oleksandrkorkh/Fuse_board/Test reports/V1 lifetime tests/pictures/Fuse Blow Test/Fuseboard_fuse_blow_test.jpg

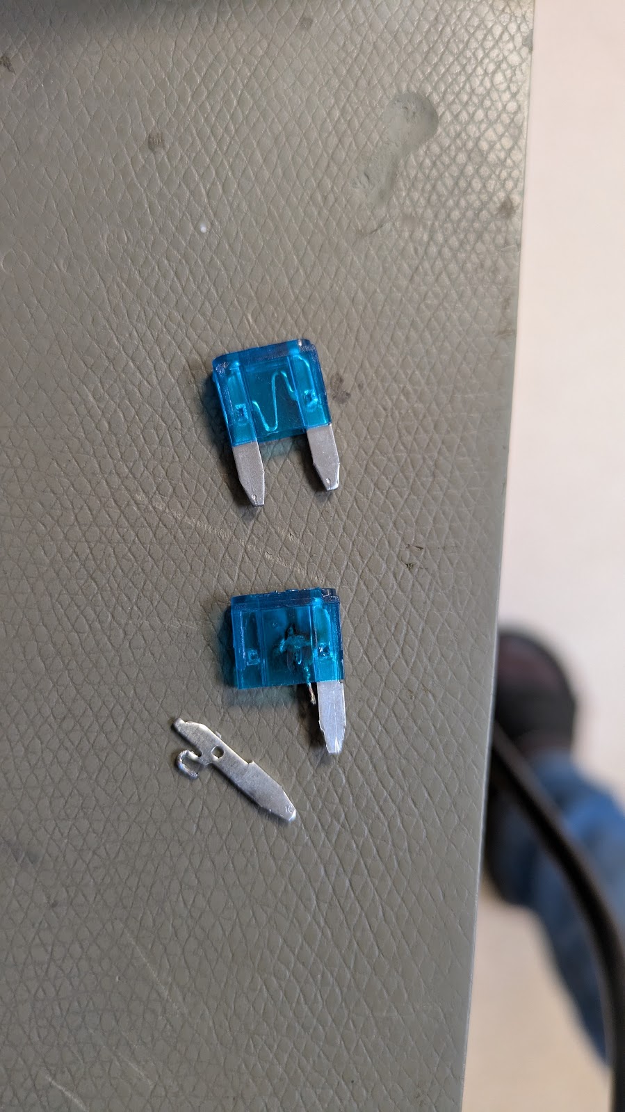
Test reports/V1 lifetime tests/pictures/Fuse Blow Test/Fuseboard_fuse_blow_test.jpg
