oleksandrkorkh/Fuse_board/Electronics/3V3 LDO/3V3 LDO design descriptiondocx.docx

# Introduction

3V3 LDO is required to power analogue circuits due to 3V3 SMPS having too high output ripple. LDO current capability has been calculated in 3.3V domain power consumption.xlxs document. Part number for the LDO has also

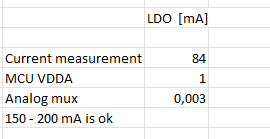
[picture p3: figure]

Figure 1 Current requirement calculation

# Circuit design

LDO circuit is designed after manufacturers typical application circuit and it has already been verified on other projects.

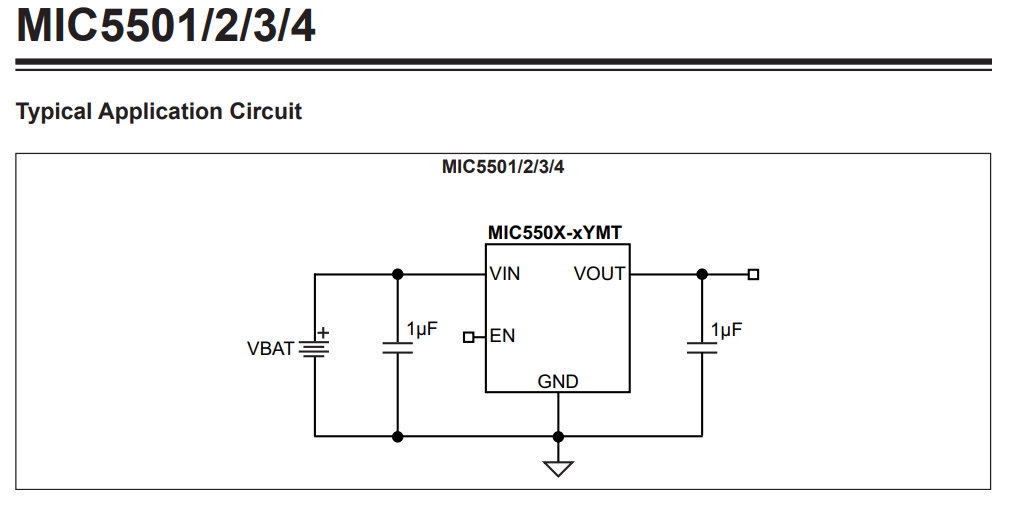
[picture p4: figure]

Figure 2 LDO manufacturers typical suggested circuit

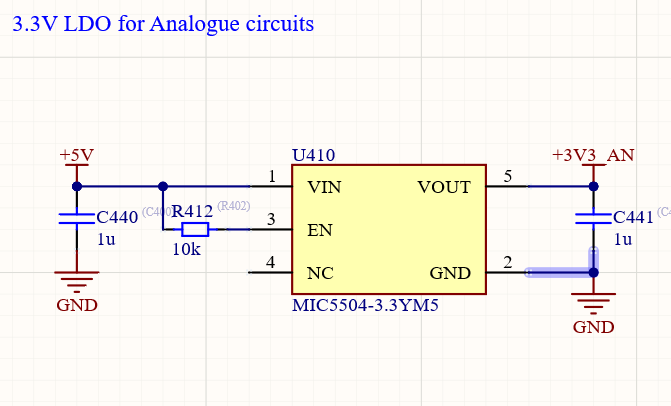
[picture p5: figure]

Figure 3. LDO implementation in the project

info@krakul.eu1

Project nr Document Author KR-Df-01 3V3 LDO design description Kaarel Koppel
