oleksandrkorkh/Fuse_board/Electronics/MCU/MCU design description.docx

# Introduction

STM32H573VIT6 is the MCU selected.

# High speed crystal oscillator

Evaluation kit has the following circuit.

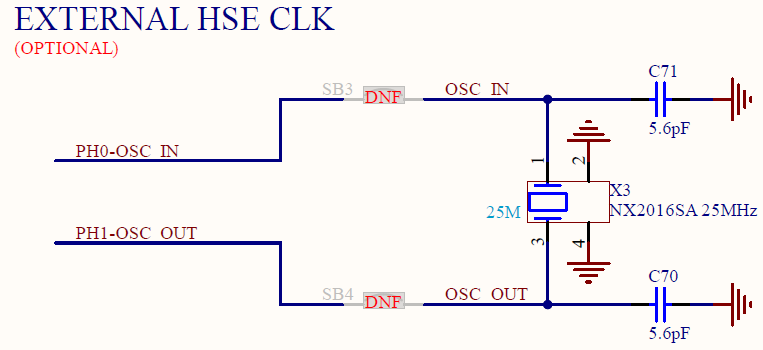
[picture p33: figure]

Figure 1: NUCLEO-H563ZI development board for STM32H563ZIT6 MCU

Acceptable external clock frequency range for the MCU is 4 to 50 MHz.

Typical circuit is suggested by the ST Application Note AN5711.

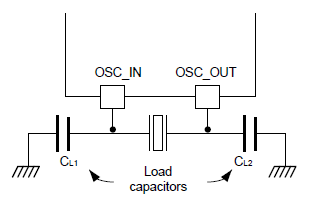
[picture p34: figure]

Figure 2: Typical application schematic

Datasheet suggests 10pF as PCB and MCU parasitic capacitance. This seems much and 6pF is used as approximation. Equation C1=C2=2 * (CL – Cstray) is used and it gives C1=C2=8pF. Closest nominal is 8,2pF.

ECS-250-10-37B-CTN-TR was selected from Krakul component library. It’s a 25MHz ±10ppm 10pF crystal.

# Power supply

VDD – Supply for I/O-s, internal regulator, reset, power management and internal clocks. 1.71 V – 3.6 V.

VDDA – Supply for ADC, DAC. Will be connected to 3,3V trough a ferrite bead.

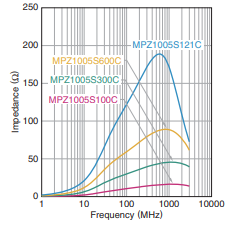
[picture p35: figure]

MPZ1005S121C is selected from Krakul library. Little effect is to be expected against regulator switching noise, but should reduce the RMII effect.

VDDUSB – USB supply 3.0 to 3.6V. Connect to VDD if not used.

VCAP1 and VCAP2 – 1.0 V – 1.2V. Digital core domain supply. Uses internal voltage regulator.

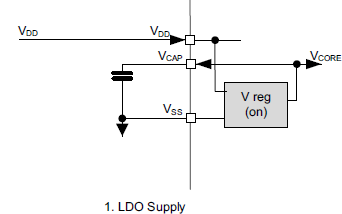
[picture p36: figure]

Figure 3: Vcore supply schematic.

Reference Manual RM0801 Rev 1 suggests 4,7 uF capacitor on VCAP pins. Single capacitor would create problems from layout side since pins 48 and 98 are at the opposite ends of the IC. Inspired from development board schematic both pins shall have a 2,2uF capacitor.

VREF+ and VREF- are for separate reference voltage if it needs to be different from VDD. In this case the VDDA +3,3V is the reference voltage.

VBAT is a backup supply for some registers and RTC. This function is not used in this application and the pin is left floating.

# RGB LED driver

Timer output capable of 800kHz PWM is needed for correctly driving the RGB LED. PB10 (pin number 47) is TIM2_CH3. TIM2 is a general purpose timer. The pin was selected as close to a VSS (GND) pin as possible. The signal is almost 1MHz and it’s desired to keep the return current path as short as possible.

# ADC

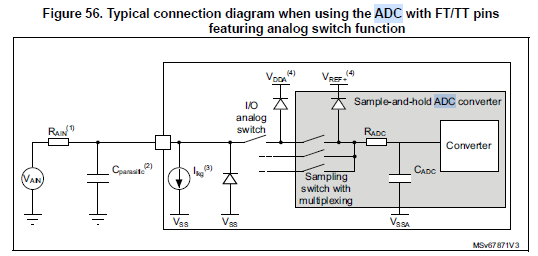
[picture p37: figure]

Figure 4: ADC input

Due to limited number of ADC inputs on the STM32H573VIT6 analog multiplexers are used.

There are 2 8 channel MUX that are controlled with digital pins. One MUX is for power output current measurement and the other is for power output voltage measurement.

TMUX1208PWR is selected for it’s price.

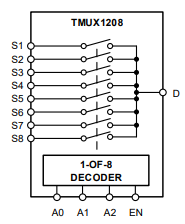
[picture p38: figure]

Figure 5: TMUX1208 internal diagram

Besides decoupling capacitor other external components are not mandatory, but 100Ω resistors will be added to encoding and enable pins.

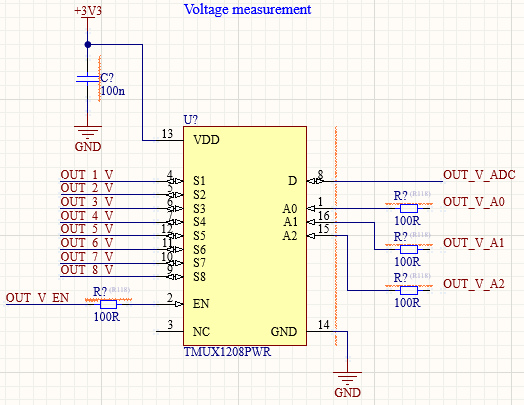
[picture p39: figure]

ADC input on the MCU shall not have the usual capacitor that can be used to mitigate the voltage drop created by sample and hold circuit. Extra capacitance on the trace from MUX to MCU creates a need to wait longer until the voltage at ADC stabilizes.

Instead the capacitors will be at the MUX inputs and the trace capacitance from MUX to MCU is kept minimum. This way 100nF capacitors before the MUX will force the ADC input to correct voltage relatively faster. The internal sample and hold capacitor inside this MCU is typically 3pF. Trace parasitic capacitance is likely order of magnitude greater.

# Configuration switch

To set HW mode for the MCU 8-bit dip switch is added.

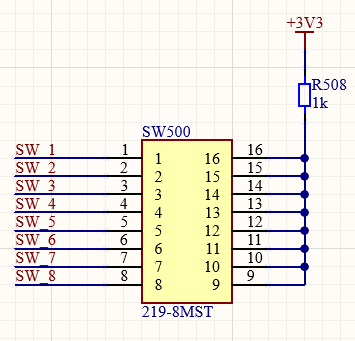
[picture p40: figure]

Figure 6: HW configuration switch.

Switch functions TBD.

# Programming interface

Serial wire debug (SWD) will be used for firmware download and debugging. It has following signals.

6 pin Tag connect with clamping legs will be used. SWD and reset signals have 100R series resistors and TVS diodes for short circuit and ESD protection.

3.3V connection has a series 0R resistor that can be removed if necessary.

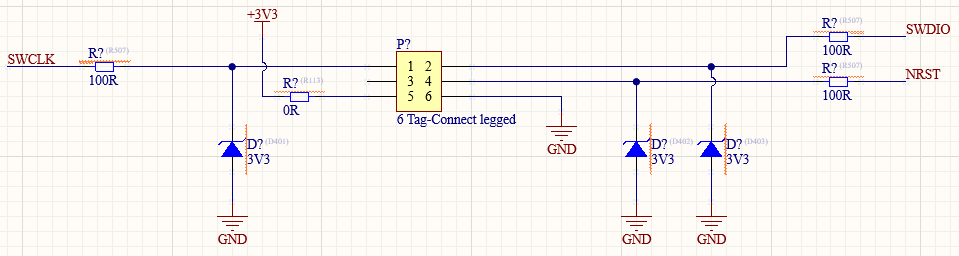
[picture p41: figure]

# Reset button.

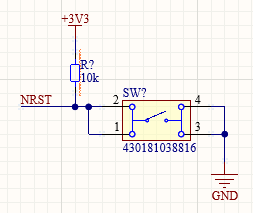
[picture p42: figure]

The button is for resetting the MCU manually during development phase.

info@krakul.eu1

Project nr Document Author KR-Df-01 Fuse board design description Indrek Keskküla
