oleksandrkorkh/Fuse_board/Specifications/2024-08-13 SW tasks estimation.xlsx

Task | Estimation (h)
On-board file system setup | 20
Create data storage manager | 20
Implement DHCP based IP acquiring | 10
Modbus RS-485 driver | 30
Modbus Etherner-RS-485 bridge | 30
Identification registers implementation | 6
Memory layout | 6
Configuration registers implementation | 20
Operational registers implementation | 10
Full relay logic implementation | 12
Critical error logging | 10
Top level operation logic | 20
Bootloader | TBD
Total | 194
