oleksandrkorkh/Fuse_board/Electronics/3V3 SMPS/3.3V domain power consumption.xlsx

 |  |  |  | LDO [mA]
Load | MAX[mA] | Notes
RS485 | 83.5 |  | Current measurement | 84
MCU | 203 |  | MCU VDDA | 1
Ethernet Phy | 129 |  | Analog mux | 0.003
Current measurement | 84 | 8 devices 10,5 mA maximum | 150 - 200 mA is ok
Total | 499.5 | mA
 |  |  | Feedtrough capacitors for analog switch control lines
1 A regulator is enough
 |  |  | SMPS frequency
Vout | 3.3
Cout
 |  |  |  |  | 3.3V Output
 |  |  | NFM18CC222R1C3D Murata Electronics | Mouser Estonia (https://www.mouser.ee/ProductDetail/Murata-Electronics/NFM18CC222R1C3D?qs=s6ARpXo6tuq4Pwfcr30BUw%3D%3D)
 |  |  | Light load
 |  |  | Period
 |  |  | 162337.6623 | Hz
 |  |  | Only some kHz | Feedtrogh capacitor does nothing. Skip
 |  |  | This one in Krakul library
 |  |  | Name | Value
 |  |  | Part number | MIC5504-3.3YM5
