oleksandrkorkh/Fuse_board/Electronics/MCU/PIN Map.xlsx

Sheet: Sheet1
Inputs | 8
Outputs | 8
ADCs | 18
Programming SWD | 4
Crystal | 2
RMII | 9
UART/ RS-485 | 2
neopixel | 2
STM32H563ZIT3Q (https://estore.st.com/en/stm32h563zit3q-cpn.html)
Must select 144 pin device |  | 100 pin device does not support ethernet and 125 operating temperature at the same time

Sheet: QFN100
 |  | STM32H573VIT6 | STM32H573VIT6 - eStore - STMicroelectronics (https://estore.st.com/en/stm32h573vit6-cpn.html)
Pin Nr | Pin Name | Function | Comment
1 | PE2 | RS485_T
2 | PE3 | OUT_I_EN | Current measurement MUX control
3 | PE4 | OUT_I_A0
4 | PE5 | OUT_I_A1
5 | PE6 | OUT_I_A2
6 | VBAT | POWER
7 | PC13
8 | PC14-OSC32_IN
9 | PC15-OSC32_OUT
10 | VSS
11 | VDD
12 | PH0-OSC_IN | Crystal
13 | PH1-OSC_OUT | Crystal
14 | NRST | Reset
15 | PC0
16 | PC1 | RMII_MDC | +
17 | PC2
18 | PC3 | PWR_IN_V_ADC
19 | VSSA | POWER
20 | VREF- | POWER
21 | VREF+ | POWER
22 | VDDA | POWER
23 | PA0 | ETH_nRST
24 | PA1 | RMII_REFCLK | +
25 | PA2 | RMII_MDIO | +
26 | PA3
27 | VSS | POWER
28 | VDD | POWER
29 | PA4
30 | PA5 | RMII_TXEN | +
31 | PA6
32 | PA7 | RMII_CRS_DV | +
33 | PC4 | RMII_RXD0
34 | PC5 | RMII_RXD1
35 | PB0 | OUT_V_ADC
36 | PB1 | OUT_I_ADC
37 | PB2
38 | PE7 | OUT_V_EN | Voltage measurement MUX control
39 | PE8 | OUT_V_A0
40 | PE9 | OUT_V_A1
41 | PE10 | OUT_V_A2
42 | PE11
43 | PE12
44 | PE13 | LED_PWR_EN
45 | PE14
46 | PE15
47 | PB10 | LED_DATA
48 | VCAP | POWER
49 | VSS | POWER
50 | VDD | POWER
51 | PB12 | RMII_TXD0
52 | PB13
53 | PB14
54 | PB15 | RMII_TXD1
55 | PD8 | OUT_1_EN | Active HIGH. Drive high to enable output. Pull-up/-down not needed.
56 | PD9 | OUT_2_EN
57 | PD10 | OUT_3_EN
58 | PD11 | OUT_4_EN
59 | PD12 | OUT_5_EN
60 | PD13 | OUT_6_EN
61 | PD14 | OUT_7_EN
62 | PD15 | OUT_8_EN
63 | PC6
64 | PC7
65 | PC8 | USB_SOF - Reserved
66 | PC9 | USB_DM - Reserved
67 | PA8 | USB_DP - Reserved
68 | PA9
69 | PA10
70 | PA11
71 | PA12
72 | PA13 | SWDIO
73 | VDDUSB | POWER
74 | VSS | POWER
75 | VDD | POWER
76 | PA14 | SWCLK
77 | PA15 | BTN_1 | Button inputs. Activate internal pull-down for these inputs.
78 | PC10 | BTN_2
79 | PC11 | BTN_3
80 | PC12 | BTN_4
81 | PD0 | BTN_5
82 | PD1 | BTN_6
83 | PD2 | BTN_7
84 | PD3 | BTN_8
85 | PD4
86 | PD5 | SW_1 | HW configuration switch input
87 | PD6 | SW_2
88 | PD7 | SW_3
89 | PB3 | SW_4
90 | PB4 | SW_5
91 | PB5 | SW_6
92 | PB6 | SW_7
93 | PB7 | SW_8
94 | BOOT0
95 | PB8
96 | PB9 | RS485_DIR
97 | PE0 | RS485_R
98 | VCAP | POWER
99 | VSS | POWER
100 | VDD | POWER

Sheet: PIN Map QFN100 SMPS
 |  |  | Ethernet functions
1 | PE2 | BTN1
2 | PE3 | BTN2
3 | PE4 | BTN3
4 | PE5 | BTN4 |  | MII | 17 signals
5 | PE6 | BTN5 |  | RMII | 9 signals
6 | VBAT
7 | PC13 | BTN6
8 | PC14-OSC32_IN | BTN7
9 | PC15-OSC32_OUT | BTN8
10 | VSS
11 | VDD
12 | PH0-OSC_IN
13 | PH1-OSC_OUT
14 | NRST
15 | PC0 | LED_DATA
16 | PC1 | LED_PWE_EN
17 | PC2
18 | PC3
19 | VSSA
20 | VREF+
21 | VDDA
22 | PA0
23 | PA1 |  | ETH_RMII_REF_CLK
24 | PA2
25 | PA3
26 | VSS
27 | VDD
28 | PA4
29 | PA5 |  | ETH_RMII_TX_EN
30 | PA6
31 | PA7 |  | ETH_RMII_CRS_DV
32 | PB0
33 | PB1
34 | PB2
35 | PE7
36 | PE8
37 | PE9
38 | PE10
39 | PE11
40 | PE12
41 | PE13
42 | PE14
43 | PE15
44 | PB10
45 | PB11 |  | ETH_RMII_TX_EN
46 | VLXSMPS
47 | VDDSMPS
48 | VSSSMPS
49 | VCAP
50 | VSS
51 | VDD
52 | PB13
53 | PB14
54 | PB15 |  | ETH_RMII_TXD1
55 | PD8
56 | PD9
57 | PD10
58 | PD11
59 | PD12
60 | PD13
61 | PD14
62 | PD15
63 | PC6
64 | PC7
65 | PC8
66 | PC9
67 | PA8
68 | PA9
69 | PA10
70 | PA11
71 | PA12
72 | PA13
73 | VDDUSB
74 | VSS
75 | VDD
76 | PA14
77 | PA15
78 | PC10 |  | ETH_RMII_TXD0
79 | PC11
80 | PC12
81 | PD0
82 | PD1
83 | PD2
84 | PD3
85 | PD4
86 | PD5
87 | PD6
88 | PD7
89 | PB3
90 | PB4
91 | PB5
92 | PB6
93 | PB7
94 | BOOT0
95 | PB8
96 | PB9
97 | PE0
98 | VCAP
99 | VSS
100 | VSS

Sheet: QFN144 SMPS
1 | PE2
2 | PE3 |  | STM32H573VI | These two does not have
3 | PE4 |  | STM32H573ZI
4 | PE5
5 | PE6
6 | VBAT | Power
7 | PC13
8 | PC14-OSC32_IN | Not used
9 | PC15-OSC32_OUT | Not used
10 | PF0
11 | PF1
12 | PF2
13 | PF3
14 | PF4
15 | PF5
16 | VSS | Power
17 | VDD | Power
18 | PF6
19 | PF7
20 | PF8
21 | PF9
22 | PF10
23 | PH0-OSC_IN | Crystal
24 | PH1-OSC_OUT | Crystal
25 | NRST | nReset
26 | PC0
27 | PC1
28 | PC2
29 | PC3
30 | VSSA | Power
31 | VREF+ | Power
32 | VDDA | Power
33 | PA0
34 | PA1 | ETH_RMII_REF_CLK
35 | PA2
36 | PA3
37 | VSS | Power
38 | VDD | Power
39 | PA4
40 | PA5 | ETH_RMII_TX_EN
41 | PA6
42 | PA7 | ETH_RMII_CRS_DV
43 | PB0
44 | PB1
45 | PB2
46 | PF11
47 | PF12
48 | VSS | Power
49 | VDD | Power
50 | PF13
51 | PF14
52 | PF15
53 | PG0
54 | PG1
55 | PE7
56 | PE8
57 | PE9
58 | VSS | Power
59 | VDD | Power
60 | PE10
61 | PE11
62 | PE12
63 | PE13
64 | PE14
65 | PE15
66 | PB10
67 | PB11 | ETH_RMII_TX_EN
68 | VLXSMPS | Power
69 | VDDSMPS | Power
70 | VSSSMPS | Power
71 | VCAP | Power
72 | VSS | Power
73 | VDD | Power
74 | PB13
75 | PB14
76 | PB15 | ETH_RMII_TXD_1
77 | PD8
78 | PD9
79 | PD10
80 | PD11
81 | PD12
82 | PD13
83 | VSS | Power
84 | VDD | Power
85 | PD14
86 | PD15
87 | PG2
88 | PG3
89 | PG4
90 | PG5
91 | PG6
92 | PG7
93 | PG8
94 | VSS | Power
95 | VDD | Power
96 | PC6
97 | PC7
98 | PC8
99 | PC9
100 | PA8
101 | PA9
102 | PA10
103 | PA11
104 | PA12
105 | PA13
106 | VDDUSB | Power
107 | VSS | Power
108 | VDD | Power
109 | PA14
110 | PA15
111 | PC10
112 | PC11 | ETH_RMII_TXD_0
113 | PC12
114 | PD0
115 | PD1
116 | PD2
117 | PD3
118 | PD4
119 | PD5
120 | VSS | Power
121 | VDDIO2 | Power
122 | PD6
123 | PD7
124 | PG9
125 | PG10
126 | PG12 | ETH_RMII_TXD_1
127 | PG13 | ETH_RMII_TXD_0
128 | PG14 | ETH_RMII_TXD_1
129 | VSS | Power
130 | VDD | Power
131 | PG15
132 | PB3
133 | PB4
134 | PB5
135 | PB6
136 | PB7
137 | BOOT0
138 | PB8
139 | PB9
140 | PE0
141 | PE1
142 | VCAP | Power
143 | VSS | Power
144 | VDD | Power
