oleksandrkorkh/Fuse_board/Electronics/Power output/Fuse board power output design notes.xlsx

Sheet: Sheet1
Relay |  |  |  |  |  | Connector for power
 |  |  |  |  |  | 5-1437657-7 - Buchanan - Te Connectivity - PCB Mount Barrier Terminal Block, 11.13 mm, 1 Row (farnell.com) (https://ee.farnell.com/te-connectivity-buchanan/5-1437657-7/terminal-block-barrier-2pos-10awg/dp/3399492)
https://ee.farnell.com/omron-electronic-components/p2r-05p/socket-pcb-g2r-3r-relay/dp/9945415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
V23074A2002A403-EV-CBOX - Te Connectivity - Automotive Relay, 24 VDC, 30 A (farnell.com) (https://ee.farnell.com/te-connectivity/v23074a2002a403-ev-cbox/automotive-relay-spdt-30a-24v/dp/2783747) |  |  | With diode | Use V23074-A1002-A403
VCFM-1000 - Te Connectivity - Relay Socket, Through Hole, Solder (farnell.com) (https://ee.farnell.com/te-connectivity/vcfm-1000/relay-socket-5-pos-tht/dp/3133659?st=1393310-2)
Fuse
MCCQ-122 - Multicomp Pro - Fuseholder, PCB Mount, Automotive (farnell.com) (https://ee.farnell.com/multicomp/mccq-122/fuseholder-pcb-mount-mini-blade/dp/1586595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)
Automotive relay rating seem low | 27V
1,4 x rated voltage on ok | Otsi dokumendist "limiting voltage" | DDEController (te.com) (https://www.te.com/commerce/DocumentDelivery/DDEController?Action=showdoc)
24V releel 33,4V
 |  |  |  |  | 5.85
 |  |  |  |  | 2.15 |  | 7.35

Sheet: PCB relay
General purpose relays: https://www.mouser.ee/c/electromechanical/relays-contactors-solenoids/general-purpose-relays/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
There are limited number of PCB mounted 24V relays available that have sufficient current ratings
T9GV5L14-24 : Potter & Brumfield PCB Power Relay: 30 amp, Monostable DC | TE Connectivity (https://www.te.com/usa-en/product-1558660-7.html)
This is one
G5LE-1-E DC24 Omron Electronics Inc-EMC Div | Relays | DigiKey (https://www.digikey.ee/en/products/detail/omron-electronics-inc-emc-div/G5LE-1-E-DC24/1277877)
Coil voltage to low for 32V operation. No overhead for short circuit currents (I-max = 16V)
J1071CS3VDC.36 CIT Relay and Switch | Relays | DigiKey (https://www.digikey.ee/en/products/detail/cit-relay-and-switch/J1071CS3VDC-36/18734612) |  |  |  | <-- | Go with this but test before first prototype.
3V coil. Current rating low, but should be tested |  |  |  |  | Available only at digikey | J1071CS3VDC.36
https://www.digikey.ee/en/products/detail/cit-relay-and-switch/J107F1CS203VDC-80/14001947
Better current rating, but coil current too high ~ 270 mA
J1071CS5VDC.36 |  |  | This fails when the current at the time of turn-off exceeds 5A |  |  |  | J1071CS5VDC.36 CIT Relay and Switch | Relays | DigiKey (https://www.digikey.com/en/products/detail/cit-relay-and-switch/J1071CS5VDC-36/18734609)
 |  |  | 22uF and 0,1 Ω snubber in parallel with the load allowd for 10A switching
I | 25 | A
C | 62.5 | uF
E0 | 32 | V
R | 0.04995121951 | Ω
Alternative
J107F1CS205VDC.45 (https://www.digikey.com/en/products/detail/cit-relay-and-switch/J107F1CS205VDC-45/14000915)
1200 W | 50A
24
4713-GMC31X5R336M25NTCT-ND |  |  | x 10
WSLP-.05CT-ND |  |  | x 10

Sheet: Terminal block
DGPS2.5R-5.0-02P |  |  | Current rating low
 |  |  | 10mm2 cross area requirement. AWG 8 | But no. Is ok
 |  |  |  | Except the lower cross section area
Cross section area must be up to 2,5mm2
Current up to 15A.
2,5mm2 | ~ | 13AWG
0,5mm2 | ~ | 20AWG
Truly only one option pops out
1986711-2 TE Connectivity AMP Connectors | Connectors, Interconnects | DigiKey (https://www.digikey.ee/en/products/detail/te-connectivity-amp-connectors/1986711-2/3189857)
 |  |  |  | Is ok
