oleksandrkorkh/Fuse_board/Electronics/RS485/RS485 design description.xlsx

DE09-PT-1-JS Adam Tech | Connectors, Interconnects | DigiKey (https://www.digikey.ee/en/products/detail/adam-tech/DE09-PT-1-JS/9832576)
L717TSEH09POL2RM8 Amphenol ICC (Commercial Products) | Connectors, Interconnects | DigiKey (https://www.digikey.ee/en/products/detail/amphenol-cs-commercial-products/L717TSEH09POL2RM8/4886900)
Use this. Has 3D models and better mechanical attachment to PCB
L717TSEH09POL2RM8
