oleksandrkorkh/Fuse_board/Electronics/5V SMPS/SMPS calculations.xlsx

Vout | 5.07
Vfb | 1.011
Rfbt | 100000
Rfbb | 24907.61271
Vout | 5.07
