oleksandrkorkh/Fuse_board/Electronics/Ethernet/Ethernet design description.xlsx

 |  |  |  |  |  | ETH_REF_CLK
 |  |  |  |  |  | ETH_RXD[1:0]
 |  |  |  |  |  | ETH_RX_DV
 |  |  |  |  |  | ETH_CRS_DV
 |  |  |  |  |  | ETH_RX_ER
 |  |  |  |  |  | ETH_TXD[1:0]
 |  |  |  |  |  | ETH_TX_EN
 |  |  |  |  | ETH_MDC
 |  |  |  |  | ETH_nRST
 |  |  |  |  | ETH_RMII_REF_CLK
 |  |  |  |  | ETH_MDIO
 |  |  |  |  | ETH_RMII_TX_EN
 |  |  |  |  | ETH_RMII_CRS_DV
 |  |  |  |  | ETH_RMII_RXD0
 |  |  |  |  | ETH_RMII_RXD1
 |  |  |  |  | ETH_RMII_TXD0
 |  |  |  |  | ETH_RMII_TXD1
 | Length tables
Signal | Before resistor | After resistor | Total | Dif
RMII_TXD1 | 40.344 | 5.216 | 45.56
RMII_TXD0 | 41.317 | 4.203 | 45.52 | 0.04
RMII_RXD1 | 42.392 | 3.197 | 45.589 | -0.029
RMII_RXD0 | 41.934 | 3.59 | 45.524 | 0.036
RMII_CRC_DV | 42.247 | 3.273 | 45.52 | 0.04
RMII_TXEN | 36.073 | 9.394 | 45.467 | 0.093
RMII_MDIO | 45.564 |  | 45.564 | -0.004
RMII_REFCLK | 41.311 | 4.183 | 45.494 | 0.066
RMII_MDC | 45.643 |  | 45.643 | -0.083
