oleksandrkorkh/Fuse_board/Mechanics/Mechanics/2025.03.05 Case and base plate design/renders/jpeg/56f5e6a8-57b0-4b65-b9d8-96817e39d799.JPEG

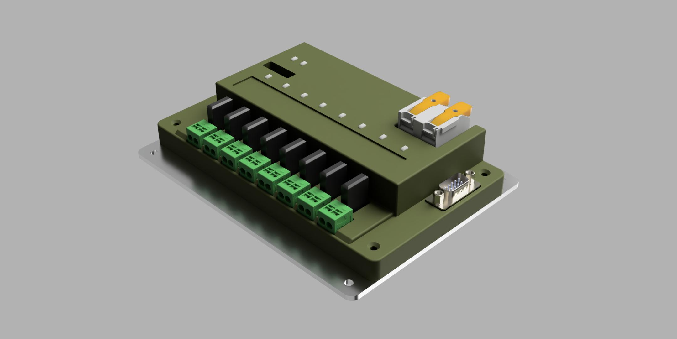
Mechanics/Mechanics/2025.03.05 Case and base plate design/renders/jpeg/56f5e6a8-57b0-4b65-b9d8-96817e39d799.JPEG
