oleksandrkorkh/Fuse_board/Electronics/BOM Exports/BOM Export 2023_12_04.xlsx

Line # | Name | Description | Designator | Revision ID | Revision State | Revision Status | Quantity | Manufacturer 1 | Manufacturer Part Number 1 | Manufacturer Lifecycle 1 | Supplier 1 | Supplier Part Number 1 | Supplier Unit Price 1 | Supplier Subtotal 1 | BOM Status
 | MCCQ-122 | Fuseholder, Pcb Mount, Mini Blade | F100, F101, F102, F103, F104, F105, F106, F107 | CMP-ROOT-01049-2 | Draft | Up to date | 8 | Multicomp | MCCQ-122 | Volume Production | Farnell | 1586595 | 0.68914 | 5.51 | Warning
 | 1393310-2 | Relay Accessories Relay Socket for Electromechanical Relay. Micro ISO | K100, K101, K102, K103, K104, K105, K106, K107 | CMP-ROOT-01050-1 | Draft | Up to date | 8 | TE Connectivity P&B | 1393310-2 | Volume Production | Newark | 90B5439 | 3.51 | 28.08 | Warning
 | RJLSE-42381-01T | Jack Modular Connector 8p8c (RJ45, Ethernet) 90° Angle (Right) Shielded | P200 | CMP-ROOT-00032-2 | Draft | Up to date | 1 | Amphenol Commercial | RJLSE4238101T | Volume Production |  |  |  |  | Fatal error
 | A-DS-09-A/KG-T2S | 09P D-SUBCONN R/A USA STANDARD | P300, P301 | CMP-ROOT-01022-1 | Draft | Up to date | 2 | Assmann | A-DS-09-A/KG-T2S | Volume Production | Arrow Electronics | A-DS 09 A/KG-T2S | 0.6563 | 1.31 | Warning
 | 430181038816 | Switch Tactile Spst-no 0.05A 12V | SW600, SW601, SW602, SW603, SW604, SW605, SW606, SW607 | CMP-ROOT-00883-1 | Draft | Up to date | 8 | Wurth Electronics | 430181038816 | Volume Production | Digi-Key | 732-7003-1-ND | 0.53 | 4.24 | Warning
Relay not part of PCBA BOM
P/N used in final assembly V23074-A1002-A403
