oleksandrkorkh/Fuse_board/Production files/PCBA-KR-Df-01-EL-00-MASTER-A.3/BOM/BOM_KR-Df-01-EL-00_vv1_2024-12-20.xlsx

Bill of Materials |  |  | KR-Df-01-EL-00
Source Data From: |  | KR-Df-01-EL-00.BomDoc
Project: |  | Fuse Board
Variant: |  | Master
Project EE: |  | IK
Creation Date: | 20/12/2024 | 15:21
Print Date: | 2024-12-20 | 15:21:44
Production Quantity: | 10
Currency | EUR
BOM cost per unit | 0
Part number | Quantity | Description | Designator | LibRef | Manufacturer | Supplier 1 | Supplier Part Number 1 | Supplier Order Qty 1 | Supplier Unit Price 1 | Supplier Subtotal 1
SN65HVD12DR | 1 | 1/1 Transceiver Half RS422, RS485 8-SOIC | U300 | CMP-ROOT-01068-1 | TI
744029001 | 1 | 1µH Shielded Wirewound Inductor 2.2A 55mOhm Max Nonstandard | L400 | CMP-ROOT-00305-1 | Wurth Electronics Inc.
MIC5504-3.3YM5 | 1 | 3.3V 300mA LDO | U410 | CMP-ROOT-00999-4 | Microchip Technology
TMUX1208PWR | 2 | 5-V, 8: 1, 1-channel general-purpose analog multiplexer with 1.8-V input logic 16-TSSOP -40 to 125 | U501, U502 | CMP-ROOT-01067-2 | TI
CRCW060310R0JNEAHP | 2 | 10R 0603 Pulse-proof 1/3W | R301, R304 | CMP-0001-00279-2 | Vishay
ECS-250-10-37B-CTN-TR | 2 | 25MHz ±10ppm Crystal 10pF 50 Ohms 4-SMD, No Lead | Xtal200, Xtal500 | CMP-001-1313-1 | ECS Inc.
STM32H573VIT6 | 1 | Armï¿½ Cortexï¿½-M33 32-bit MCU+TrusZoneï¿½ + FPU, 360 DMIPS @240MHz, 2 Mbytes Flash, 640 Kbytes RAM, Math accelerators | U500 | CMP-ROOT-01065-3 | STMicroelectronics
CDSOT23-SM712 | 1 | BOURNS - CDSOT23-SM712 - Transient Voltage Suppressor, TVS, CDSOT23 Series, Unidirectional, 12 V, SOT-23, 3, 13.3 V | D300 | CMP-ROOT-00649-3 | Bourns Inc.
LM46002AQPWPRQ1 | 1 | Buck Switching Regulator IC Positive Adjustable 1V 1 Output 2A 16-TSSOP (0.173", 4.40mm Width) Exposed Pad | U409 | CMP-ROOT-00198-2 | Texas Instruments
L717TSEH09POL2RM8 | 2 | Conn D-Subminiature PIN 9 POS 1.37mm Solder ST Thru-Hole 9 Terminal 1 Port | J300, J301 | CMP-ROOT-01058-3 | Amphenol ICC
RJHSE-5384 | 1 | CONN MOD JACK 8P8C R/A SHIELDED, LEFT GREEN, RIGHT YELLOW | P200 | CMP-001-1345-1 | Amphenol ICC
GND_BUSBAR_1 | 1 | Custom GND busbar for DefSecIntel fuse board | BB401 | CMP-ROOT-01092-5 | Krakul
PWR_BUSBAR_1 | 1 | Custom PWR busbar for DefSecIntel fuse board. | BB400 | CMP-ROOT-01072-9 | Krakul
BAT6404WH6327XTSA1 | 9 | Diode Array 1 Pair Series Connection Schottky 40V 120mA Surface Mount SC-70, SOT-323 | D111, D112, D113, D117, D118, D119, D122, D123, D400 | CMP-ROOT-00071-1 | Infineon
MBR0530 | 1 | Diode Schottky 30V 500mA Surface Mount SOD-123 | D610 | CMP-ROOT-00224-1 | ON Semiconductor
SS24FL | 8 | Diode Schottky 40V 2A Surface Mount SOD-123F | D108, D109, D110, D114, D115, D116, D120, D121 | CMP-ROOT-00473-1 | ON Semiconductor
SMF48A | 8 | Diode TVS Single Uni-Dir 48V 200W 2-Pin SOD-123F T/R | D100, D101, D102, D103, D104, D105, D106, D107 | CMP-ROOT-01053-2 | Littelfuse
D5V0P4UR6SO-7 | 1 | DIODES INC. - D5V0P4UR6SO-7 - ESD Protection Device, 1.2 V, SOT-26, 6 Pins, 3.6 V, 300 mW | D200 | CMP-ROOT-00693-1 | Diodes Inc
BLM18RK601SN1D | 1 | Ferrite Beads Multi-Layer 600Ohm 25% 100MHz 200mA 600mOhm DCR 0603 T/R | FB200 | CMP-ROOT-01073-2 | Murata
- | 6 | Fiducial, round, 1mm diam | Fid100, Fid101, Fid102, Fid103, Fid104, Fid105 | CMP-001-1226-1 | -
MCCQ-122 | 8 | Fuseholder, Pcb Mount, Mini Blade | F100, F101, F102, F103, F104, F105, F106, F107 | CMP-ROOT-01049-2 | Multicomp
MCS1802GS-20-Z | 8 | Hall Effect-Based Linear Current Sensor IC ±20A 66mV/A 100kHz 8-Pin SOIC T/R | U400, U401, U402, U403, U404, U405, U406, U407 | CMP-ROOT-01063-2 | MPS
61300211121 | 1 | Headers & Wire Housings WR-PHD 2.54mm 2Pin THT Header | P300 | CMP-001-1357-2 | Wurth
SRP0420-6R8K | 1 | Inductor Power Shielded Wirewound 6.8uH 10% 100KHz 27Q-Factor Metal Alloy Powder 2.6A 0.117Ohm DCR T/R | L401 | CMP-ROOT-01075-2 | Bourns
2616-1352 | 1 | Lever actuated terminal block, Wire-to-board. 78A, 300V, 4-18 AWG | J400 | CMP-ROOT-01061-1 | WAGO
VLPR-24-1028-2 | 10 | Light Pipe, Rigid, Vertical, Board Mount, Smd Led, 1.028 In., 4 Mm X 2 Mm Rectangular Face | ME600, ME601, ME602, ME603, ME604, ME605, ME606, ME607, ME608, ME609 | CMP-ROOT-01098-2 | Bivar
MLCC, 0402, 8.2p, 5%, 50V, C0G/NP0 | 4 | MLCC, 0402, 8.2p, 5%, 50V, C0G/NP0 | C207, C208, C506, C507 | CMP-0001-00091-2 | Any
MLCC, 0402, 10n, 10%, 50V, X5R | 8 | MLCC, 0402, 10n, 10%, 50V, X5R | C403, C405, C407, C413, C415, C417, C419, C422 | CMP-0001-00209-2 | Any
MLCC, 0402, 47p, 10%, 50V, X7R | 1 | MLCC, 0402, 47p, 10%, 50V, X7R | C435 | CMP-0001-00149-2 | Any
MLCC, 0402, 100n, 10%, 10V, X5R | 64 | MLCC, 0402, 100n, 10%, 10V, X5R | C103, C104, C105, C109, C110, C111, C114, C115, C116, C117, C118, C119, C120, C121, C122, C123, C202, C203, C206, C209, C210, C213, C301, C404, C406, C408, C414, C416, C418, C420, C423, C424, C426, C427, C428, C439, C500, C501, C504, C505, C508, C509, C510, C511, C512, C513, C600, C601, C602, C603, C604, C605, C606, C607, C608, C609, C610, C611, C612, C613, C614, C615, C616, C617 | CMP-001-1256-2 | Any
MLCC, 0402, 100n, 10%, 50V, X7R | 1 | MLCC, 0402, 100n, 10%, 50V, X7R | C433 | CMP-0001-00196-2 | Any
MLCC, 0402, 470n, 10%, 50V, X5R | 1 | MLCC, 0402, 470n, 10%, 50V, X5R | C434 | CMP-0001-00217-2 | Any
MLCC, 0402, 470p, 5%, 50V, C0G/NP0 | 1 | MLCC, 0402, 470p, 5%, 50V, C0G/NP0 | C204 | CMP-0001-00137-2 | Any
MLCC, 0603, 1u, 10%, 10V, X7R | 12 | MLCC, 0603, 1u, 10%, 10V, X7R | C205, C400, C401, C402, C409, C410, C411, C412, C421, C438, C440, C441 | CMP-001-0642-2 | Any
MLCC, 0603, 2.2u, 10%, 16V, X5R | 3 | MLCC, 0603, 2.2u, 10%, 16V, X5R | C437, C502, C503 | CMP-001-1459-1 | Any
MLCC, 0603, 10u, 10%, 25V, X5R | 4 | MLCC, 0603, 10u, 10%, 25V, X5R | C200, C201, C425, C429 | CMP-001-1355-1 | Any
C2012X5R1V226M125AC | 24 | MLCC, 0805, 22u, 20%, 35V, X5R | C124, C125, C126, C127, C128, C129, C130, C131, C132, C133, C134, C135, C136, C137, C138, C139, C140, C141, C142, C143, C144, C145, C146, C147 | CMP-001-1665-1 | TDK
MLCC, 0805, 33n, 10%, 50V, X7R | 10 | MLCC, 0805, 33n, 10%, 50V, X7R | C100, C101, C102, C106, C107, C108, C112, C113, C300, C302 | CMP-001-1076-2 | Any
MLCC, 1206, 1n, 10%, 2kV, X7R | 2 | MLCC, 1206, 1n, 10%, 2kV, X7R | C211, C212 | CMP-001-1275-2 | Any
MLCC, 1206, 47u, 10%, 10V, X5R | 1 | MLCC, 1206, 47u, 10%, 10V, X5R | C436 | CMP-001-1106-2 | Any
MLCC, 1210, 4.7u, 10%, 100V, X7S | 3 | MLCC, 1210, 4.7u, 10%, 100V, X7S | C430, C431, C432 | CMP-001-1296-1 | Any
MM3Z8V2ST1G | 1 | MM3Z8V2ST1 Series 200 mW 10 mA 8.2 V SMT Zener Voltage Regulator - SOD-323 | D402 | CMP-ROOT-00931-1 | onsemi
BSS123 | 10 | MOSFET N-CH 100V 170MA SOT-23 | Q100, Q101, Q102, Q103, Q104, Q105, Q106, Q107, Q601, Q602 | CMP-ROOT-00113-5 | ON Semiconductor
DMG2305UX-13 | 1 | P-Channel 20V 4.2A (Ta) 1.4W (Ta) Surface Mount SOT-23 | Q600 | CMP-ROOT-00017-1 | Diodes Incorporated
SQ2361CEES-T1_GE3 | 1 | P-Channel 60V 2,8A SOT-23-3 | Q400 | CMP-ROOT-01117-1 | Vishay
J107F1CS205VDC.45 | 8 | RELAY GEN PURPOSE SPDT 20A 5V | K100, K101, K102, K103, K104, K105, K106, K107 | CMP-ROOT-01122-1 | CIT Relay and Switch
TLRZ2BTTD | 10 | Res Metal Plate 1206 0 Ohm Sulfur Resistant Pad SMD Automotive T/R | R101, R103, R105, R113, R115, R117, R125, R127, R410, R513 | CMP-0001-00276-2 | KOA Speer Electronics
Resistor, 0402, 1k, 1%, 1/16W | 1 | Resistor, 0402, 1k, 1%, 1/16W | R405 | CMP-001-0340-2 | Any
Resistor, 0402, 1.5k, 1%, 1/16W | 1 | Resistor, 0402, 1.5k, 1%, 1/16W | R201 | CMP-001-0344-2 | Any
Resistor, 0402, 10R, 1%, 1/16W | 7 | Resistor, 0402, 10R, 1%, 1/16W | R202, R203, R204, R205, R206, R207, R209 | CMP-001-0292-2 | Any
Resistor, 0402, 12.1k, 1%, 1/16W | 6 | Resistor, 0402, 12.1k, 1%, 1/16W | R208, R215, R221, R222, R223, R224 | CMP-001-1424-1 | Any
Any | 1 | Resistor, 0402, 24.9k, 1%, 1/10W | R408 | CMP-0001-00027-1 | Any
Resistor, 0402, 39.2k, 1%, 1/10W | 1 | Resistor, 0402, 39.2k, 1%, 1/10W | R409 | CMP-0001-00015-2 | Any
Resistor, 0402, 49.9R, 1%, 1/16W | 4 | Resistor, 0402, 49.9R, 1%, 1/16W | R210, R211, R212, R213 | CMP-001-1276-1 | Any
Resistor, 0402, 270R, 1%, 1/16W | 2 | Resistor, 0402, 270R, 1%, 1/16W | R216, R218 | CMP-001-0326-2 | Any
Resistor, 0402, 499R, 1%, 1/16W | 1 | Resistor, 0402, 499R, 1%, 1/16W | R214 | CMP-001-1365-1 | Any
Any | 19 | Resistor, 0603, 1k, 0.1%, 1/16W | R135, R136, R137, R141, R142, R143, R146, R147, R401, R508, R600, R601, R602, R603, R604, R605, R606, R607, R612 | CMP-0001-00237-1 | Any
Resistor, 0603, 10k, 1%, 1/10W | 35 | Resistor, 0603, 10k, 1%, 1/10W | R108, R110, R111, R120, R121, R123, R129, R131, R132, R133, R134, R138, R139, R140, R144, R145, R200, R217, R300, R302, R305, R306, R400, R402, R412, R415, R509, R514, R518, R519, R520, R521, R608, R610, R611 | CMP-001-0101-2 | Any
Resistor, 0603, 44.2k, 0.1%, 1/10W | 1 | Resistor, 0603, 44.2k, 0.1%, 1/10W | R404 | CMP-001-1616-1 | Any
Resistor, 0603, 75R, 1%, 1/10W | 2 | Resistor, 0603, 75R, 1%, 1/10W | R219, R220 | CMP-001-0051-3 | Any
Resistor, 0603, 100R, 1%, 1/10W | 20 | Resistor, 0603, 100R, 1%, 1/10W | R106, R107, R109, R118, R119, R122, R128, R130, R500, R501, R502, R503, R504, R505, R506, R507, R510, R511, R512, R609 | CMP-001-0053-3 | Any
Resistor, 0603, 200k, 1%, 1/10W | 3 | Resistor, 0603, 200k, 1%, 1/10W | R403, R406, R407 | CMP-001-0132-2 | Any
Resistor, 0805, 120R, 1%, 1/10W | 1 | Resistor, 0805, 120R, 1%, 1/10W | R303 | CMP-001-1673-1 | Any
Any | 1 | Resistor, 1206, 1M, 1%, 1/4W | R225 | CMP-0001-00051-1 | Any
IN-PI22TAT5R5G5B | 10 | RGB LED, Discrete, Serial PWM(1Wire) | D600, D601, D602, D603, D604, D605, D606, D607, D608, D609 | CMP-001-1686-5 | Inolux
SMAJ33A | 1 | SMAJ Series 53.3 V 0.4 kW Surface Mount Uni-Directional TVS Diode - DO-214AC | D401 | CMP-ROOT-01076-1 | Littelfuse
LAN8742AI-CZ-TR | 1 | Small Footprint RMII 10/100 Ethernet Transceiver with flexPWR Technology | U200 | CMP-ROOT-00367-2 | Microchip Technology
RCWE080550L0FNEA | 8 | SMD Chip Resistor, 50 MOhm, ± 1%, 250 mW, 0805 [2012 Metric], Thick Film, Anti-Sulfur | R148, R149, R150, R151, R152, R153, R154, R155 | CMP-0001-00285-1 | Any
SNT-100-BK-T-H | 1 | SNT - Samtec 2.54mm Jumper Link / Shunt | ME300 | CMP-ROOT-01069-1 | Samtec
DGPS2.5R-5.0-02P | 8 | Spring loaded terminal block | P100, P101, P102, P103, P104, P105, P106, P107 | CMP-ROOT-01059-1 | Degson
24884 | 7 | Standoffs & Spacers SM Standoff Steel 650 pcs per reel | MH400, MH401, MH402, MH403, MH404, MH405, MH406 | CMP-ROOT-01125-5 | Keystone Electronics
219-8MST | 1 | Switch DIP ON OFF SPST 8 Raised Slide 0.1A 20VDC Gull Wing 2000Cycles 2.54mm SMD Tube | SW500 | CMP-ROOT-01070-1 | CTS Electronic Components
1-1825027-1 | 8 | Switch Push Button OFF (ON) SPST Round Button 0.05A 24VDC Momentary Contact PC Pins Thru-Hole | S600, S601, S602, S603, S604, S605, S606, S607 | CMP-ROOT-01057-1 | TE
430181038816 | 1 | Switch Tactile Spst-no 0.05A 12V | SW501 | CMP-ROOT-00883-1 | Würth Elektronik
AP61102Z6-7 | 1 | Switching Voltage Regulators DCDC Conv LV Buck SOT563 T&R 3K | U408 | CMP-ROOT-00784-1 | Diodes Incorporated
HX1260NL | 1 | Telecom Transformer 1: 1 0.65Ohm Prim. DCR 0.65Ohm Sec. DCR 16 Terminal Gull Wing SMD | T200 | CMP-ROOT-01078-2 | Pulse
ESD9X3.3ST5G | 3 | TVS DIODE 3.3V SOD923 | D500, D501, D502 | CMP-001-1298-2 | ON Semiconductor
77 | 407
Unique component count | Total component count
Approved |  | Notes
