oleksandrkorkh/Fuse_board/Electronics/5V SMPS/3D models/PM4340.682NLT.stp

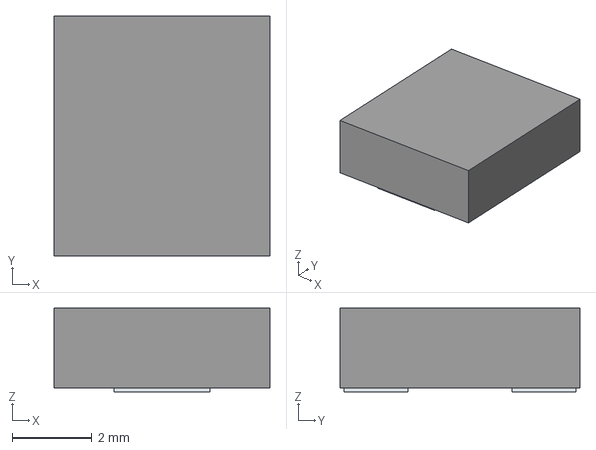
[picture p85: CAD file, 2025-12-12]
Electronics/5V SMPS/3D models/PM4340.682NLT.stp
5.40 x 6.00 x 2.10 mm
Pins
