oleksandrkorkh/Fuse_board/Electronics/Buttons and LED-s/3D models/BIVAR__INC_VLPR-24-1028-2.step

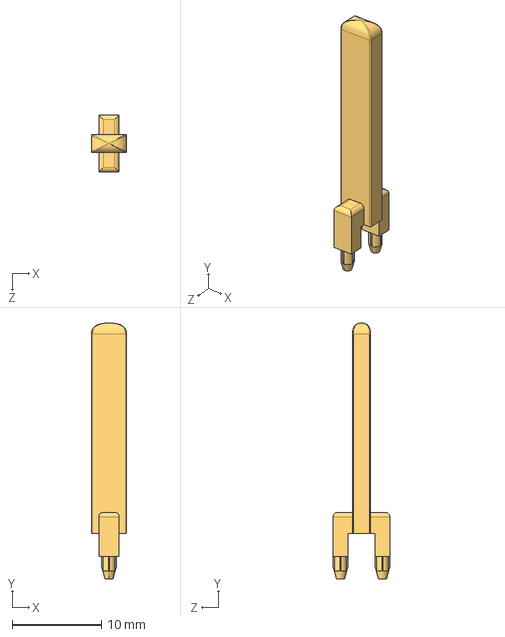
[picture p86: CAD file, 2025-12-12]
Electronics/Buttons and LED-s/3D models/BIVAR__INC_VLPR-24-1028-2.step
3.96 x 28.7 x 6.35 mm
