oleksandrkorkh/Fuse_board/Electronics/Current measurement/SOIC-8_MNP.step

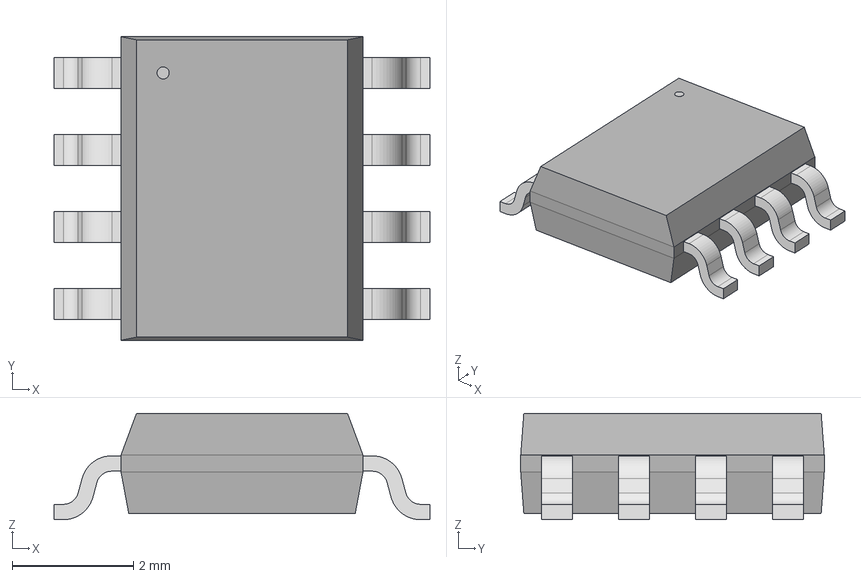
[picture p87: CAD file, 2025-12-12]
Electronics/Current measurement/SOIC-8_MNP.step
6.20 x 5.00 x 1.75 mm
