oleksandrkorkh/Fuse_board/Electronics/MCU/3D/219-8MST.stp

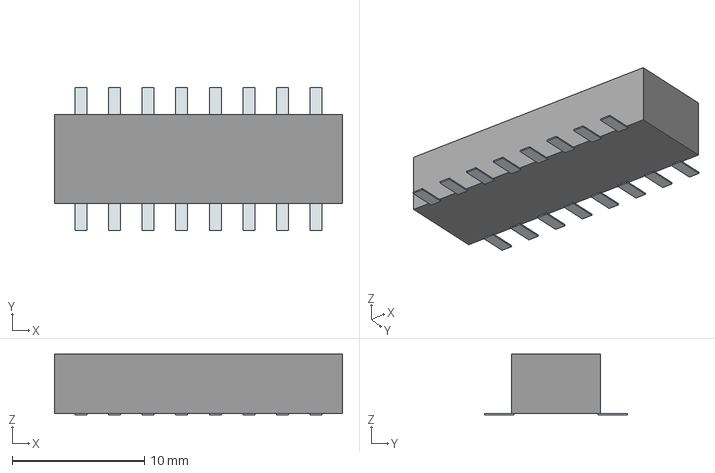
[picture p88: CAD file, 2025-12-12]
Electronics/MCU/3D/219-8MST.stp
21.8 x 10.8 x 4.60 mm
Pins
