oleksandrkorkh/Fuse_board/Electronics/Mechanics/Busbars from Mech/KR-DF-01 GND v2.STEP

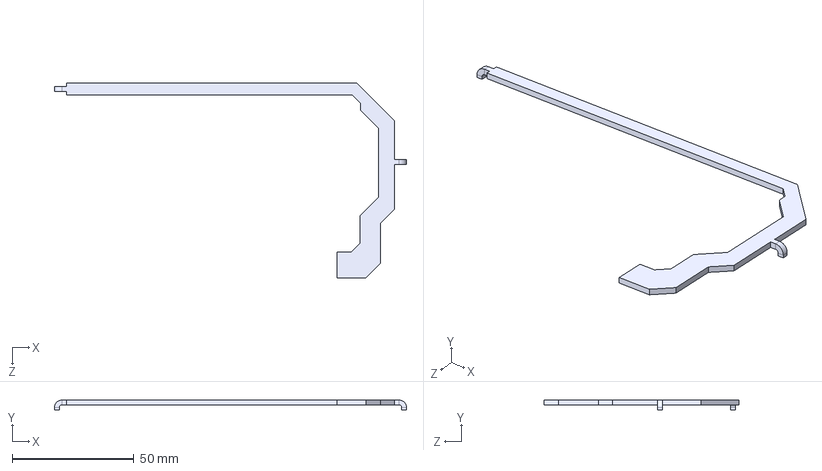
[picture p89: CAD file, 2025-12-12]
Electronics/Mechanics/Busbars from Mech/KR-DF-01 GND v2.STEP
144.4 x 4.00 x 79.8 mm
