oleksandrkorkh/Fuse_board/Electronics/Power Input/2616-3352.stp

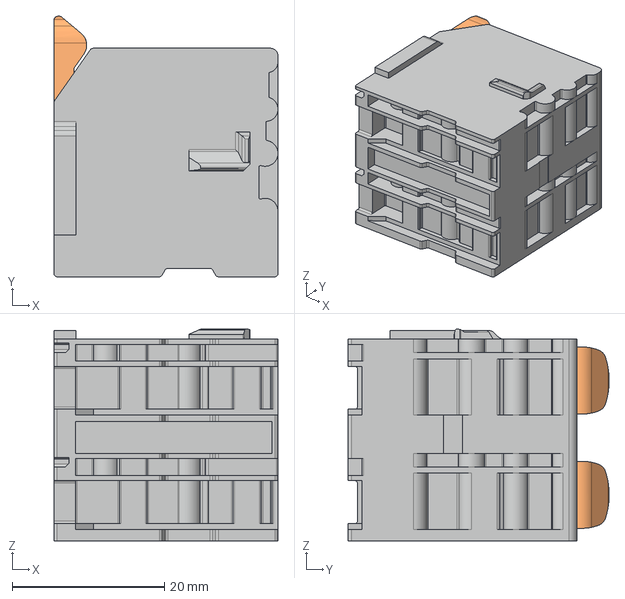
[picture p90: CAD file, 2025-12-12]
Electronics/Power Input/2616-3352.stp
29.4 x 34.2 x 27.8 mm
