oleksandrkorkh/Fuse_board/Electronics/Power Input/WAGO_26161352/2616-1352.stp

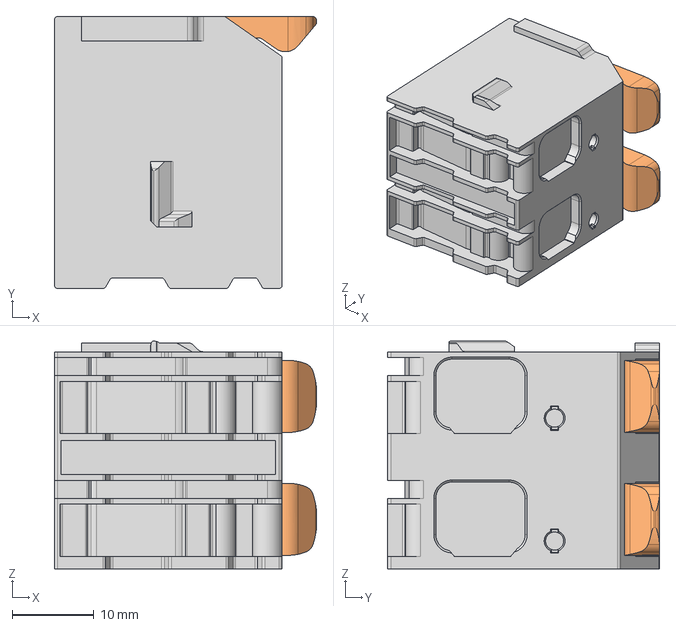
[picture p91: CAD file, 2025-12-12]
Electronics/Power Input/WAGO_26161352/2616-1352.stp
32.0 x 33.2 x 27.8 mm
