oleksandrkorkh/Fuse_board/Electronics/Power output/Component 3D/RES_TLRZ_2B_KOA.step

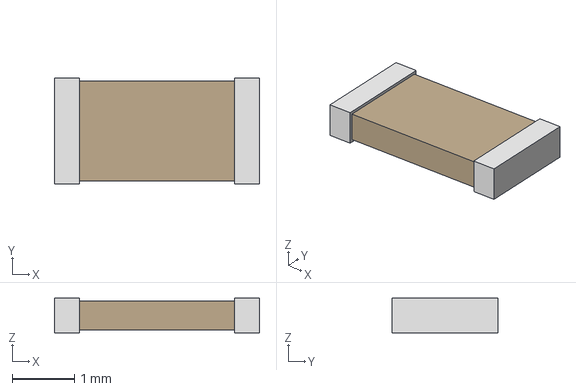
[picture p92: CAD file, 2025-12-12]
Electronics/Power output/Component 3D/RES_TLRZ_2B_KOA.step
3.30 x 1.70 x 0.559 mm
