oleksandrkorkh/Fuse_board/Electronics/RS485/3D Models/SNT-100-BK-T.stp

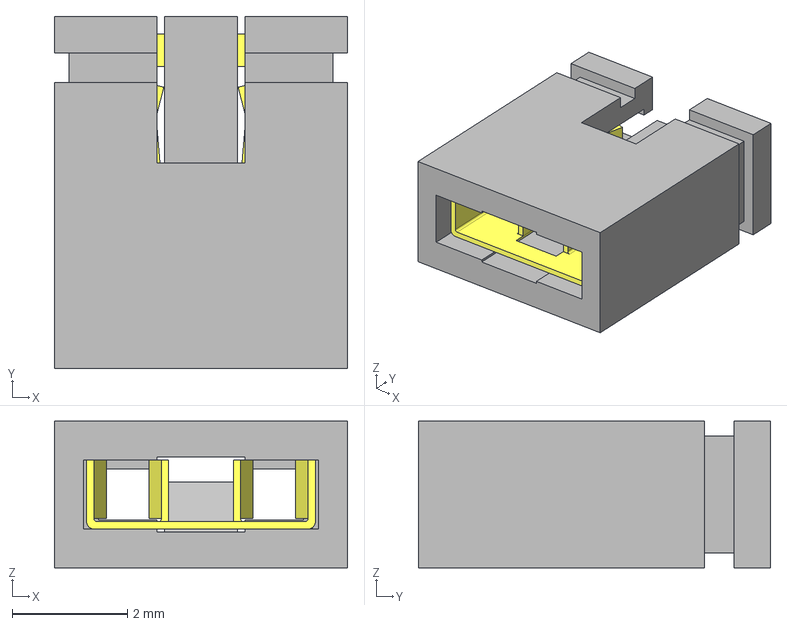
[picture p93: CAD file, 2025-12-12]
Electronics/RS485/3D Models/SNT-100-BK-T.stp
5.08 x 6.10 x 2.54 mm
SNT-100-BK_body
SNT-100_pins
