oleksandrkorkh/Fuse_board/Mechanics/Busbars/PWR busbar v4.FCStd

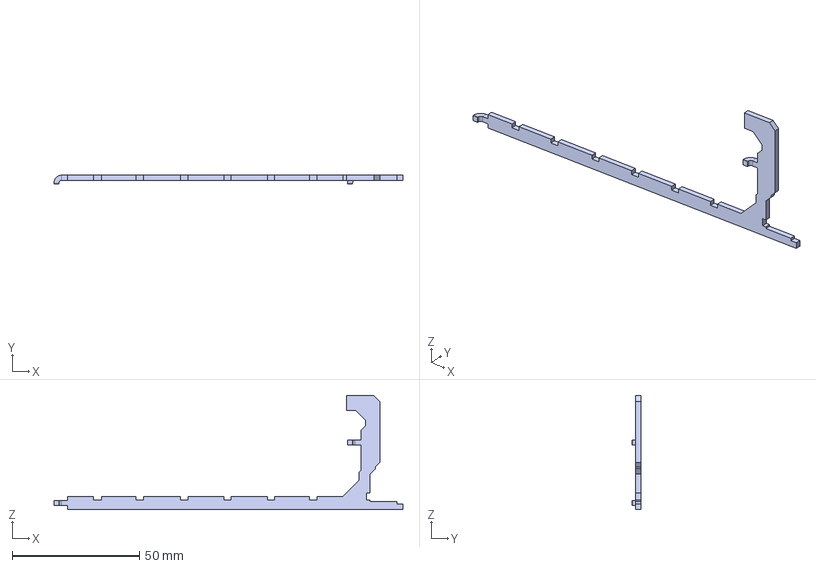
[picture p94: CAD file, 2025-12-12]
Mechanics/Busbars/PWR busbar v4.FCStd
137.0 x 3.40 x 44.8 mm
