oleksandrkorkh/Fuse_board/Mechanics/Mechanics/2025.03.05 Case and base plate design/04.04.24/KR-DF-01 GND Busbar v2.1.STEP

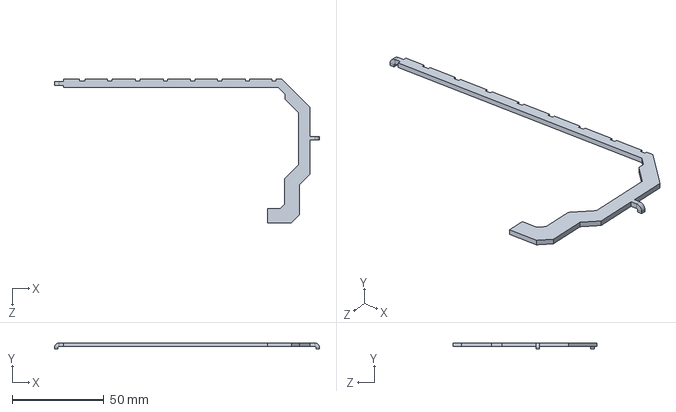
[picture p95: CAD file, 2025-12-12]
Mechanics/Mechanics/2025.03.05 Case and base plate design/04.04.24/KR-DF-01 GND Busbar v2.1.STEP
144.4 x 3.40 x 78.4 mm
