oleksandrkorkh/Fuse_board/Mechanics/Mechanics/2025.03.05 Case and base plate design/09.04.24/KR-Df-01 PWR Busbar v3.STEP

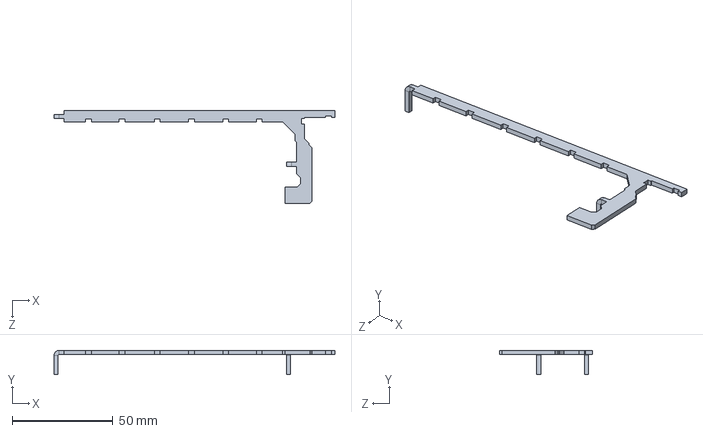
[picture p96: CAD file, 2025-12-12]
Mechanics/Mechanics/2025.03.05 Case and base plate design/09.04.24/KR-Df-01 PWR Busbar v3.STEP
139.4 x 12.0 x 45.9 mm
