oleksandrkorkh/Fuse_board/Mechanics/Mechanics/2025.03.05 Case and base plate design/Busbar 2025-01-29/KR-Df-01 PWR Busbar v4.STEP

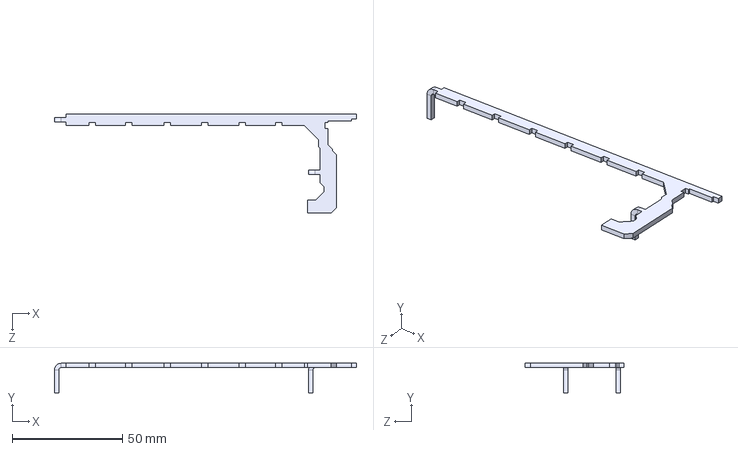
[picture p97: CAD file, 2025-12-12]
Mechanics/Mechanics/2025.03.05 Case and base plate design/Busbar 2025-01-29/KR-Df-01 PWR Busbar v4.STEP
137.0 x 13.4 x 44.8 mm
