oleksandrkorkh/Fuse_board/Mechanics/Mechanics/2025.03.05 Case and base plate design/Manufacturing/2025_03_05_Case and base plate/Part28 v2.STL

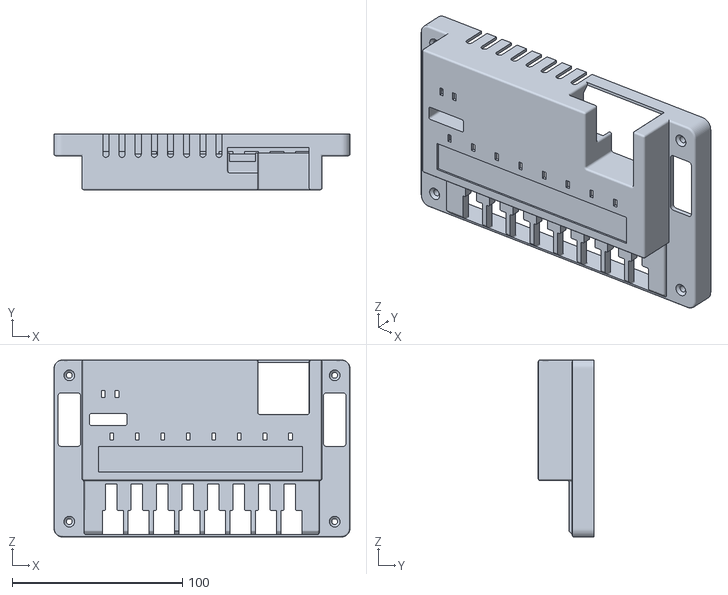
[picture p98: CAD file, 2025-12-12]
Mechanics/Mechanics/2025.03.05 Case and base plate design/Manufacturing/2025_03_05_Case and base plate/Part28 v2.STL
174.0 x 32.7 x 104.0
