oleksandrkorkh/Fuse_board/Electronics/Mechanics/KR-Df-01-EL-00 PCBA 2023_12_04.step

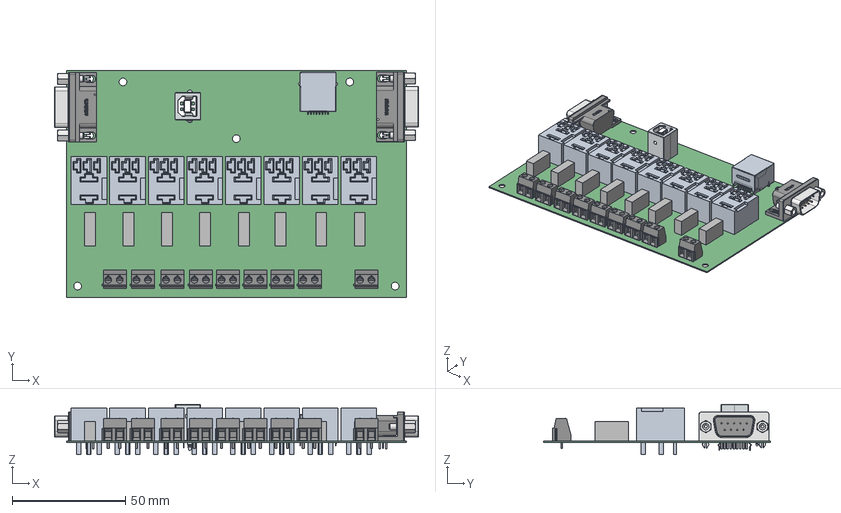
[picture p99: CAD file, 2025-12-12]
Electronics/Mechanics/KR-Df-01-EL-00 PCBA 2023_12_04.step
160.5 x 100.0 x 22.1 mm
tail x 2
contact x 2
bolt x 2
mtn x 2
bolt_MIR x 2
mtn_MIR x 2
logo x 2
M-RJLSE-4X381-01T-REVT1
c-1393310-2-b-3d x 8
61400413321_Pin_2 x 2
61400413321_Insulator
61400413321_Pin x 2
61400413321_Shielding
Extruded x 8
