oleksandrkorkh/Fuse_board/Electronics/Power output/Component 3D/c-1558660-7-b-3d.stp

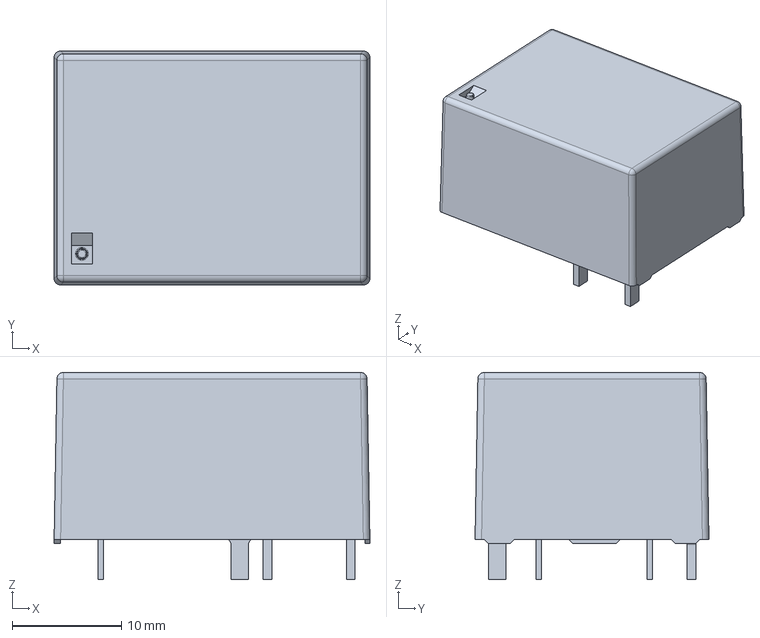
[picture p100: CAD file, 2025-12-12]
Electronics/Power output/Component 3D/c-1558660-7-b-3d.stp
28.9 x 21.4 x 18.9 mm
