oleksandrkorkh/Fuse_board/Electronics/RS485/3D Models/L717TSEH09POL2RM8--3DModel-STEP-533217.STEP

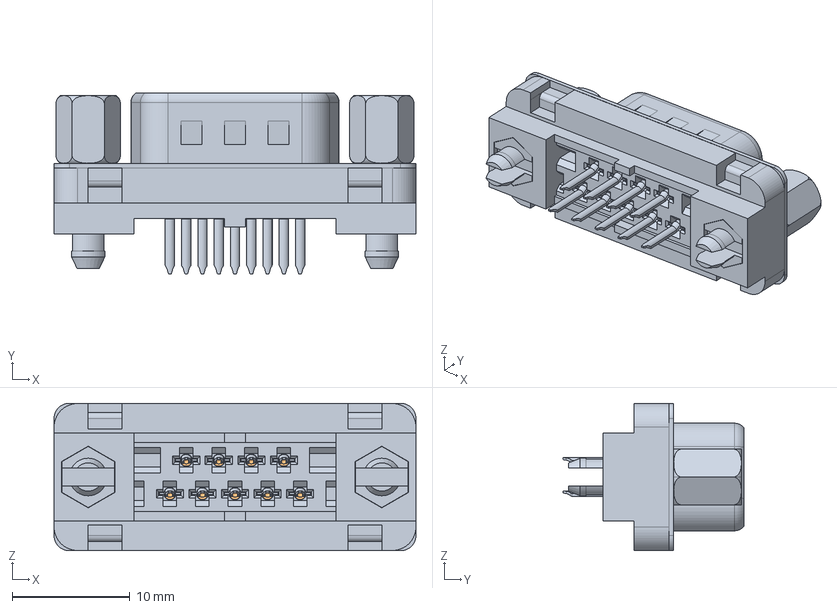
[picture p101: CAD file, 2025-12-12]
Electronics/RS485/3D Models/L717TSEH09POL2RM8--3DModel-STEP-533217.STEP
30.8 x 15.4 x 12.6 mm
