oleksandrkorkh/Fuse_board/Mechanics/Busbars/GND busbar v4.1.FCStd

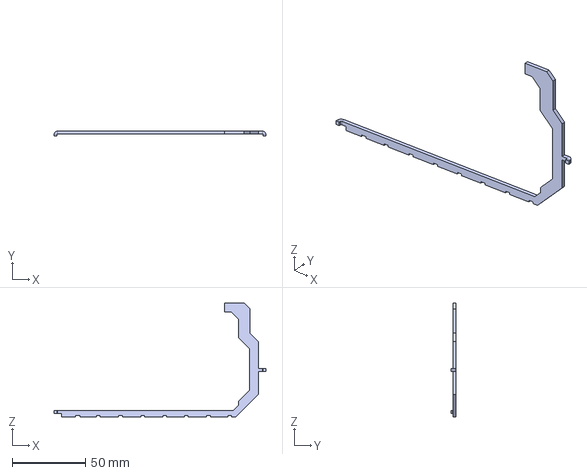
[picture p102: CAD file, 2025-12-12]
Mechanics/Busbars/GND busbar v4.1.FCStd
144.4 x 3.40 x 77.5 mm
