oleksandrkorkh/Fuse_board/Mechanics/Mechanics/2025.03.05 Case and base plate design/04.04.24/KR-Df-01 PWR Busbar v1.2.STEP

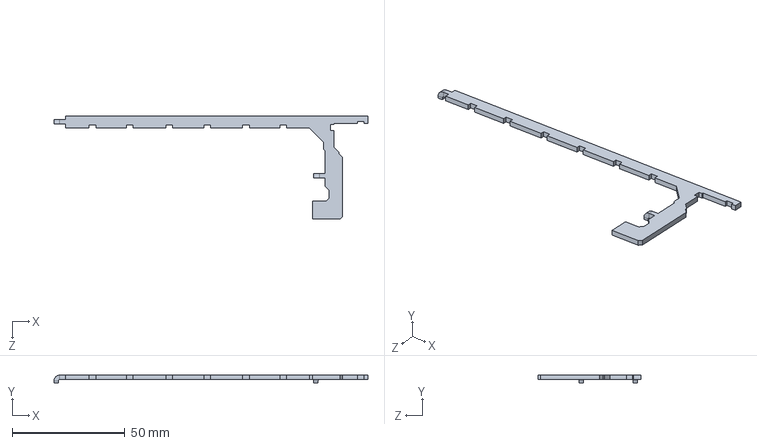
[picture p103: CAD file, 2025-12-12]
Mechanics/Mechanics/2025.03.05 Case and base plate design/04.04.24/KR-Df-01 PWR Busbar v1.2.STEP
139.4 x 3.40 x 45.9 mm
