oleksandrkorkh/Fuse_board/Mechanics/Mechanics/2025.03.05 Case and base plate design/09.04.24/Flat pattern - KR-Df-01 PWR Busbar v3.DXF

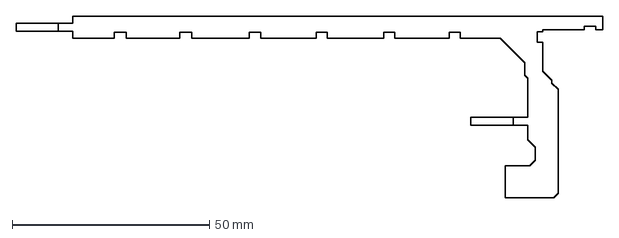
[picture p104: CAD file, 2025-12-12]
Mechanics/Mechanics/2025.03.05 Case and base plate design/09.04.24/Flat pattern - KR-Df-01 PWR Busbar v3.DXF
148.7 x 45.9 mm
