oleksandrkorkh/Fuse_board/Mechanics/Mechanics/2025.03.05 Case and base plate design/Busbar 2025-01-29/KR-DF-01 GND Busbar v4.1.STEP

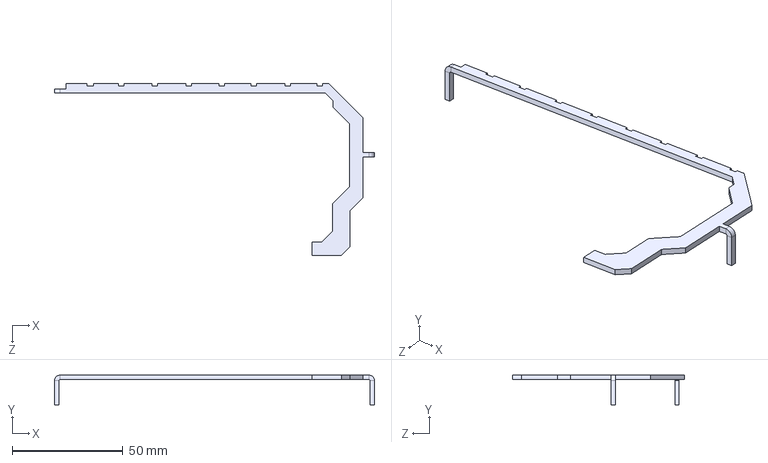
[picture p105: CAD file, 2025-12-12]
Mechanics/Mechanics/2025.03.05 Case and base plate design/Busbar 2025-01-29/KR-DF-01 GND Busbar v4.1.STEP
144.4 x 13.4 x 77.5 mm
