oleksandrkorkh/Fuse_board/Mechanics/Mechanics/2025.03.05 Case and base plate design/Manufacturing/2025_03_05_Case and base plate/Part29 v2.STEP

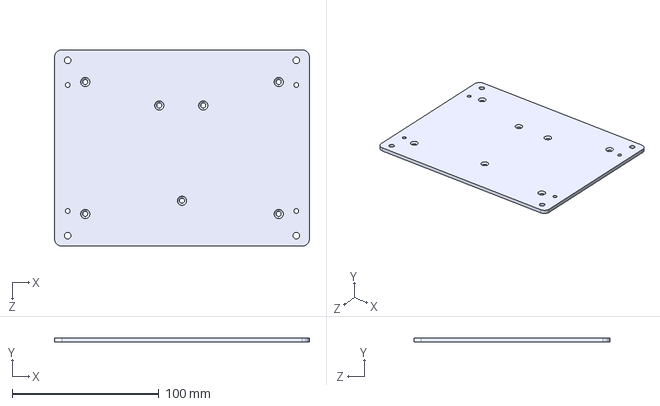
[picture p106: CAD file, 2025-12-12]
Mechanics/Mechanics/2025.03.05 Case and base plate design/Manufacturing/2025_03_05_Case and base plate/Part29 v2.STEP
174.0 x 3.00 x 134.0 mm
