oleksandrkorkh/Fuse_board/Electronics/Mechanics/KR-Df-01-PWR BUSBAR 2024_01_20.step

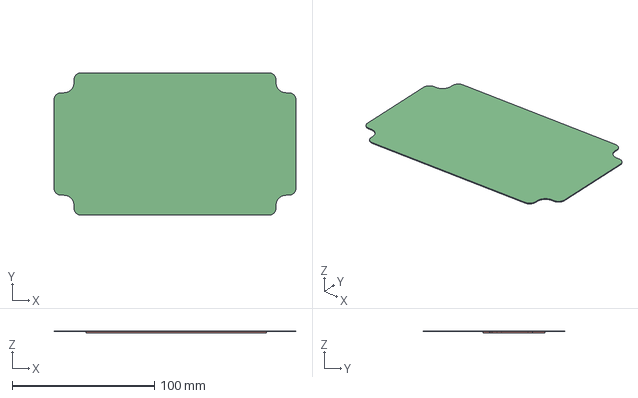
[picture p107: CAD file, 2025-12-12]
Electronics/Mechanics/KR-Df-01-PWR BUSBAR 2024_01_20.step
170.0 x 100.0 x 1.62 mm
Extruded
