oleksandrkorkh/Fuse_board/Electronics/Power output/Component 3D/1-1825027-1.step

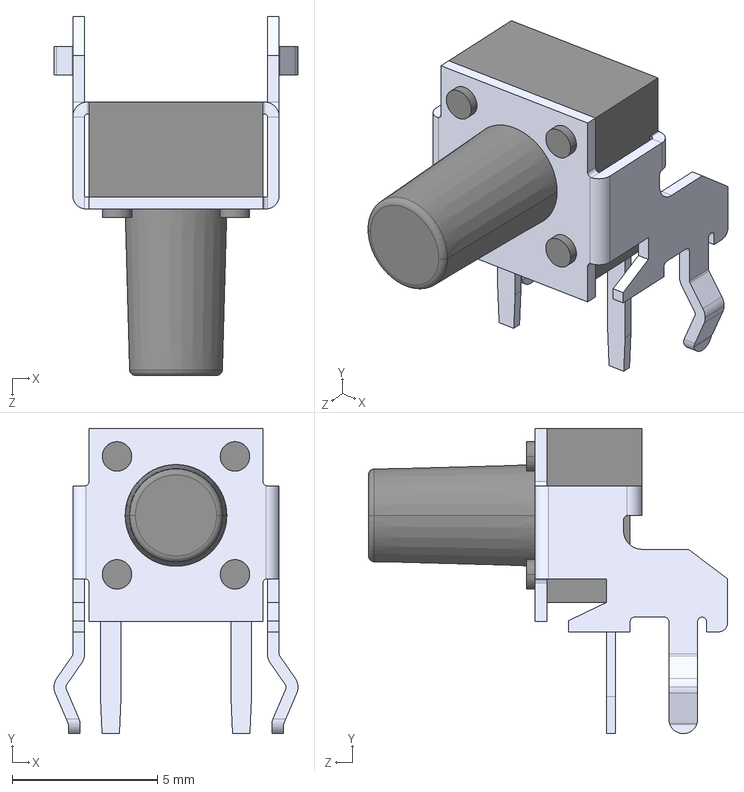
[picture p108: CAD file, 2025-12-12]
Electronics/Power output/Component 3D/1-1825027-1.step
8.41 x 10.5 x 12.4 mm
