oleksandrkorkh/Fuse_board/Mechanics/Mechanics/2025.03.05 Case and base plate design/04.04.24/Flat pattern - KR-DF-01 GND Busbar v2.1.DXF

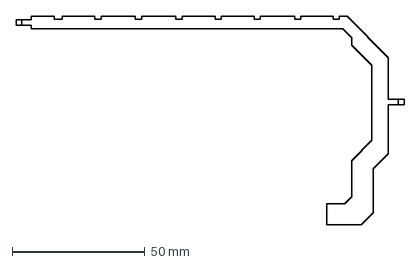
[picture p109: CAD file, 2025-12-12]
Mechanics/Mechanics/2025.03.05 Case and base plate design/04.04.24/Flat pattern - KR-DF-01 GND Busbar v2.1.DXF
145.9 x 78.4 mm
