oleksandrkorkh/Fuse_board/Mechanics/Mechanics/2025.03.05 Case and base plate design/09.04.24/KR-DF-01 GND Busbar v3.STEP

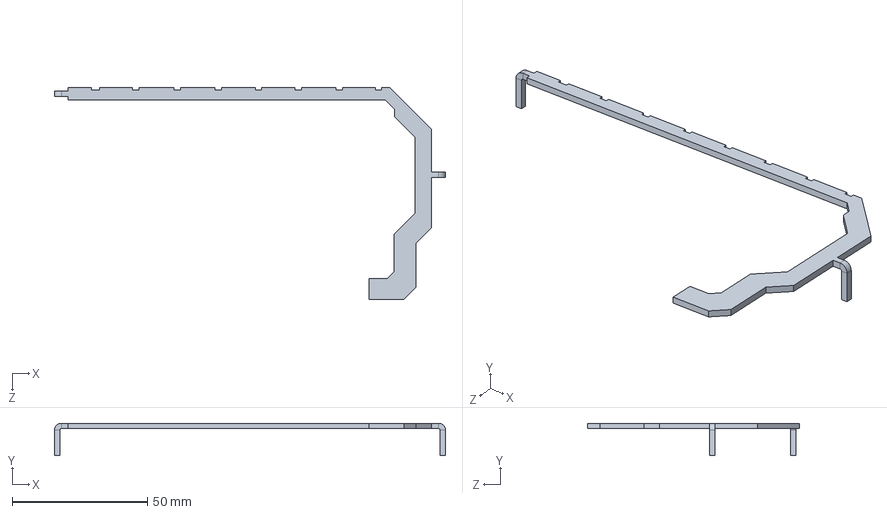
[picture p110: CAD file, 2025-12-12]
Mechanics/Mechanics/2025.03.05 Case and base plate design/09.04.24/KR-DF-01 GND Busbar v3.STEP
144.4 x 12.0 x 78.4 mm
