oleksandrkorkh/Fuse_board/Electronics/Power output/Component 3D/c-1393310-2-b-3d.stp

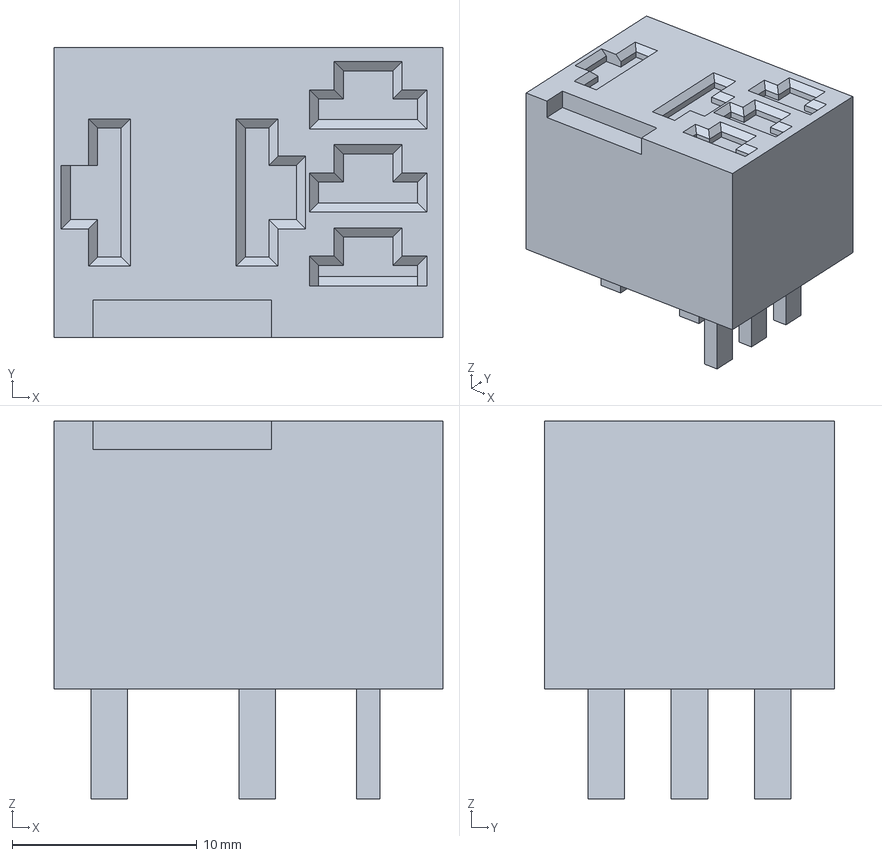
[picture p111: CAD file, 2025-12-12]
Electronics/Power output/Component 3D/c-1393310-2-b-3d.stp
21.1 x 15.7 x 20.4 mm
