oleksandrkorkh/Fuse_board/Mechanics/Mechanics/2025.03.05 Case and base plate design/04.04.24/Flat pattern - KR-Df-01 PWR Busbar v1.2.DXF

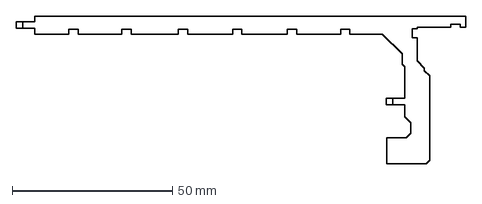
[picture p112: CAD file, 2025-12-12]
Mechanics/Mechanics/2025.03.05 Case and base plate design/04.04.24/Flat pattern - KR-Df-01 PWR Busbar v1.2.DXF
140.1 x 45.9 mm
