oleksandrkorkh/Fuse_board/Mechanics/Mechanics/2025.03.05 Case and base plate design/09.04.24/Flat pattern - KR-DF-01 GND Busbar v3.DXF

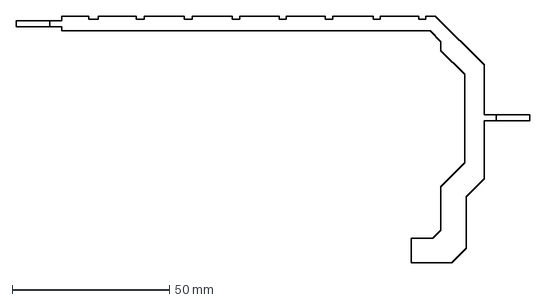
[picture p113: CAD file, 2025-12-12]
Mechanics/Mechanics/2025.03.05 Case and base plate design/09.04.24/Flat pattern - KR-DF-01 GND Busbar v3.DXF
163.1 x 78.4 mm
