oleksandrkorkh/Fuse_board/Mechanics/Mechanics/2025.03.05 Case and base plate design/KR-DF-01 GND Busbar v4.STEP

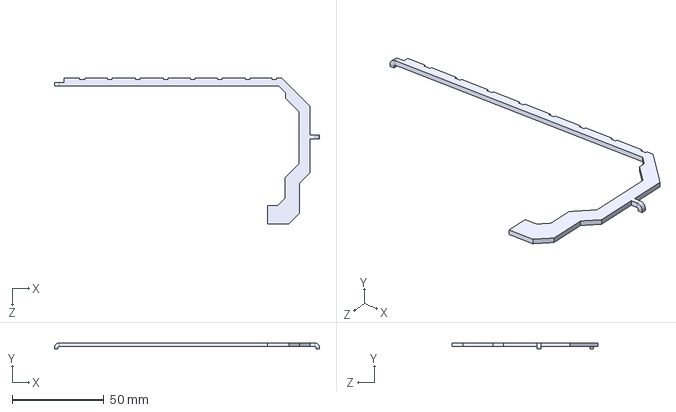
[picture p114: CAD file, 2025-12-12]
Mechanics/Mechanics/2025.03.05 Case and base plate design/KR-DF-01 GND Busbar v4.STEP
144.4 x 3.40 x 79.3 mm
