oleksandrkorkh/Fuse_board/Electronics/Power output/Component 3D/DGPS2.5R-5.0-02P-14-00Z(H).stp

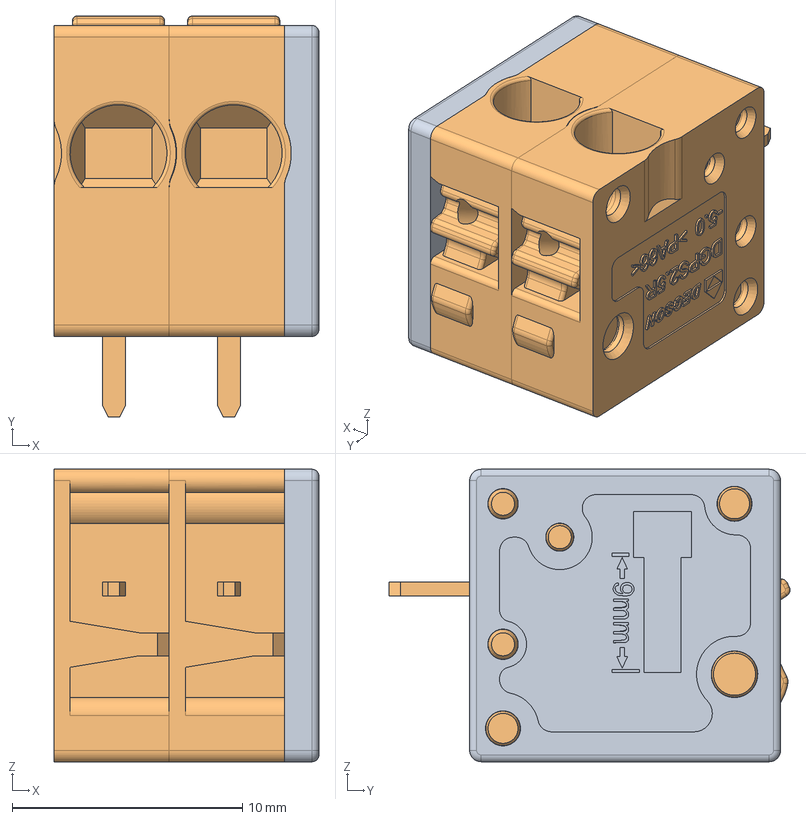
[picture p115: CAD file, 2025-12-12]
Electronics/Power output/Component 3D/DGPS2.5R-5.0-02P-14-00Z(H).stp
11.5 x 17.4 x 12.7 mm
