oleksandrkorkh/Fuse_board/Electronics/Mechanics/Busbars from Mech/KR-DF-01 PWR v1.1.STEP

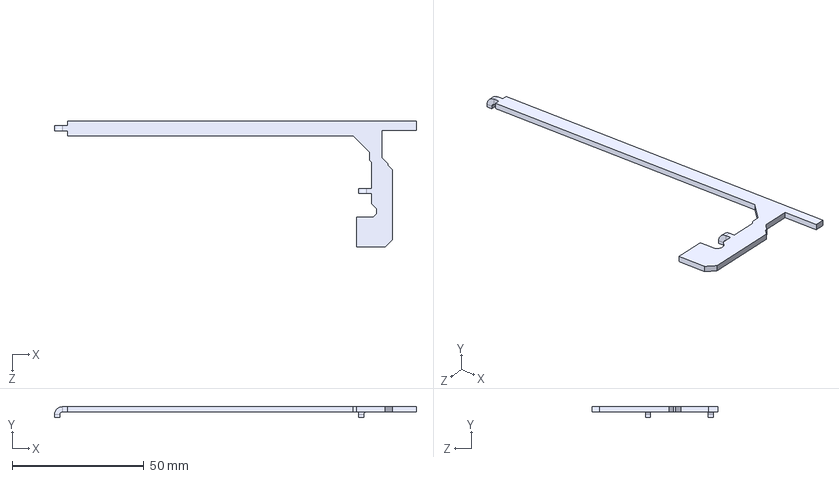
[picture p116: CAD file, 2025-12-12]
Electronics/Mechanics/Busbars from Mech/KR-DF-01 PWR v1.1.STEP
137.3 x 4.00 x 47.9 mm
