oleksandrkorkh/Fuse_board/Mechanics/Mechanics/2025.03.05 Case and base plate design/Part29 v1.STEP

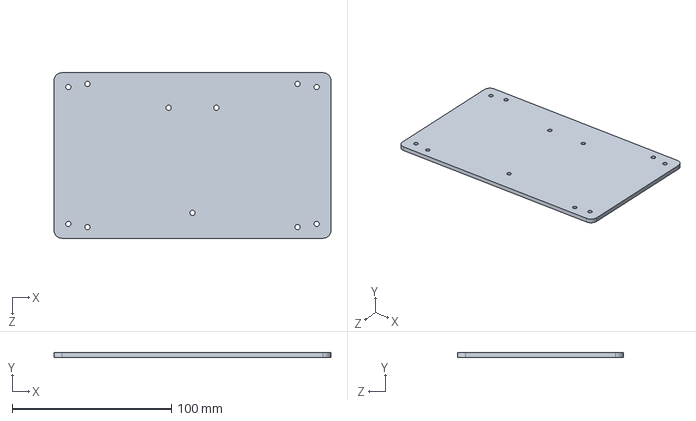
[picture p117: CAD file, 2025-12-12]
Mechanics/Mechanics/2025.03.05 Case and base plate design/Part29 v1.STEP
174.0 x 3.00 x 104.0 mm
