oleksandrkorkh/Fuse_board/Mechanics/Mechanics/2025.03.05 Case and base plate design/Part19.SLDPRT

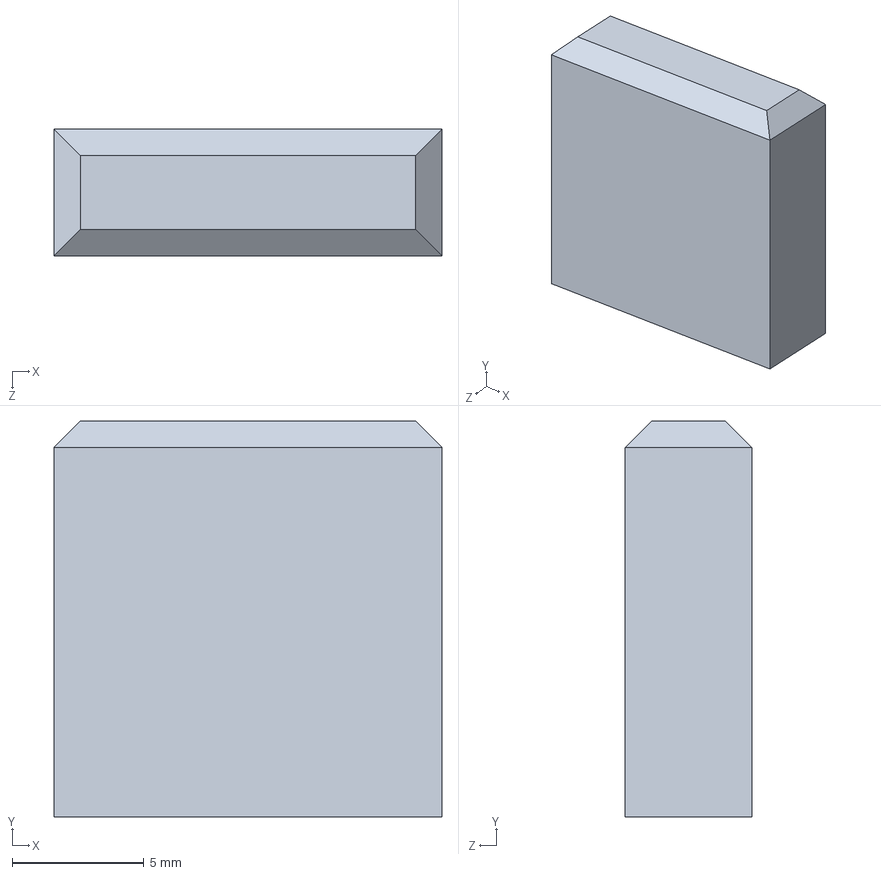
[picture p118: CAD file, 2025-12-12]
Mechanics/Mechanics/2025.03.05 Case and base plate design/Part19.SLDPRT
14.7 x 15.0 x 4.80 mm
