oleksandrkorkh/Fuse_board/Mechanics/Mechanics/2025.03.05 Case and base plate design/Part29 v2.DXF

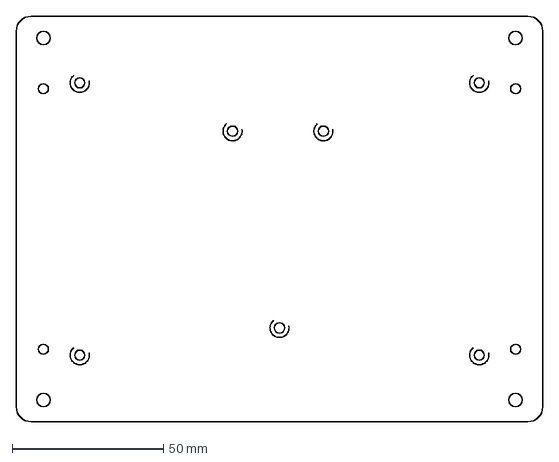
[picture p119: CAD file, 2025-12-12]
Mechanics/Mechanics/2025.03.05 Case and base plate design/Part29 v2.DXF
174.0 x 134.0 mm
