oleksandrkorkh/Fuse_board/(list of files, cad)

Other CAD files:
Mechanics/Mechanics/2025.03.05 Case and base plate design/Part28.SLDPRT
Electronics/Mechanics/Busbars from Mech/KR-Df-01 PWR Busbar v4.STEP
Electronics/Mechanics/Busbars from Mech/KR-DF-01 GND Busbar v4.1.STEP
Mechanics/Mechanics/2025.03.05 Case and base plate design/Part107.SLDPRT
Mechanics/Mechanics/2025.03.05 Case and base plate design/Part29.SLDPRT
Mechanics/Mechanics/2025.03.05 Case and base plate design/KR-Df-01 PWR Busbar v4.SLDPRT
Mechanics/Mechanics/2025.03.05 Case and base plate design/KR-DF-01 GND Busbar v4.1.SLDPRT
Mechanics/Mechanics/2025.03.05 Case and base plate design/v1.STEP
Mechanics/Mechanics/2025.03.05 Case and base plate design/Part111.SLDPRT
Mechanics/Mechanics/2025.03.05 Case and base plate design/Part108.SLDPRT
Electronics/MCU/LIB_STM32H573VIT6/STM32H573VIT6/Allegro/qfp50p1600x1600x160-100n.psm
Electronics/MCU/LIB_STM32H573VIT6/STM32H573VIT6/DEHDL/stm32h573vit6/chips/chips.prt
Electronics/Mechanics/22035000_TSH-35.stp
Electronics/Mechanics/Busbars from Mech/KR-DF-01 GND Busbar v2.1.STEP
Electronics/Mechanics/Busbars from Mech/KR-Df-01 PWR Busbar v1.2.STEP
Mechanics/Mechanics/2025.03.05 Case and base plate design/Busbar 2025-01-29/#KR-Df-01 PWR Busbar v4.DXF
Mechanics/Mechanics/2025.03.05 Case and base plate design/Busbar 2025-01-29/GND and PWR busbar v4.1.SLDDRW
Mechanics/Mechanics/2025.03.05 Case and base plate design/Busbar 2025-01-29/KR-DF-01 GND Busbar v4.1.DXF
Mechanics/Mechanics/2025.03.05 Case and base plate design/Busbar 2025-01-29/KR-Df-01 PWR Busbar v4.DXF
Mechanics/Mechanics/2025.03.05 Case and base plate design/KR-DF-01 GND Busbar v2.1.SLDPRT
Mechanics/Mechanics/2025.03.05 Case and base plate design/KR-DF-01 GND Busbar v3.SLDPRT
Mechanics/Mechanics/2025.03.05 Case and base plate design/KR-DF-01 GND Busbar v4.SLDPRT
Mechanics/Mechanics/2025.03.05 Case and base plate design/KR-Df-01 PWR Busbar v1.2.SLDPRT
Mechanics/Mechanics/2025.03.05 Case and base plate design/KR-Df-01 PWR Busbar v3.SLDPRT
Mechanics/Mechanics/2025.03.05 Case and base plate design/Part28.STL
Mechanics/Mechanics/2025.03.05 Case and base plate design/Part29 v2.SLDDRW
Mechanics/Mechanics/2025.03.05 Case and base plate design/Part29.SLDDRW
