oleksandrkorkh/Fuse_board/Mechanics/Mechanics/2025.03.05 Case and base plate design/renders/FuseBoard_Main_assembly_v1_v1_2025-May-15_08-15-29AM-000_CustomizedView6061727578.png

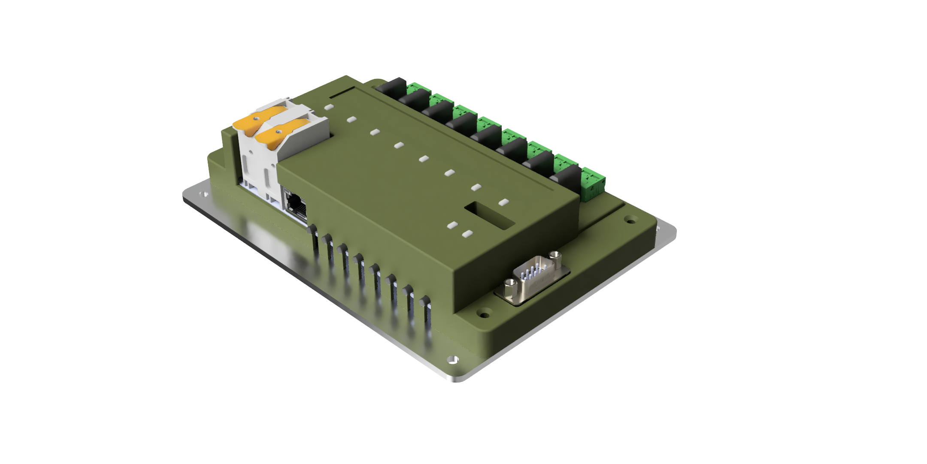
Mechanics/Mechanics/2025.03.05 Case and base plate design/renders/FuseBoard_Main_assembly_v1_v1_2025-May-15_08-15-29AM-000_CustomizedView6061727578.png
