oleksandrkorkh/Fuse_board/Mechanics/Mechanics/2025.03.05 Case and base plate design/renders/FuseBoard_Main_assembly_v1_v1_2025-May-15_08-27-28AM-000_CustomizedView901477951.png

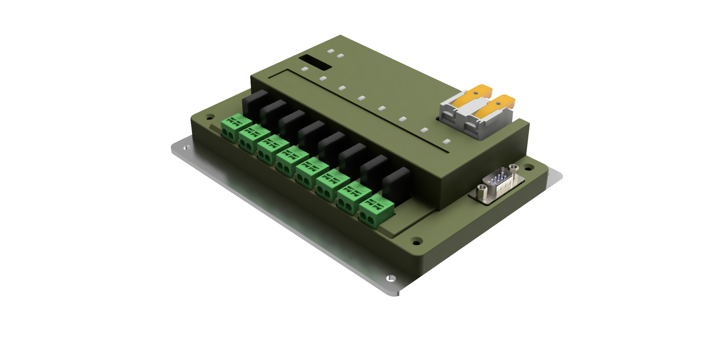
Mechanics/Mechanics/2025.03.05 Case and base plate design/renders/FuseBoard_Main_assembly_v1_v1_2025-May-15_08-27-28AM-000_CustomizedView901477951.png
