oleksandrkorkh/Fuse_board/Mechanics/Mechanics/2025.03.05 Case and base plate design/renders/jpeg/FuseBoard_Main_assembly_v1_v1_2025-May-15_07-55-36AM-000_CustomizedView29878767000.jpg

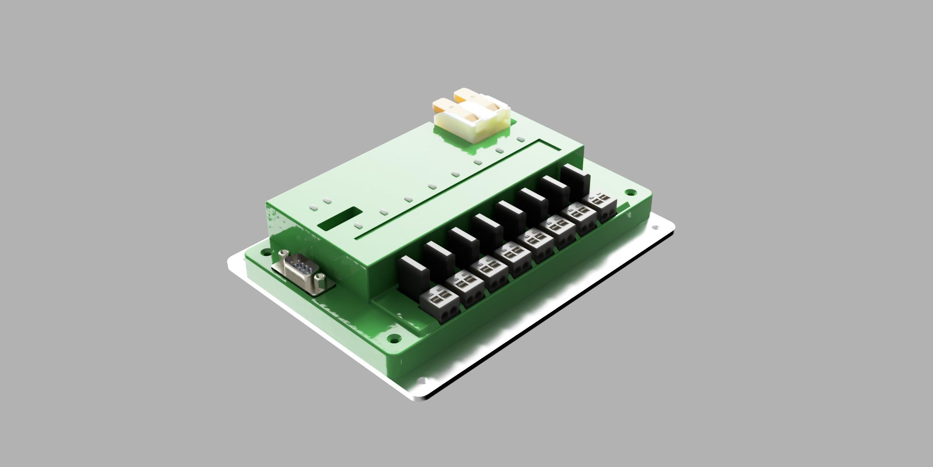
Mechanics/Mechanics/2025.03.05 Case and base plate design/renders/jpeg/FuseBoard_Main_assembly_v1_v1_2025-May-15_07-55-36AM-000_CustomizedView29878767000.jpg
