oleksandrkorkh/Fuse_board/Mechanics/Mechanics/2025.03.05 Case and base plate design/renders/jpeg/FuseBoard_Main_assembly_v1_v1_2025-May-15_08-05-20AM-000_CustomizedView8442070566.jpg

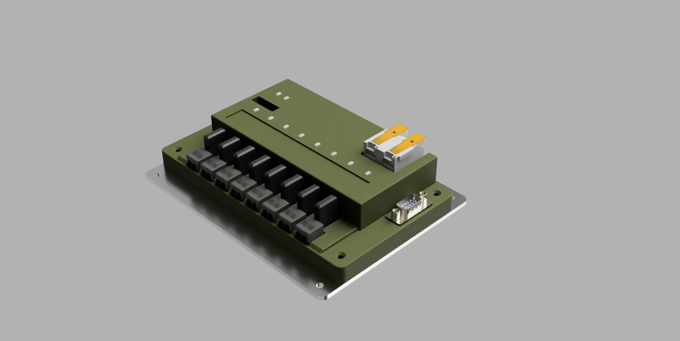
Mechanics/Mechanics/2025.03.05 Case and base plate design/renders/jpeg/FuseBoard_Main_assembly_v1_v1_2025-May-15_08-05-20AM-000_CustomizedView8442070566.jpg
