oleksandrkorkh/Fuse_board/Mechanics/Mechanics/2025.03.05 Case and base plate design/renders/jpeg/FuseBoard_Main_assembly_v1_v1_2025-May-15_08-07-27AM-000_CustomizedView17706238736.jpg

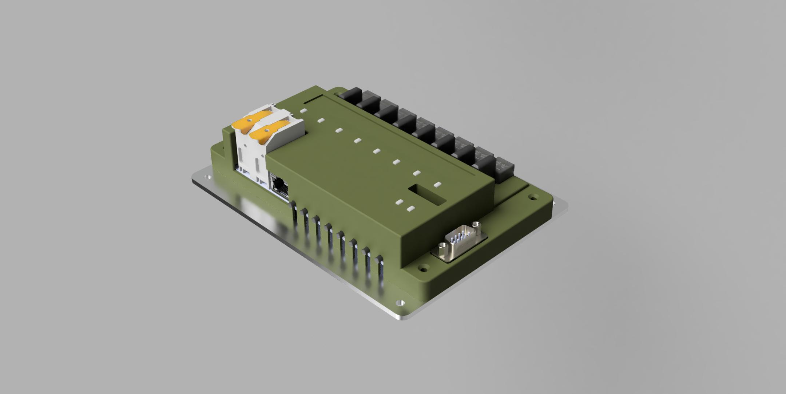
Mechanics/Mechanics/2025.03.05 Case and base plate design/renders/jpeg/FuseBoard_Main_assembly_v1_v1_2025-May-15_08-07-27AM-000_CustomizedView17706238736.jpg
