oleksandrkorkh/Fuse_board/Electronics/Voltage measurement/Voltage measurement design notes.xlsx

Vin | 32 | V
Vout | 2.5 | V
Vin Max | 40 | V
