oleksandrkorkh/Fuse_board/Test reports/V1 lifetime tests/logs/fb_lt_test_15_04_2025-15_40.csv

Timestamp | Port no | State | Reason | Flags | Voltage_mV | Current_mA | Power_mW | Button
1744720827.0318918 | 0 | 1 | 2 | 0 | 23834 | 0 | 0 | 74 | 0
1744720827.231827 | 1 | 1 | 2 | 0 | 23729 | 0 | 0 | 177 | 0
1744720827.631728 | 2 | 3 | 2 | 8 | 0 | 0 | 0 | 0 | 0
1744720828.0317001 | 3 | 1 | 2 | 4 | 23713 | 0 | 0 | 118 | 0
1744720828.2317696 | 4 | 1 | 2 | 0 | 23699 | 177 | 420 | 7850 | 0
1744720828.4317887 | 5 | 1 | 2 | 0 | 23837 | 234 | 558 | 5590 | 0
1744720828.8317144 | 6 | 1 | 2 | 1 | 23710 | 1467 | 3480 | 10871 | 0
1744720829.031758 | 7 | 1 | 2 | 0 | 23512 | 1448 | 3406 | 5680 | 0
1744720836.5317147 | 0 | 0 | 2 | 0 | 2 | 0 | 0 | 75 | 0
1744720836.731637 | 1 | 0 | 2 | 0 | 0 | 0 | 0 | 180 | 0
1744720837.1316025 | 2 | 0 | 2 | 8 | 0 | 0 | 0 | 0 | 0
1744720837.5316455 | 3 | 0 | 2 | 4 | 0 | 0 | 0 | 120 | 0
1744720837.7316363 | 4 | 0 | 2 | 0 | 0 | 0 | 0 | 7951 | 0
1744720837.9316156 | 5 | 0 | 2 | 0 | 0 | 1 | 0 | 5730 | 0
1744720838.3315802 | 6 | 0 | 2 | 1 | 0 | 0 | 0 | 11772 | 0
1744720838.5316403 | 7 | 0 | 2 | 0 | 0 | 5 | 0 | 6534 | 0
1744720846.2315743 | 0 | 1 | 2 | 0 | 23897 | 0 | 0 | 76 | 0
1744720846.4315403 | 1 | 1 | 2 | 0 | 23702 | 0 | 0 | 190 | 0
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
