oleksandrkorkh/Fuse_board/Test reports/V1 lifetime tests/logs/fb_lt_test_15_04_2025-15_42.csv

Timestamp | Port no | State | Reason | Flags | Voltage_mV | Current_mA | Power_mW | Button
1744720940.8824623 | 0 | 1 | 2 | 0 | 23861 | 0 | 0 | 82 | 0
1744720941.0823553 | 1 | 1 | 2 | 0 | 23682 | 0 | 0 | 209 | 0
1744720941.4823515 | 2 | 3 | 2 | 8 | 0 | 0 | 0 | 0 | 0
1744720941.8822818 | 3 | 1 | 2 | 4 | 23724 | 0 | 0 | 136 | 0
1744720942.082332 | 4 | 1 | 2 | 0 | 23611 | 177 | 419 | 8909 | 0
1744720942.2823122 | 5 | 1 | 2 | 0 | 23718 | 237 | 563 | 6998 | 0
1744720942.6822703 | 6 | 1 | 2 | 1 | 23430 | 1479 | 3465 | 19601 | 0
1744720942.8822908 | 7 | 1 | 2 | 0 | 23738 | 1436 | 3410 | 14313 | 0
1744720950.3822978 | 0 | 0 | 2 | 0 | 2 | 2 | 0 | 83 | 0
1744720950.5822067 | 1 | 0 | 2 | 0 | 2 | 1 | 0 | 213 | 0
1744720950.9820998 | 2 | 0 | 2 | 8 | 0 | 0 | 0 | 0 | 0
1744720951.382327 | 3 | 0 | 2 | 4 | 5 | 0 | 0 | 138 | 0
1744720951.5822124 | 4 | 0 | 2 | 0 | 0 | 0 | 0 | 9010 | 0
1744720951.7821312 | 5 | 0 | 2 | 0 | 0 | 0 | 0 | 7137 | 0
1744720952.1821015 | 6 | 0 | 2 | 1 | 0 | 1 | 0 | 20501 | 0
1744720952.3822107 | 7 | 0 | 2 | 0 | 0 | 4 | 0 | 15167 | 0
1744720957.0821197 | 0 | 1 | 2 | 0 | 23787 | 0 | 0 | 85 | 0
1744720957.2821422 | 1 | 1 | 2 | 0 | 23828 | 0 | 0 | 218 | 0
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
