oleksandrkorkh/Fuse_board/Test reports/V1 lifetime tests/logs/fb_lt_test_15_04_2025-16_22.csv

Timestamp | Port no | State | Reason | Flags | Voltage_mV | Current_mA | Power_mW | Button
1744723379.2159615 | 0 | 1 | 2 | 0 | 23991 | 0 | 0 | 118 | 0
1744723379.4159234 | 1 | 1 | 2 | 0 | 23801 | 0 | 0 | 329 | 0
1744723379.815828 | 2 | 3 | 2 | 8 | 8 | 0 | 0 | 0 | 0
1744723380.215831 | 3 | 1 | 2 | 4 | 23749 | 96 | 229 | 428 | 0
1744723380.415976 | 4 | 1 | 2 | 0 | 23705 | 176 | 418 | 11243 | 0
1744723380.6158772 | 5 | 1 | 2 | 0 | 23812 | 232 | 553 | 10098 | 0
1744723381.0157967 | 6 | 1 | 2 | 1 | 23622 | 1465 | 3461 | 38834 | 0
1744723381.2159152 | 7 | 1 | 2 | 0 | 23573 | 1455 | 3431 | 30753 | 0
1744723388.715863 | 0 | 0 | 2 | 0 | 0 | 2 | 0 | 120 | 0
1744723388.915762 | 1 | 0 | 2 | 0 | 5 | 0 | 0 | 332 | 0
1744723389.3157403 | 2 | 0 | 2 | 8 | 0 | 0 | 0 | 0 | 0
1744723389.715719 | 3 | 0 | 2 | 4 | 0 | 0 | 0 | 484 | 0
1744723389.9157395 | 4 | 0 | 2 | 0 | 0 | 0 | 0 | 11344 | 0
1744723390.1157198 | 5 | 0 | 2 | 0 | 2 | 0 | 0 | 10237 | 0
1744723390.515729 | 6 | 0 | 2 | 1 | 0 | 1 | 0 | 39730 | 0
1744723390.7157378 | 7 | 0 | 2 | 0 | 0 | 3 | 0 | 31610 | 0
1744723393.4158602 | 0 | 1 | 2 | 0 | 23908 | 0 | 0 | 120 | 0
1744723393.6157212 | 1 | 1 | 2 | 0 | 23889 | 0 | 0 | 335 | 0
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
