oleksandrkorkh/Fuse_board/Test reports/V1 lifetime tests/logs/fb_lt_test_15_04_2025-16_24.csv

Timestamp | Port no | State | Reason | Flags | Voltage_mV | Current_mA | Power_mW | Button
1744723491.587667 | 0 | 1 | 2 | 0 | 23787 | 0 | 0 | 124 | 0
1744723491.787616 | 1 | 1 | 2 | 0 | 23790 | 0 | 0 | 346 | 0
1744723492.1875243 | 2 | 3 | 2 | 8 | 0 | 0 | 0 | 0 | 0
1744723492.5875666 | 3 | 1 | 2 | 4 | 23864 | 94 | 225 | 726 | 0
1744723492.7876003 | 4 | 1 | 2 | 0 | 23616 | 179 | 424 | 11797 | 0
1744723492.987547 | 5 | 1 | 2 | 0 | 23680 | 234 | 554 | 10831 | 0
1744723493.3875394 | 6 | 1 | 2 | 1 | 23567 | 1460 | 3442 | 43370 | 0
1744723493.5875475 | 7 | 1 | 2 | 0 | 23575 | 1455 | 3430 | 35305 | 0
1744723501.0875611 | 0 | 0 | 2 | 0 | 0 | 1 | 0 | 124 | 0
1744723501.2874691 | 1 | 0 | 2 | 0 | 2 | 0 | 0 | 350 | 0
1744723501.687448 | 2 | 0 | 2 | 8 | 0 | 0 | 0 | 0 | 0
1744723502.0874002 | 3 | 0 | 2 | 4 | 0 | 0 | 0 | 782 | 0
1744723502.2874703 | 4 | 0 | 2 | 0 | 0 | 0 | 0 | 11898 | 0
1744723502.4875011 | 5 | 0 | 2 | 0 | 0 | 0 | 0 | 10970 | 0
1744723502.8873787 | 6 | 0 | 2 | 1 | 0 | 1 | 0 | 44262 | 0
1744723503.0874217 | 7 | 0 | 2 | 0 | 0 | 4 | 0 | 36166 | 0
1744723505.7874734 | 0 | 1 | 2 | 0 | 24037 | 0 | 0 | 125 | 0
1744723505.9873855 | 1 | 1 | 2 | 0 | 23724 | 0 | 0 | 352 | 0
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
