oleksandrkorkh/Fuse_board/Test reports/V1 lifetime tests/logs/fb_lt_test_15_04_2025-16_29.csv

Timestamp | Port no | State | Reason | Flags | Voltage_mV | Current_mA | Power_mW | Button
1744723811.7009006 | 0 | 1 | 2 | 0 | 23985 | 0 | 0 | 158 | 0
1744723811.900822 | 1 | 1 | 2 | 0 | 23702 | 0 | 0 | 463 | 0
1744723812.300795 | 2 | 3 | 2 | 8 | 0 | 0 | 0 | 0 | 0
1744723812.7007506 | 3 | 1 | 2 | 4 | 23809 | 95 | 228 | 2719 | 0
1744723812.9007952 | 4 | 1 | 2 | 0 | 23661 | 178 | 423 | 15482 | 0
1744723813.1007755 | 5 | 1 | 2 | 0 | 23694 | 235 | 559 | 15729 | 0
1744723813.500855 | 6 | 1 | 2 | 1 | 23496 | 1467 | 3448 | 73577 | 0
1744723813.7008138 | 7 | 1 | 2 | 0 | 23614 | 1452 | 3429 | 65604 | 0
1744723826.2007024 | 0 | 0 | 2 | 0 | 0 | 4 | 0 | 159 | 0
1744723826.4006734 | 1 | 0 | 2 | 0 | 0 | 0 | 0 | 466 | 0
1744723826.8005927 | 2 | 0 | 2 | 8 | 0 | 1 | 0 | 0 | 0
1744723827.200587 | 3 | 0 | 2 | 4 | 0 | 0 | 0 | 2776 | 0
1744723827.4006515 | 4 | 0 | 2 | 0 | 0 | 0 | 0 | 15584 | 0
1744723827.6006587 | 5 | 0 | 2 | 0 | 0 | 0 | 0 | 15869 | 0
1744723828.0005872 | 6 | 0 | 2 | 1 | 0 | 0 | 0 | 74472 | 0
1744723828.2006054 | 7 | 0 | 2 | 0 | 0 | 3 | 0 | 66464 | 0
1744723830.9006183 | 0 | 1 | 2 | 0 | 23952 | 0 | 0 | 160 | 0
1744723831.1005952 | 1 | 1 | 2 | 0 | 23795 | 0 | 0 | 468 | 0
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
