oleksandrkorkh/Fuse_board/Test reports/V0 Design verification/equipment list.xlsx

System power supply | For fault tolerance and maximum load tests | DefSecIntel
Lab power supply | For functional tests | Krakul
System load | Something highly inductive | DefSecIntel
DC Electronic load | Can be used for overload tests with additional parallel load | Krakul
Voltmeter |  | Krakul
CAN dongle |  | Krakul
RS486 dongle |  | Krakul
