oleksandrkorkh/Fuse_board/Test reports/V0 Design verification/Test time estimation for V0.xlsx

Nr | Test | Tasks | Time estimation
2 | Ethernet functional test | Loopback test at temperture and at supply voltage, Loopback cable building, device setup, Help from SW | 8
3 | RS485 Functional test | Set up 2 fuse boards. Connect them with RS 485. One in echo mode. Other pings and records Bit error rate. Build cable, Help from SW | 8
4 | Reverse polarity | Not implemented in v0 | 0
5 | 5V SMPS |  | 8
6 | 3,3V SMPS |  | 2
7.1 | Output function test | Record turn on and turn off waveforms | 2
7.2 | Output feedback system | Voltage measurement check at room temperature. Current measurement across temperature | 4
7.3 | Maximum load test | Load the system at maximum load | 4
7.4 | Overload test. | Algorithm not yet implemented | 0 | 4
7.5 | Output short circuit test | Algorithm not yet implemented | 0 | 4
7.6 | Maximum load and short to ground | Algorithm not yet implemented | 0 | 4
8 | Diagnostics functions | Algorithms not yet implemented, SW help needed. Create different Fault conditions and see how system responds. Can be ignored if fault codes will not be implemented. | 0
9 | Functional tests | Confirmed by SW developers | 0
 |  | Total | 36
 |  | Money | 3060
