oleksandrkorkh/Fuse_board/Test reports/V0 Design verification/V0 Measurements and notes.xlsx

Sheet: 5V SMPS
 |  | Input voltage
 |  | 24 |  | 28 |  | 32
Temperature | Load | Vout [V] | Ripple [mVp-p] | Vout [V] | Ripple [mVp-p] | Vout [V] | Ripple [mVp-p]
-20 | 0 | 5.138 | 20 | 5.142 | 23.6 | 5.141 | 24.4 |  |  |  |  |  | 26.08.2024
 | 0.1 | 5.085 | 21.2 | 5.102 | 24 | 5.109 | 24.4 |  |  |  | Start |  | 16:20:00 | Heat soak test |  | Load | 1.5
 | 0.5 | 5.077 | 26.8 | 5.077 | 26.4 | 5.078 | 23.6 |  |  |  |  |  |  |  |  | Vin | 32
 | 1 | 5.078 | 47.2 | 5.078 | 46.4 | 5.078 | 43.6 |  |  |  |  |  | 27.08.2024 |  |  | Ambient | 60
 | 1.5 | 5.078 | 67.2 | 5.077 | 64 | 5.077 | 62.4 |  |  |  | Stop |  | 8:20:00
24 | 0 | 5.138 | 18 | 5.138 | 20.8 | 5.14 | 19.6
 | 0.1 | 5.08 | 30.04 | 5.099 | 20.8 | 5.107 | 20.8
 | 0.5 | 5.067 | 25.2 | 5.068 | 28.4 | 5.068 | 26.8 |  |  |  |  |  | 16 h
 | 1 | 5.066 | 46 | 5.066 | 45.2 | 5.066 | 44.8
 | 1.5 | 5.064 | 68.4 | 5.064 | 66 | 5.064 | 69.2
60 | 0 | 5.147 | 17.6 | 5.146 | 21.6 | 5.147 | 22
 | 0.1 | 5.088 | 27.6 | 5.104 | 23.6 | 5.114 | 22 |  |  |  | Bandwith limit on oscilloscope set to 20MHz
 | 0.5 | 5.074 | 30 | 5.073 | 29.2 | 5.073 | 28.8
 | 1 | 5.076 | 54.8 | 5.075 | 50 | 5.076 | 55.2
 | 1.5 | 5.078 | 78.4 | 5.078 | 75.6 | 5.081 | 77.6
 |  |  |  |  |  |  |  |  |  |  | cold wake-up under load
 |  |  |  |  |  |  |  | Vin 32V
60 c | low - high | tek 002 |  |  |  |  |  | Cold startup under load
 | high - low | tek 006 |  |  |  |  |  | Vin off for 5 minutes to let the board cool.
 |  |  |  |  |  |  |  | 0A | 4,75ms | tek0012
-20 c | high - low | tek007 |  |  |  |  |  | 0,1A | 4,56ms | tek0014
 | low-high | tek010 |  |  |  |  |  | 0,2A | not starting |  | Tested also with Vin = 24
 |  |  |  |  |  |  |  |  |  |  | -20 | no start with 3,3R load
24 | low-high | tek 0019 |  |  |  |  |  |  |  |  |  | Ok start with 10R load
 | high-low | tek0021 |  |  |  |  |  |  |  |  |  | With 5,3R the voltage reaches 4,439V |  |  | If regulator
 |  |  |  |  |  |  |  | 0,5A |  | not starting - not reaching regulation voltage
 |  |  |  |  |  |  |  | 1A
 |  |  |  |  |  |  |  | 1,5A
 |  |  |  |  |  |  |  |  |  |  |  | 5,3R | tek 0016
 |  |  |  |  |  |  |  |  |  |  |  | 10R | tek 0017
 |  |  |  |  |  |  |  | Room temperature startuüp
 |  |  |  |  |  |  |  | 28V | not ok with electronic load 0,2A
Start under load
24 | tek 002
-20 | tek 003

Sheet: High current load
7.1
2 relays failed
It's unclear if it's a design fault or fault in testing
With first failure the switch used gave really indermittent signal causing the relay to switch on and off multiple time in short period.
It's possible that during turn-off D108 experienced many voltage spikes.
D108 gave different measurements during multimeter diode test compared to other diodes. It's possible that it does not work as a
protection device and that's the reason why the second relay failed on the first turn off. There was nothing to disable the ark.
 | Images in folder \KR-Df-01 (Fuse board)\Test reports\V0 Design verification\Power output images
1A | on | tek 0013
 | off | tek 0015
5A | on | tek 0017
 | off | tek 0018
10A | on | tek 0020
 | off | tek 0021
I | 15 | A
C | 22.5 | uF
E0 | 32 | V
R | 0.08325203252 | Ω

Sheet: Sheet1
Vin [V] | Calculated output [V] | Measured output [V]
24 | 2.18 | 2.21
28 | 2.55 | 2.58
32 | 2.91 | 2.91
Vin | 28V
Iout [A] | Calculated output [V] | Measured output [V]
0 | 1.65 | 1.641
1 | 1.716 | 1.708
3 | 1.848 | 1.841
5 | 1.98 | 1.972
10 | 2.31 | 2.304
15 | 2.64 | 2.635

Sheet: Replaced relay
 |  | 14V | 1s on | 5S 0ff
High current disconnect
20A | ok
25A | ok
28A | ok
30A | Fuse blown
