oleksandrkorkh/Fuse_board/Test reports/V0 Design verification/20A relay lifecycle test.xlsx

Sheet: Sheet1
16:27:17.422 -> 1073 793 792 |  | 500ms turn on
16:27:18.395 -> 1074 793 792 |  | 500 ms turn off
16:27:19.387 -> 1075 793 793 |  | 15A
16:27:20.416 -> 1076 793 791 |  | 60C |  |  | 16:25:31.373 -> 967 791 4
16:27:21.415 -> 1077 792 790 |  |  |  |  | 16:25:32.413 -> 968 788 0
16:27:22.383 -> 1078 789 793 |  |  |  |  | 16:25:33.487 -> 969 788 0
16:27:23.386 -> 1079 793 792 |  |  |  |  | 16:25:34.371 -> 970 789 0
16:27:24.418 -> 1080 792 792 |  |  |  | 16:26:17.376 -> 1013 794 794 | 16:25:35.379 -> 971 792 1
16:27:25.381 -> 1081 792 792 |  |  | 16:27:03.409 -> 1059 793 0 | 16:26:18.561 -> 1014 795 794 | 16:25:36.395 -> 972 792 0
16:27:26.388 -> 1082 793 793 |  |  | 16:27:04.388 -> 1060 793 1 | 16:26:19.375 -> 1015 792 794 | 16:25:37.408 -> 973 794 7
16:27:27.386 -> 1083 792 792 |  |  | 16:27:05.411 -> 1061 792 0 | 16:26:20.407 -> 1016 795 794 | 16:25:38.399 -> 974 793 0
16:27:28.414 -> 1084 792 792 |  |  | 16:27:06.419 -> 1062 794 792 | 16:26:21.382 -> 1017 793 795 | 16:25:39.400 -> 975 794 0
16:27:29.417 -> 1085 792 791 | 16:27:42.391 -> 1098 792 0 |  | 16:27:07.415 -> 1063 792 1 | 16:26:22.406 -> 1018 793 794 | 16:25:40.396 -> 976 793 2
16:27:30.378 -> 1086 789 792 | 16:27:43.403 -> 1099 794 0 |  | 16:27:08.402 -> 1064 793 792 | 16:26:23.377 -> 1019 794 792 | 16:25:41.373 -> 977 794 0
16:27:31.386 -> 1087 791 792 | 16:27:44.410 -> 1100 793 792 |  | 16:27:09.389 -> 1065 792 793 | 16:26:24.427 -> 1020 793 793 | 16:25:42.405 -> 978 794 0
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
 | 16:28:27.386 -> 1143 792 0 |  | Ln 36, Col 1 | Arduino Due (Programming Port)
 | 16:28:28.410 -> 1144 793 0 |  | Arduino Due (Programming Port) | on COM5 [not connected]
 | Ln 36, Col 1 |  | on COM5 [not connected]
 | Arduino Due (Programming Port)
 | on COM5 [not connected]

Sheet: Sheet2
16:38:33.172 -> 49 793 0 | 1s on
16:38:35.173 -> 50 793 0 | 1s off
16:38:37.212 -> 51 792 1 | 15A
16:38:39.206 -> 52 793 1 | 60C
16:38:41.206 -> 53 793 0
16:38:43.207 -> 54 793 1
16:38:45.207 -> 55 793 1
16:38:47.174 -> 56 795 1
16:38:49.175 -> 57 791 1
16:38:51.176 -> 58 791 0
16:38:53.196 -> 59 793 2
16:38:55.181 -> 60 791 1
16:38:57.180 -> 61 792 0
16:38:59.197 -> 62 792 0
16:39:01.215 -> 63 793 1
16:39:03.207 -> 64 792 0
16:39:05.192 -> 65 791 1
16:39:07.207 -> 66 793 1
16:39:09.177 -> 67 791 1
16:39:11.185 -> 68 792 0
16:39:13.179 -> 69 793 2
16:39:15.206 -> 70 794 0
16:39:17.188 -> 71 791 0
16:39:19.179 -> 72 793 0
16:39:21.197 -> 73 794 0
16:39:23.181 -> 74 793 1
16:39:25.213 -> 75 793 0
16:39:27.209 -> 76 791 0
16:39:29.183 -> 77 792 0
16:39:31.208 -> 78 792 1
16:39:33.208 -> 79 792 1
16:39:35.209 -> 80 793 0
16:39:37.174 -> 81 790 1
16:39:39.176 -> 82 793 0
16:39:41.197 -> 83 791 1
16:39:43.183 -> 84 790 0
16:39:45.173 -> 85 793 0
16:39:47.199 -> 86 792 1
16:39:49.205 -> 87 792 1
16:39:51.209 -> 88 793 792
16:39:53.197 -> 89 793 792
16:39:55.212 -> 90 792 793
16:39:57.182 -> 91 791 790
16:39:59.213 -> 92 793 792
16:40:01.208 -> 93 793 792
16:40:03.183 -> 94 793 792
16:40:05.208 -> 95 793 1
16:40:07.206 -> 96 792 1
16:40:09.209 -> 97 794 0
16:40:11.183 -> 98 793 793
16:40:13.186 -> 99 794 792
16:40:15.214 -> 100 794 792
16:40:17.201 -> 101 793 792
16:40:19.209 -> 102 793 791
16:40:21.181 -> 103 793 792
16:40:23.216 -> 104 794 792
16:40:25.196 -> 105 799 792
16:40:27.190 -> 106 795 794
16:40:29.218 -> 107 789 791
16:40:31.211 -> 108 793 792
16:40:33.209 -> 109 793 792
16:40:35.225 -> 110 793 791
16:40:37.181 -> 111 791 791
16:40:39.180 -> 112 792 791
16:40:41.192 -> 113 793 790
16:40:43.189 -> 114 791 792
16:40:45.209 -> 115 793 792
16:40:47.216 -> 116 793 790
16:40:49.204 -> 117 793 792
16:40:51.216 -> 118 793 791
16:40:53.214 -> 119 793 790
16:40:55.186 -> 120 791 0
16:40:57.211 -> 121 793 1
16:40:59.214 -> 122 792 0
16:41:01.176 -> 123 790 1
16:41:03.204 -> 124 794 793
16:41:05.188 -> 125 793 792
16:41:07.187 -> 126 788 793
16:41:09.180 -> 127 792 792
16:41:11.191 -> 128 793 793
16:41:13.181 -> 129 794 0
16:41:15.206 -> 130 791 2
16:41:17.202 -> 131 792 0
