oleksandrkorkh/Fuse_board/Test reports/V1 lifetime tests/logs/fb_lt_test_16_04_2025-10_48 (1).csv

Timestamp | Port no | State | Reason | Flags | Voltage_mV | Current_mA | Power_mW | Button
1744789752.1765628 | 0 | 1 | 2 | 0 | 24131 | 0 | 0 | 3 | 0
1744789752.3765032 | 1 | 1 | 2 | 0 | 23982 | 0 | 0 | 3 | 0
1744789752.7764425 | 2 | 3 | 2 | 8 | 24 | 0 | 0 | 2 | 0
1744789752.9764857 | 3 | 1 | 2 | 0 | 24021 | 94 | 226 | 44 | 0
1744789753.176495 | 4 | 1 | 2 | 0 | 23872 | 176 | 422 | 78 | 0
1744789753.3766215 | 5 | 1 | 2 | 0 | 24007 | 235 | 565 | 95 | 0
1744789753.5764785 | 6 | 1 | 2 | 0 | 23853 | 1471 | 3510 | 559 | 0
1744789753.7764764 | 7 | 1 | 2 | 0 | 23836 | 1463 | 3488 | 533 | 0
1744789766.2764413 | 0 | 0 | 2 | 0 | 19 | 4 | 0 | 3 | 0
1744789766.4763844 | 1 | 0 | 2 | 0 | 16 | 2 | 0 | 5 | 0
1744789766.8763137 | 2 | 0 | 2 | 8 | 8 | 3 | 0 | 2 | 0
1744789767.07636 | 3 | 0 | 2 | 0 | 8 | 0 | 0 | 91 | 0
1744789767.2763236 | 4 | 0 | 2 | 0 | 16 | 0 | 0 | 171 | 0
1744789767.4763834 | 5 | 0 | 2 | 0 | 13 | 0 | 0 | 224 | 0
1744789767.6763456 | 6 | 0 | 2 | 0 | 16 | 1 | 0 | 1394 | 0
1744789767.876322 | 7 | 0 | 2 | 0 | 11 | 6 | 0 | 1408 | 0
1744789770.576317 | 0 | 1 | 2 | 0 | 24156 | 0 | 0 | 4 | 0
1744789770.7763124 | 1 | 1 | 2 | 0 | 24024 | 0 | 0 | 7 | 0
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
