oleksandrkorkh/Fuse_board/Test reports/V1 Design verification/Testing pictures/Oscilloscope/tek00077.png

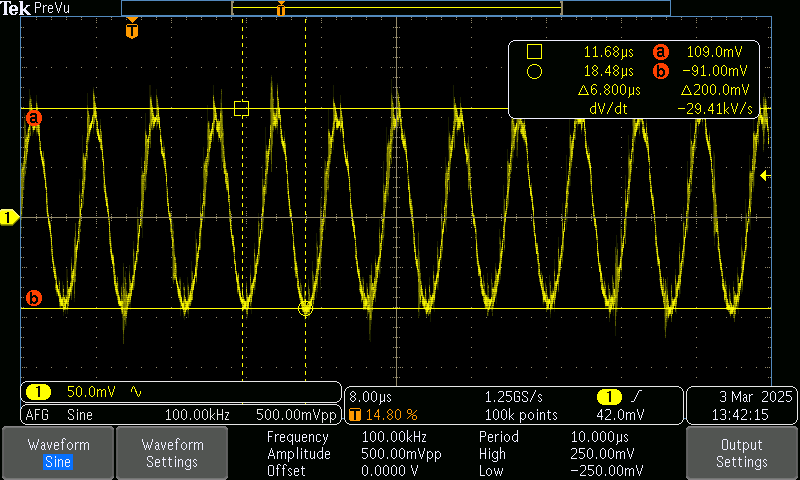
Test reports/V1 Design verification/Testing pictures/Oscilloscope/tek00077.png
