oleksandrkorkh/Fuse_board/Test reports/V1 Design verification/Testing pictures/Oscilloscope/tek00097.png

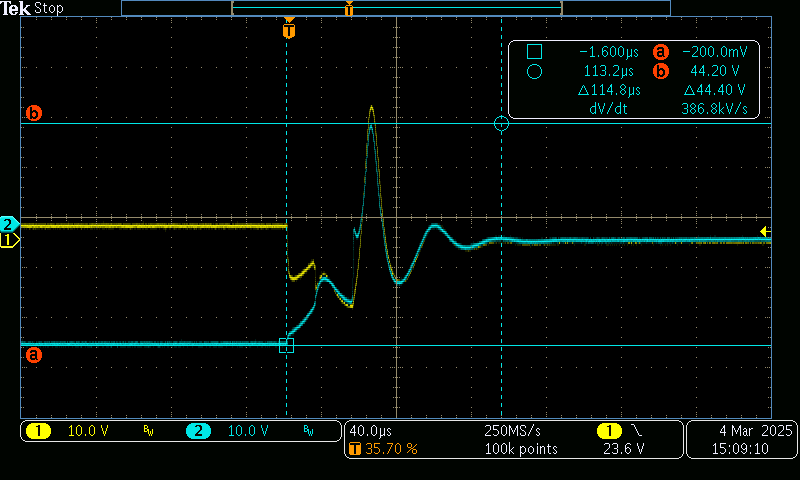
Test reports/V1 Design verification/Testing pictures/Oscilloscope/tek00097.png
