oleksandrkorkh/Fuse_board/Test reports/V1 Design verification/Testing pictures/Oscilloscope/tek00101.png

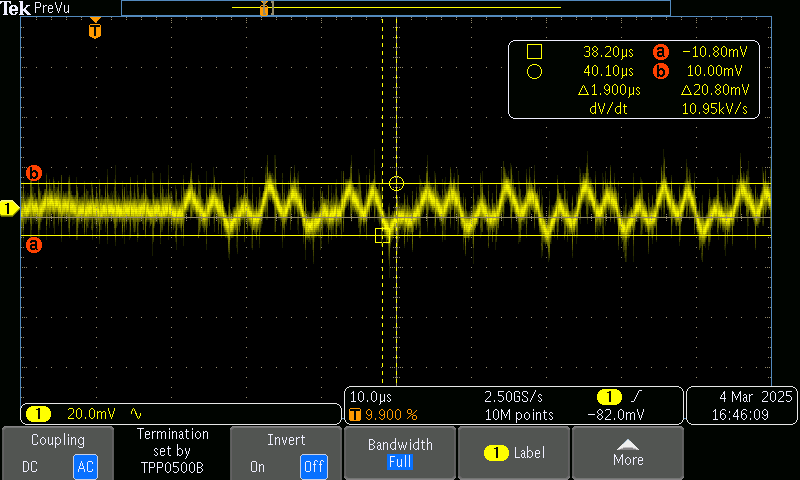
Test reports/V1 Design verification/Testing pictures/Oscilloscope/tek00101.png
