oleksandrkorkh/Fuse_board/Test reports/V1 lifetime tests/pictures/20250415_162416.jpg

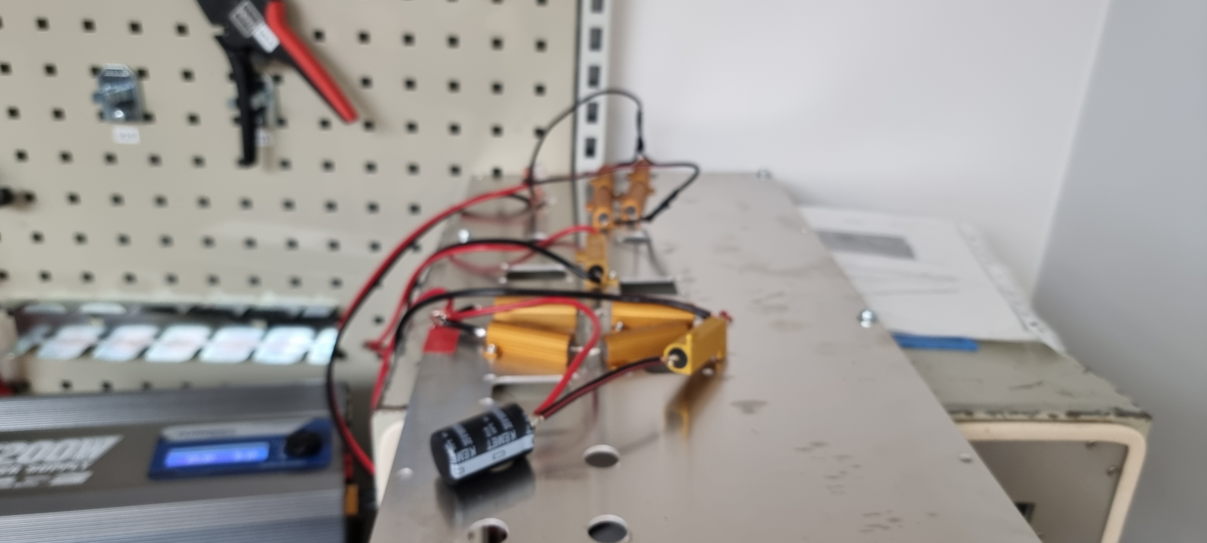
Test reports/V1 lifetime tests/pictures/20250415_162416.jpg
