oleksandrkorkh/Fuse_board/Test reports/V1 lifetime tests/pictures/20250416_104822.jpg

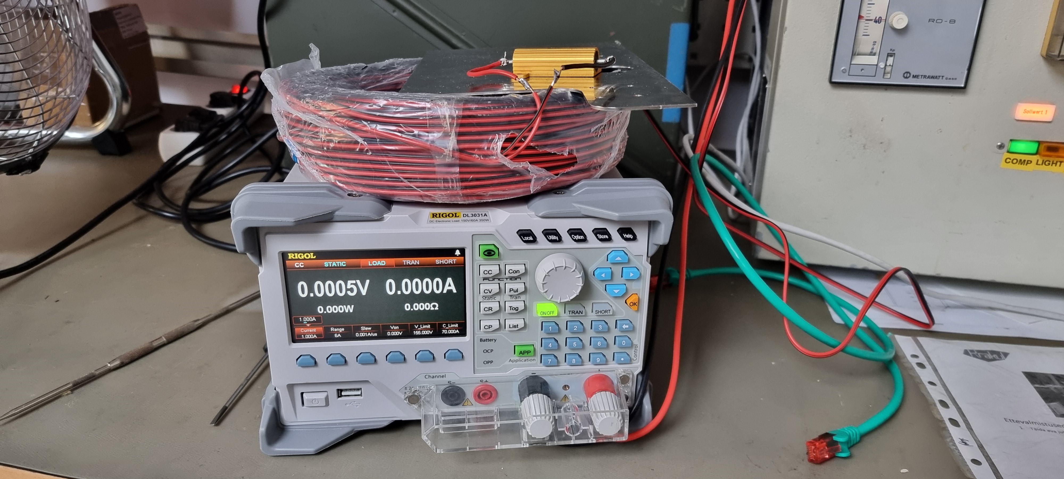
Test reports/V1 lifetime tests/pictures/20250416_104822.jpg
