oleksandrkorkh/Fuse_board/Test reports/V1 lifetime tests/pictures/20250417_162412.jpg

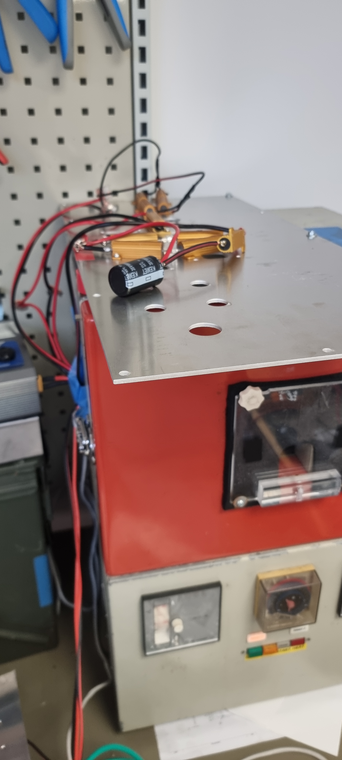
Test reports/V1 lifetime tests/pictures/20250417_162412.jpg
