oleksandrkorkh/Fuse_board/Electronics/Buttons and LED-s/Button and led design log.xlsx

1-1825027-1 |  | This the switch | Right angle
Need LED's
RGB adressable leds were requested
SMD
Options
https://www.digikey.ee/en/products/detail/inolux/IN-PI55TATPRPGPB/9681234 | 5x5 mm | 5V supply
IN-PI22TAT5R5G5B Inolux | Optoelectronics | DigiKey (https://www.digikey.ee/en/products/detail/inolux/IN-PI22TAT5R5G5B/9681237) | 2,7x2,4 mm | 5V supply
LTST-E563CEGBW Lite-On Inc. | Optoelectronics | DigiKey (https://www.digikey.ee/en/products/detail/liteon/LTST-E563CEGBW/9556406) | 5 x 5 mm | 4,2V - 5,5V
AAAF5050-MC-K12 Kingbright | Optoelectronics | DigiKey (https://www.digikey.ee/en/products/detail/kingbright/AAAF5050-MC-K12/10716547) | 5x5 mm | 5V supply
BL-HBGR32L-3-TRB-8 American Bright Optoelectronics Corporation | Optoelectronics | DigiKey (https://www.digikey.ee/en/products/detail/american-bright-optoelectronics-corporation/BL-HBGR32L-3-TRB-8/9817409) | 5x5 mm | 4,5V - 5,5V
