oleksandrkorkh/Fuse_board/Electronics/Current measurement/design log.xlsx

Component snatched from Bercman schematics.
Only difference is that 3,3V level component is selected
MCS1802GS-20-Z
MCS1802GS-20-Z Monolithic Power Systems (MPS) | Mouser Europe (https://eu.mouser.com/ProductDetail/Monolithic-Power-Systems-MPS/MCS1802GS-20-Z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)
 |  | I=U/R
Conductor resistance
0.9 | mOhm
0.0009 | Ohm
20 | A
0.36 | W
0.000324 | V
