oleksandrkorkh/Fuse_board/Electronics/PCB/PCB design log.xlsx

Sheet: 80A
Limited by the connector
the 10mm2 cross section area connector considered can carry up to ~ 80A. Consider the PCB tolerate the same.
Cross section to wire diameter
10
A=pi * r2
r2 | = | 3.183098862
r2 | = | 1.784124116
d | = | 3.568248232
Final thickness around ~ 140 um

Sheet: 40A
What I think is reasonable

Sheet: Embedded copper
Embedded copper

Sheet: Thick copper
Must create narrower pads for MCU pins. 0,25 instead 0,3mm

Sheet: Stackup
See

Sheet: Sheet2
Multiple layers will be used to carry the current - 15A
