oleksandrkorkh/Fuse_board/Electronics/Power Input/Power input design log.xlsx

Sheet: Sheet1
Spring loaded terminal
100 cycles
10 mm2 | ~ | AWG 7
200W input power
8.333333333 |  | 30A option | 51A | EB171A-02-H Adam Tech | Connectors, Interconnects | DigiKey (https://www.digikey.ee/en/products/detail/adam-tech/EB171A-02-H/9831873) | Isegi kui voolus madalamaks minna ei leia 10mm2 asja mis oleks väiksem
 |  |  |  |  | 1017521 Phoenix Contact | Connectors, Interconnects | DigiKey (https://www.digikey.ee/en/products/detail/phoenix-contact/1017521/9346615)
 |  | 120A option | 78A | 2616-1352 WAGO Corporation | Connectors, Interconnects | DigiKey (https://www.digikey.ee/en/products/detail/wago-corporation/2616-1352/15522075)
https://www.digikey.ee/en/products/detail/phoenix-contact/1017503/9346604

Sheet: Reverse polarity protection
For logic part only

Sheet: Power loss and resistance
Copper resistivity | 1.68e-08 | Ω*m
Width | 0.005 | m
Height | 0.001 | m
Length | 0.1 | m
Piece resistance | 0.000336 | Ω
