oleksandrkorkh/Fuse_board/Electronics/Schematic/KR-Df-01-EL-00 v0 2024_01_29 PRELIMINARY.pdf

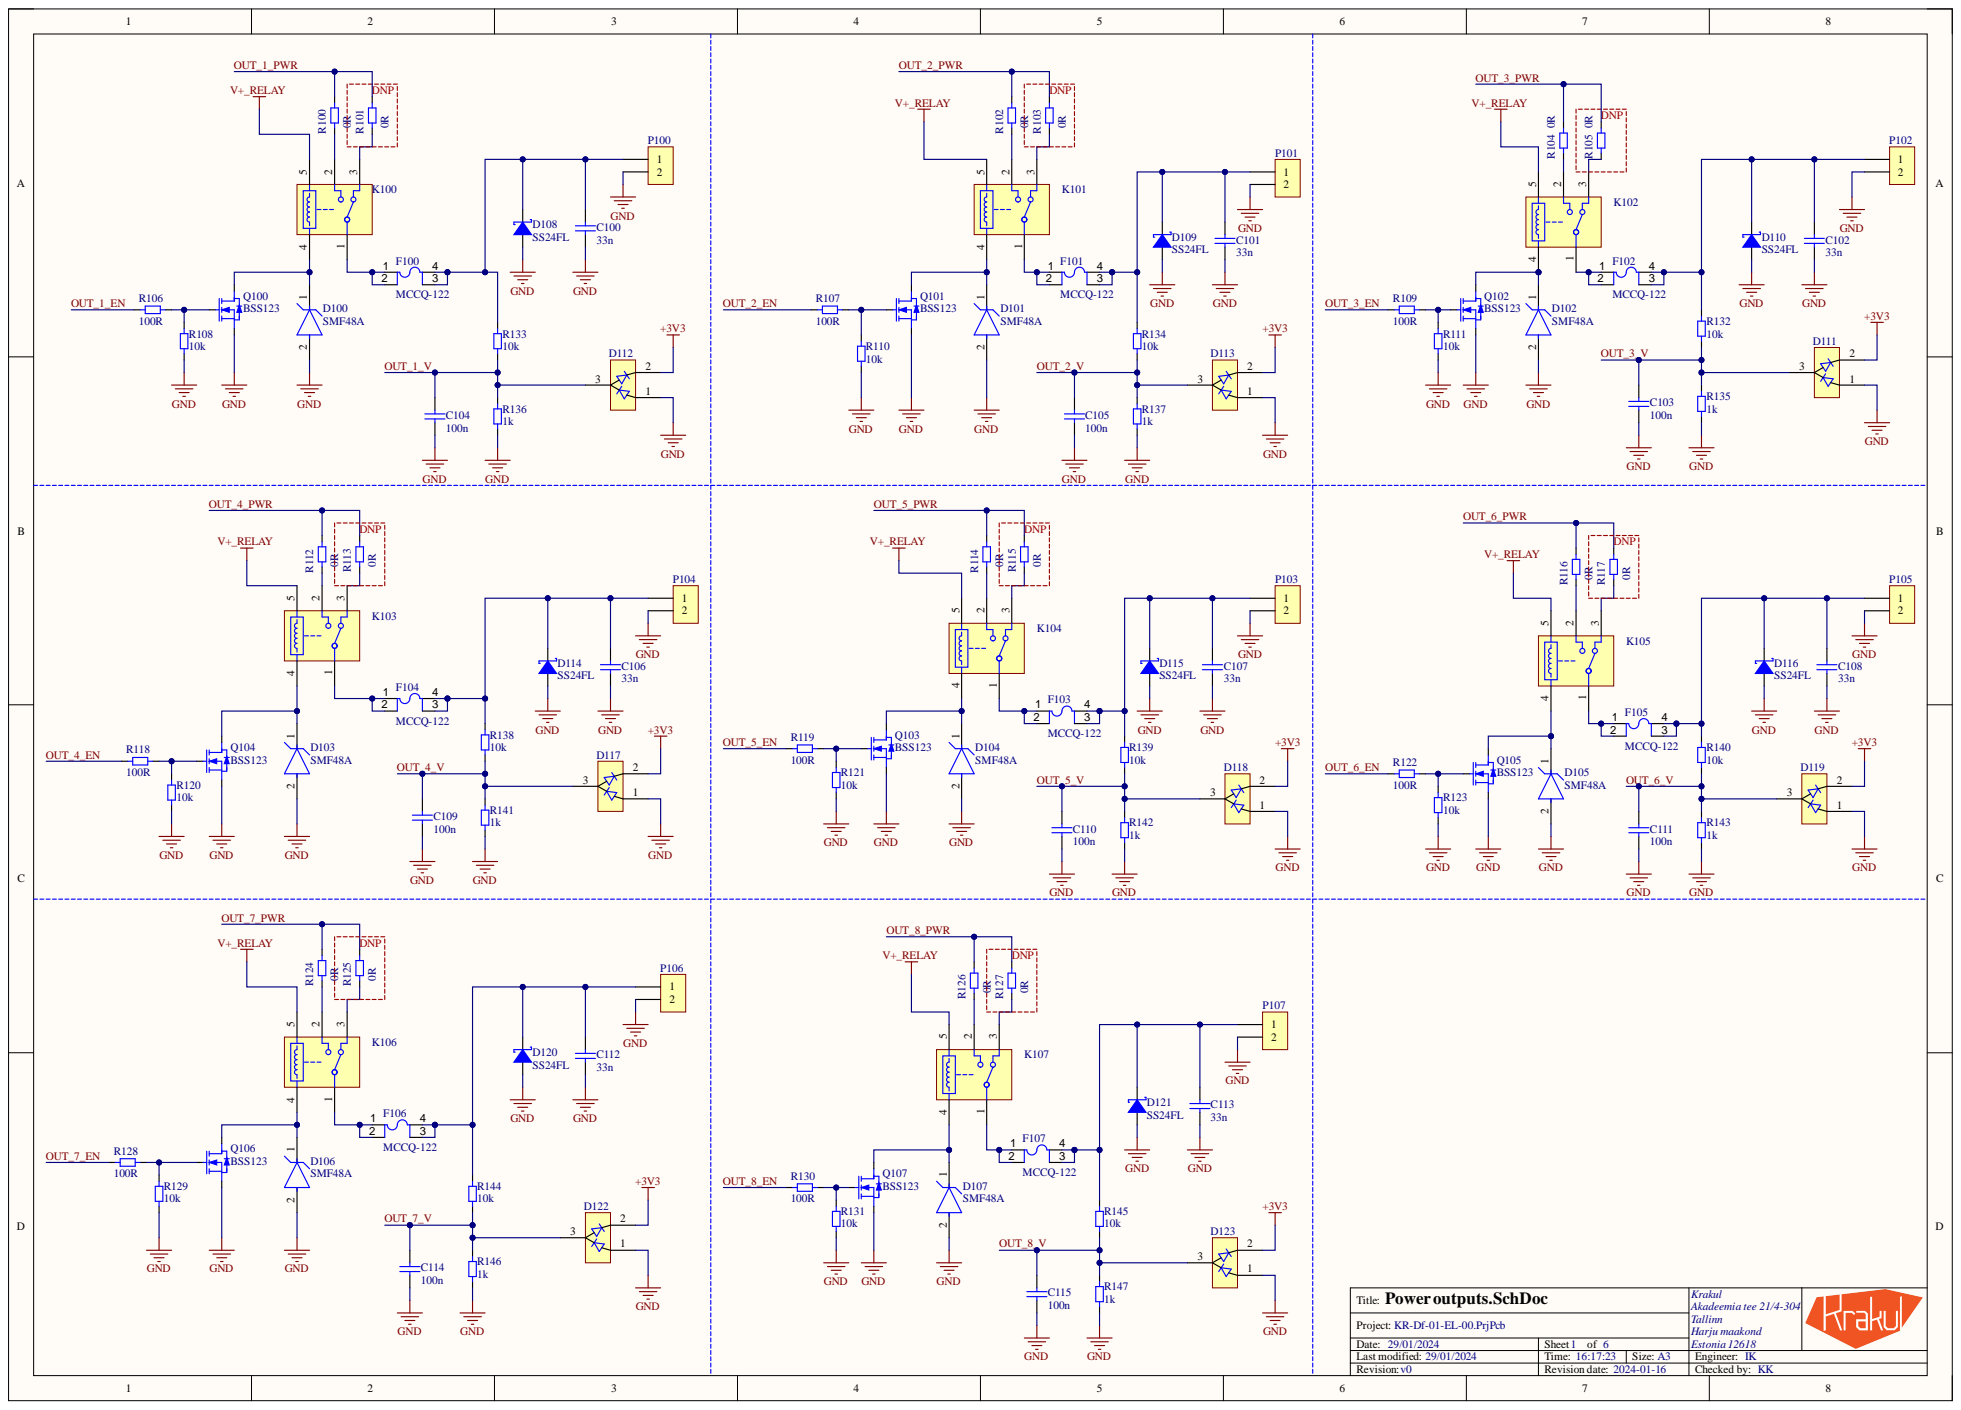
[picture p232: page 1]

Project: KR-Df-01-EL-00.PrjPcb
Date:
Revision:

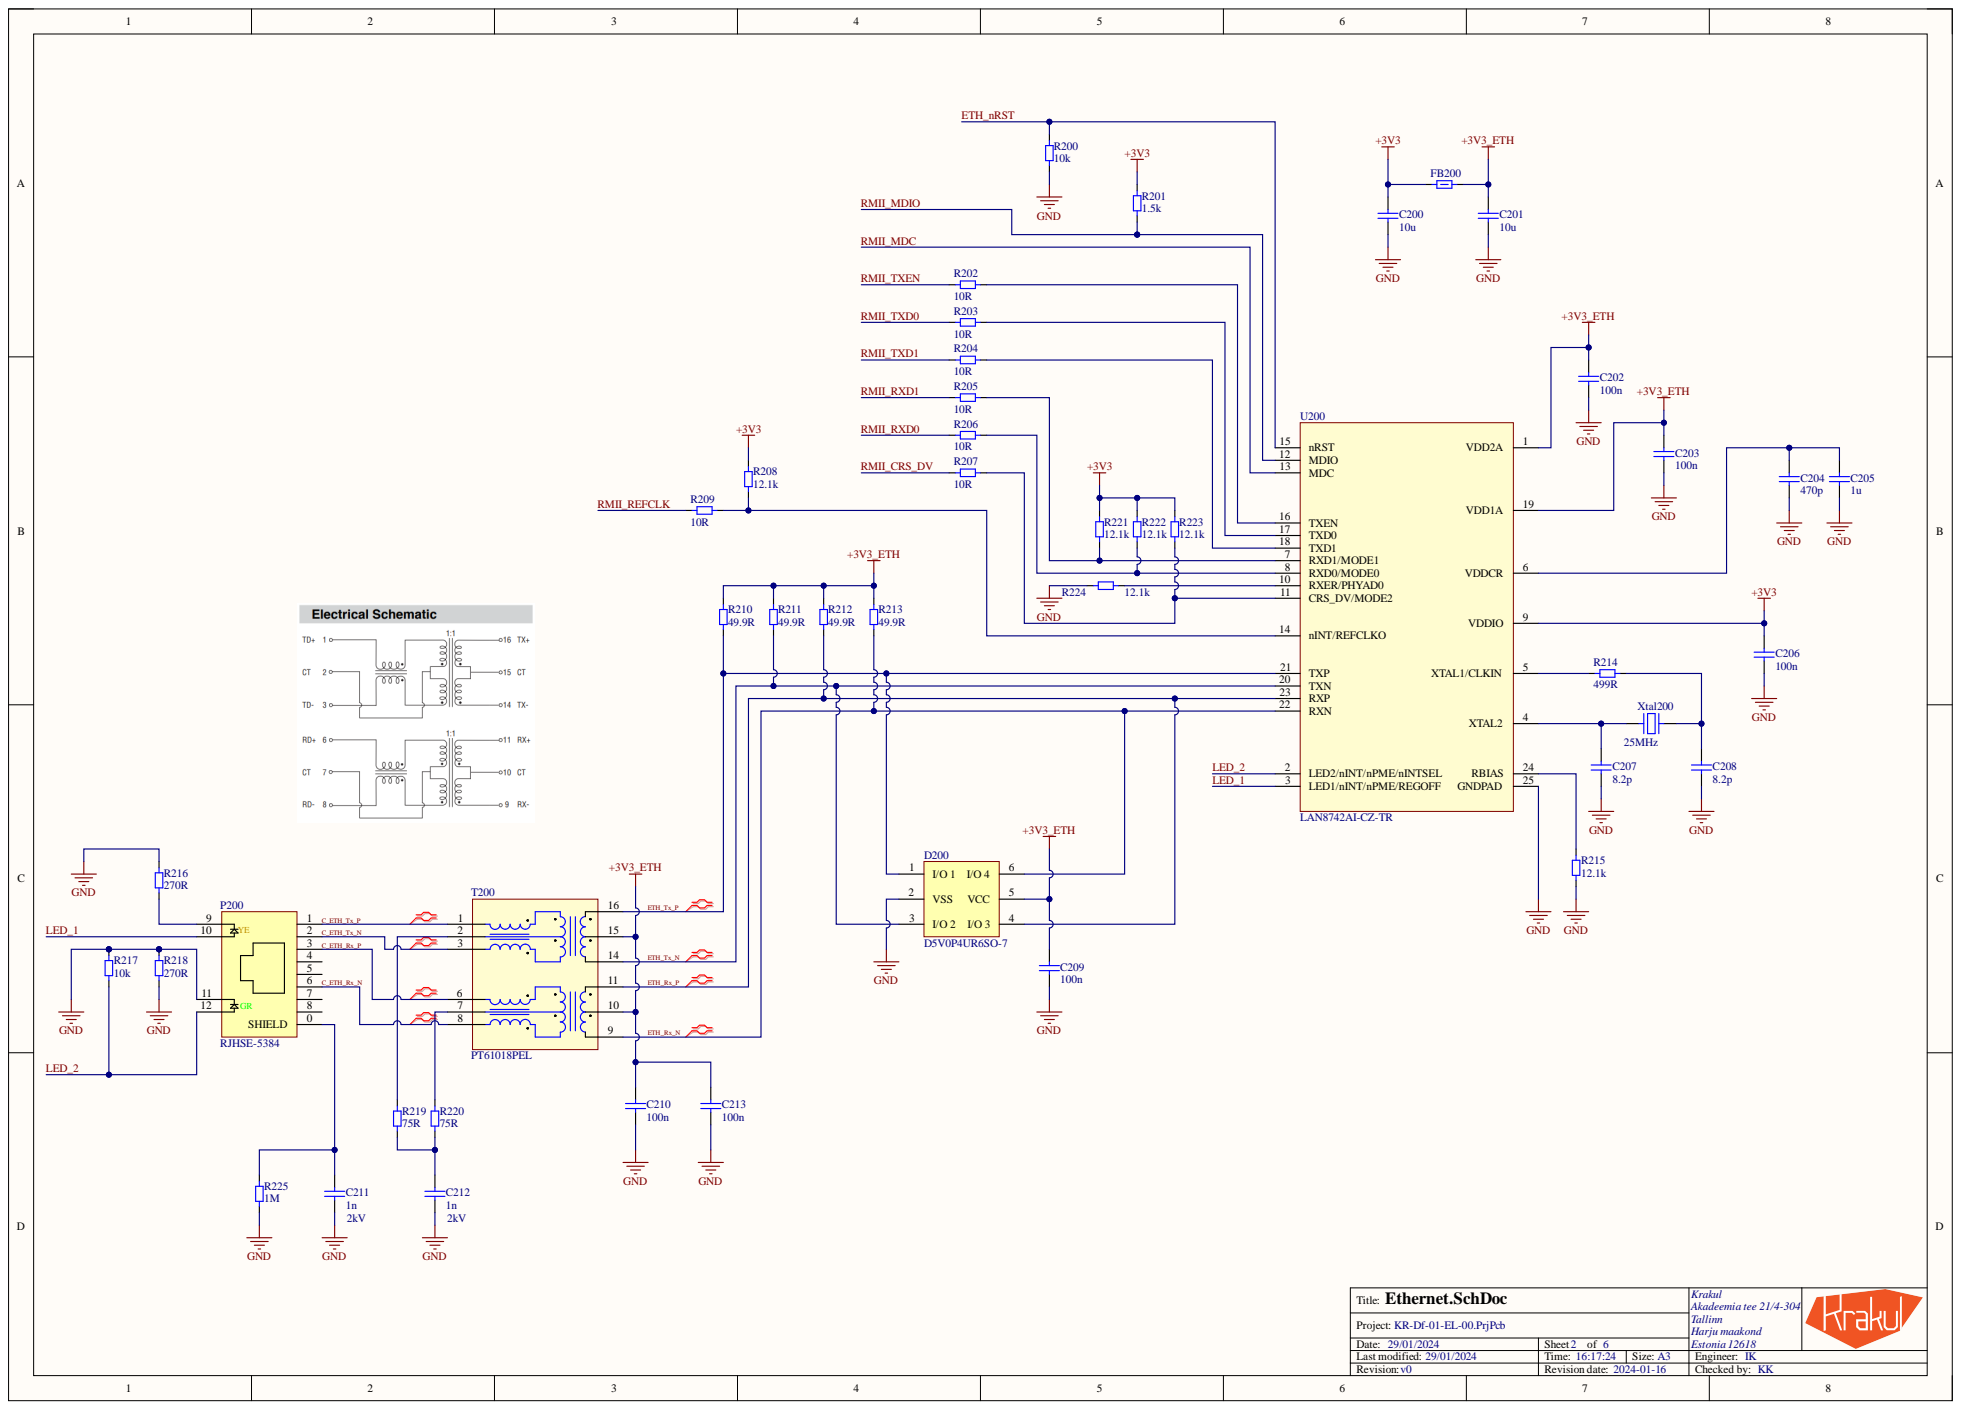
[picture p233: page 2]

TXEN 16

TXD1 18

RXD0/MODE0 8

TXN 20 TXP 21

RXN 22 RXP 23

25MHz

D200 | +3V3_ETH | LED2/nINT/nPME/nINTSEL 2 LED1/nINT/nPME/REGOFF 3

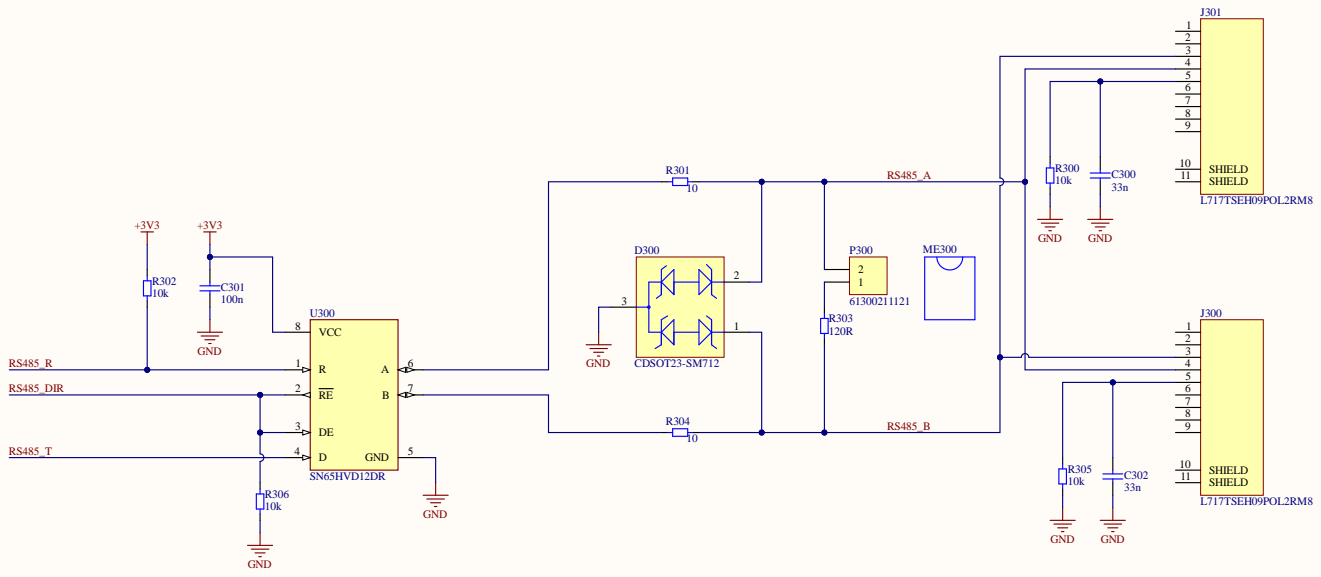
[picture p234: page 3]

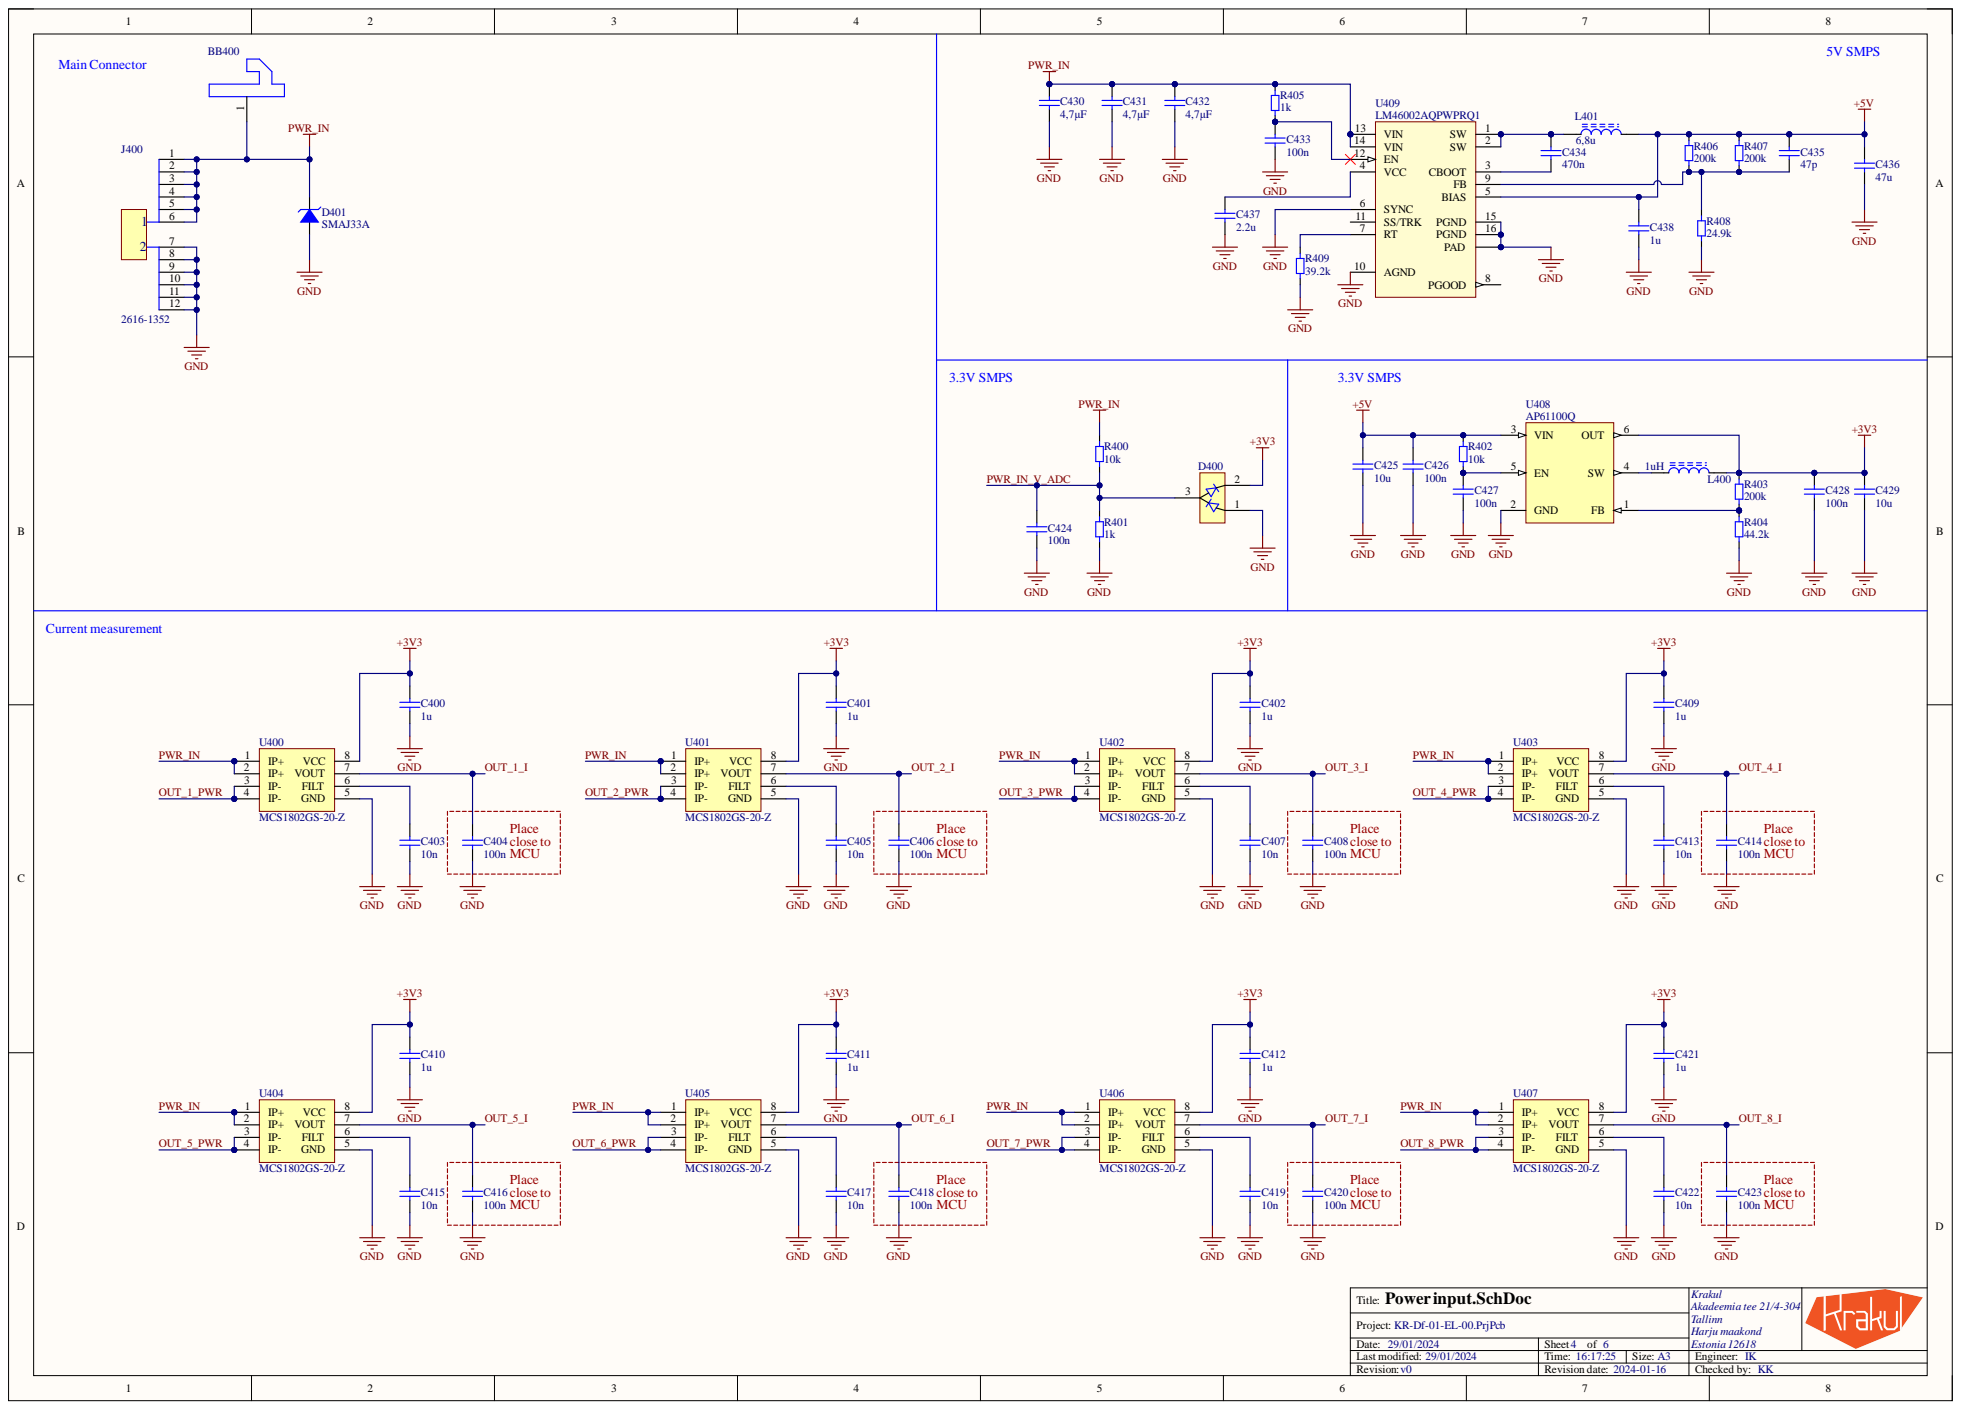
[picture p235: page 4]

Place close to MCU

Place close to MCU C416

Place close to MCU C418

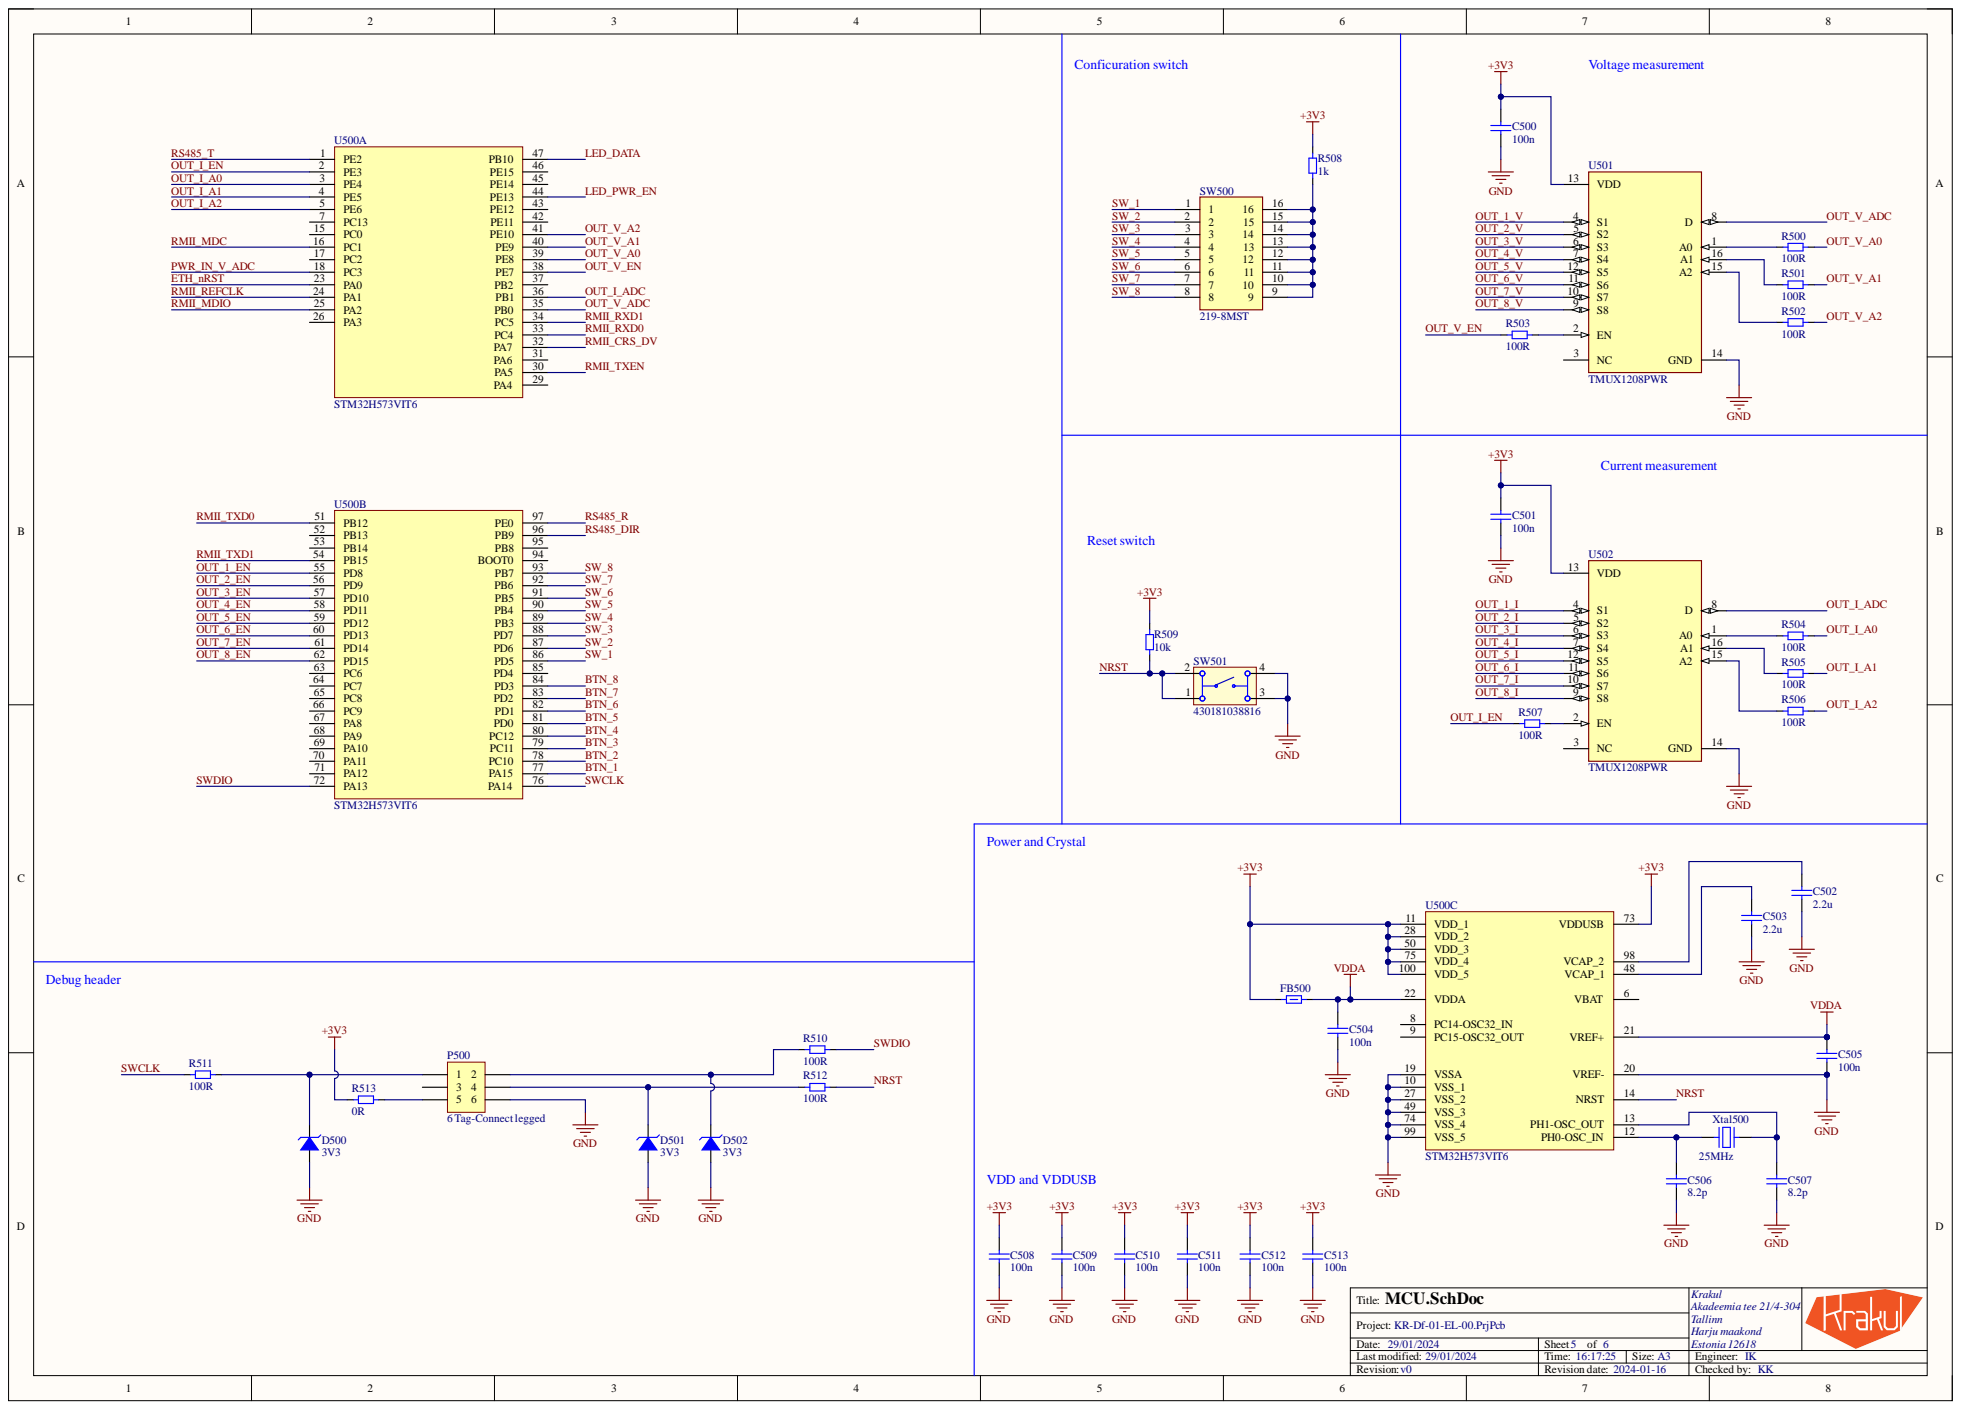
[picture p236: page 5]

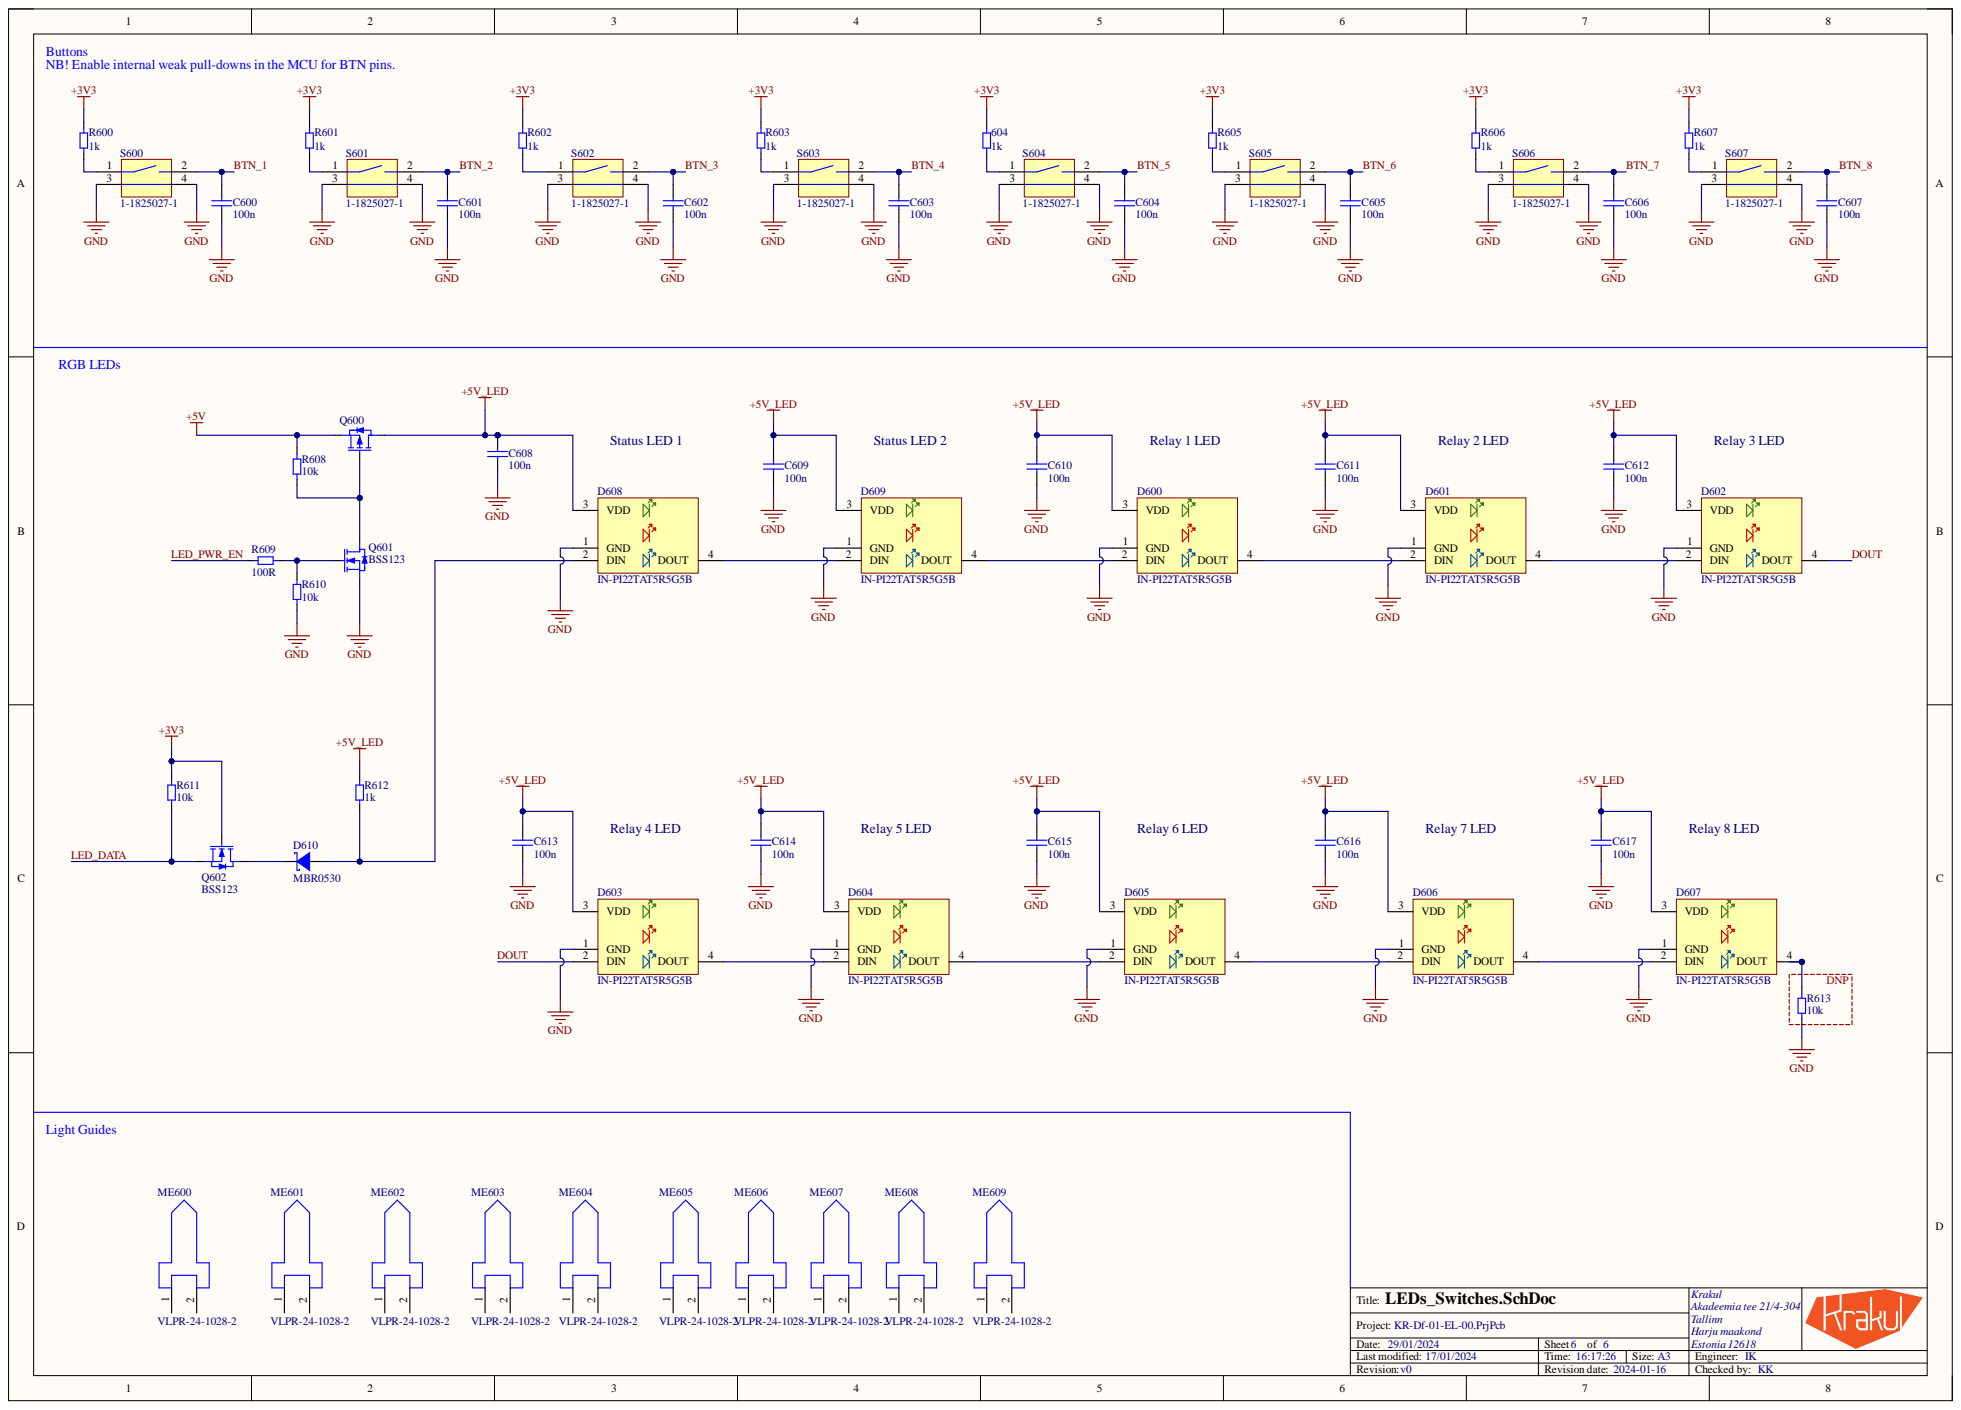
[picture p237: page 6]

Buttons
NB! Enable internal weak pull-downs in the MCU for BTN pins.
