oleksandrkorkh/Fuse_board/Electronics/Schematic/KR-Df-01-EL-00 v0 2024_02_21.pdf

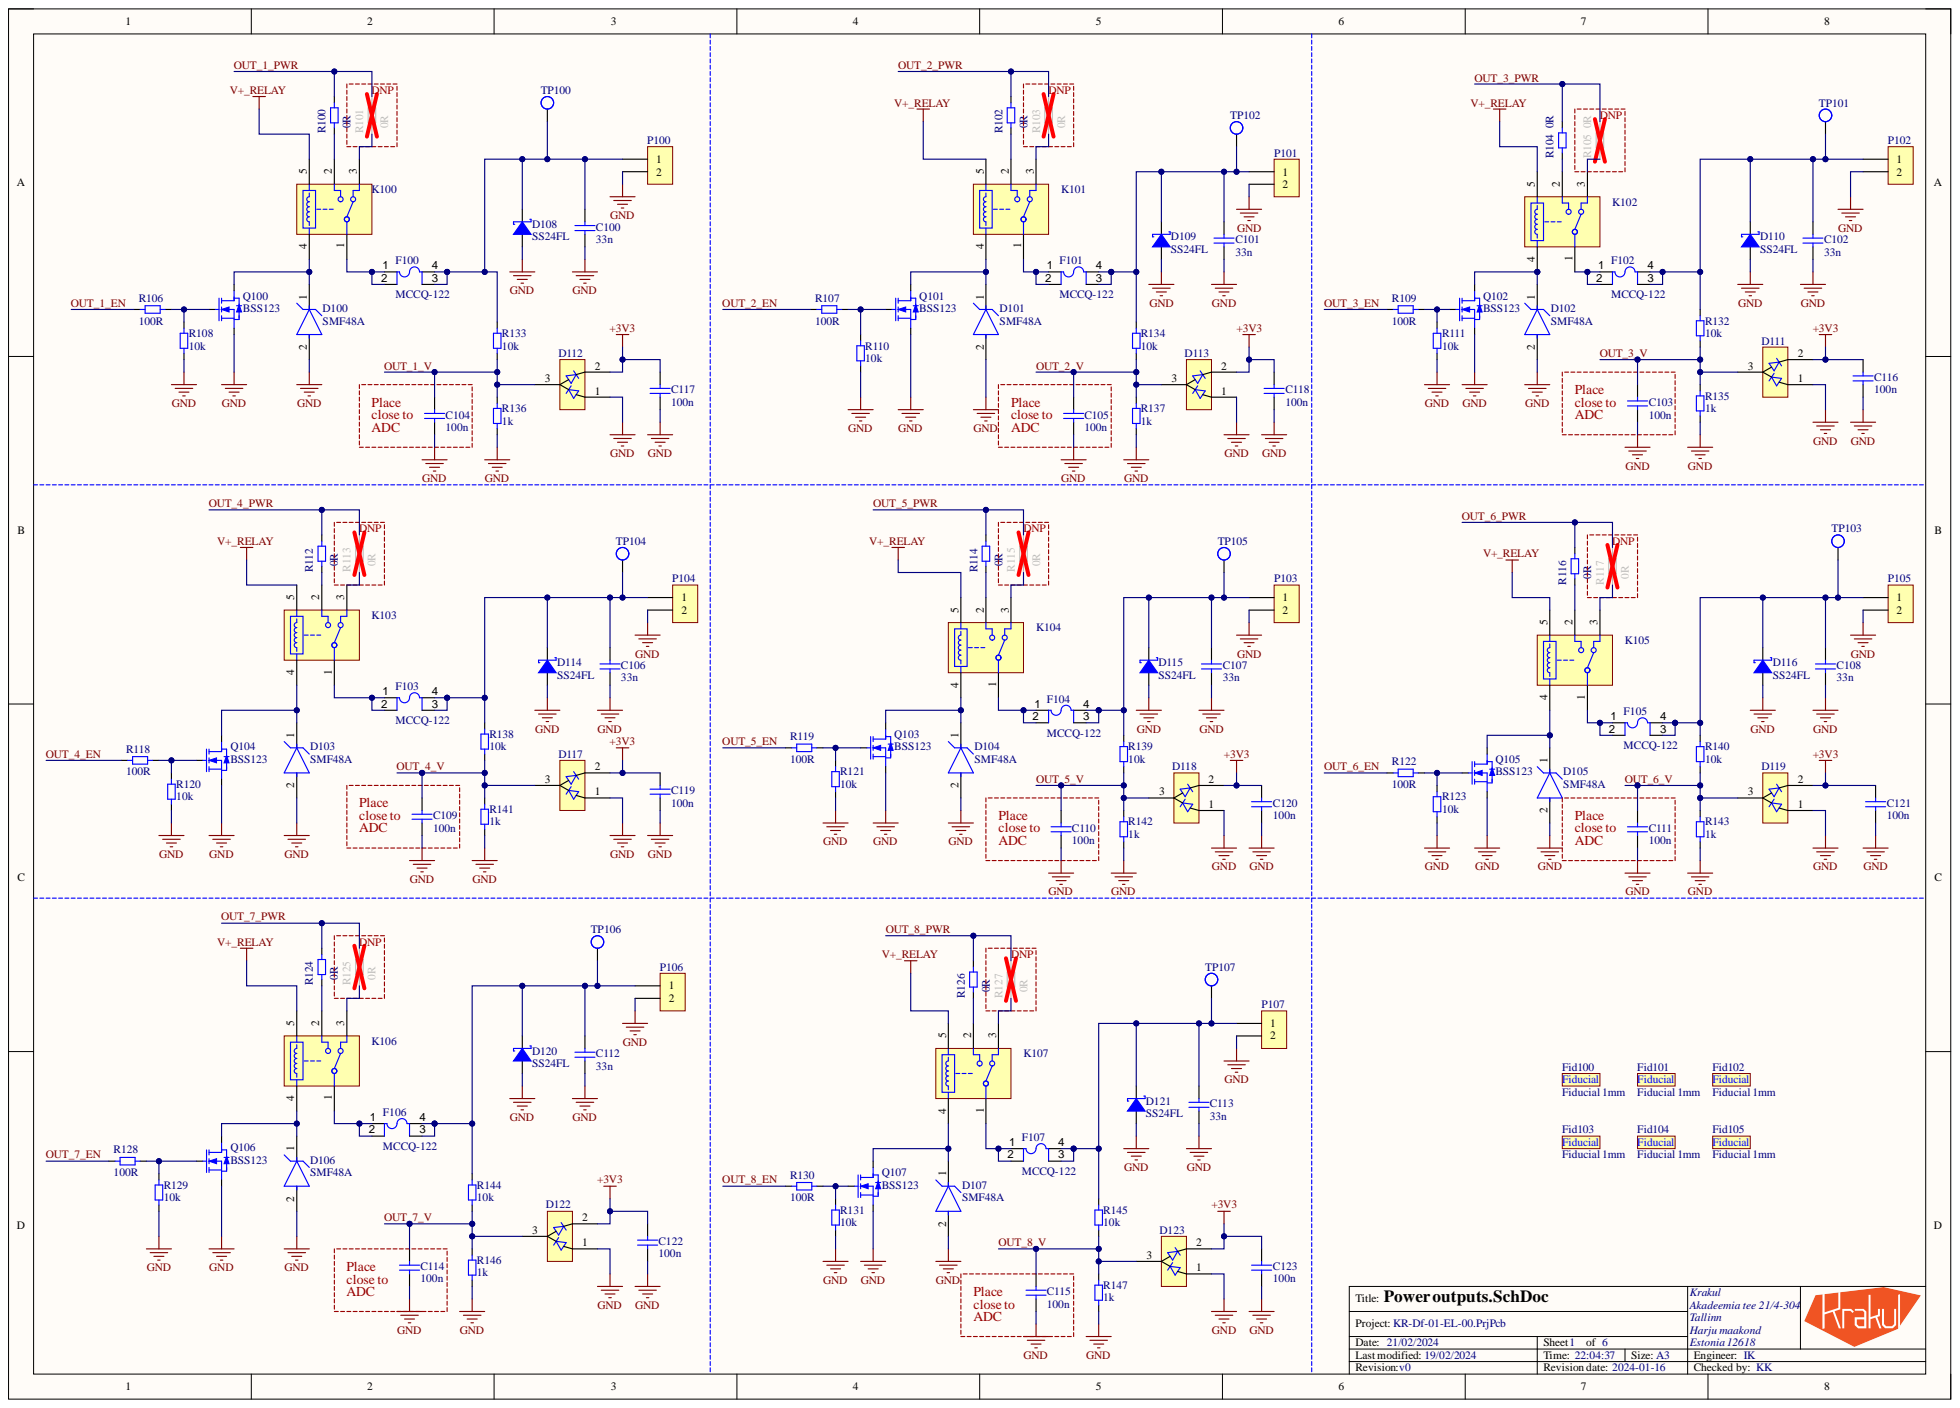
[picture p238: page 1]

Place close to ADC

Project: KR-Df-01-EL-00.PrjPcb
Date:
Revision:

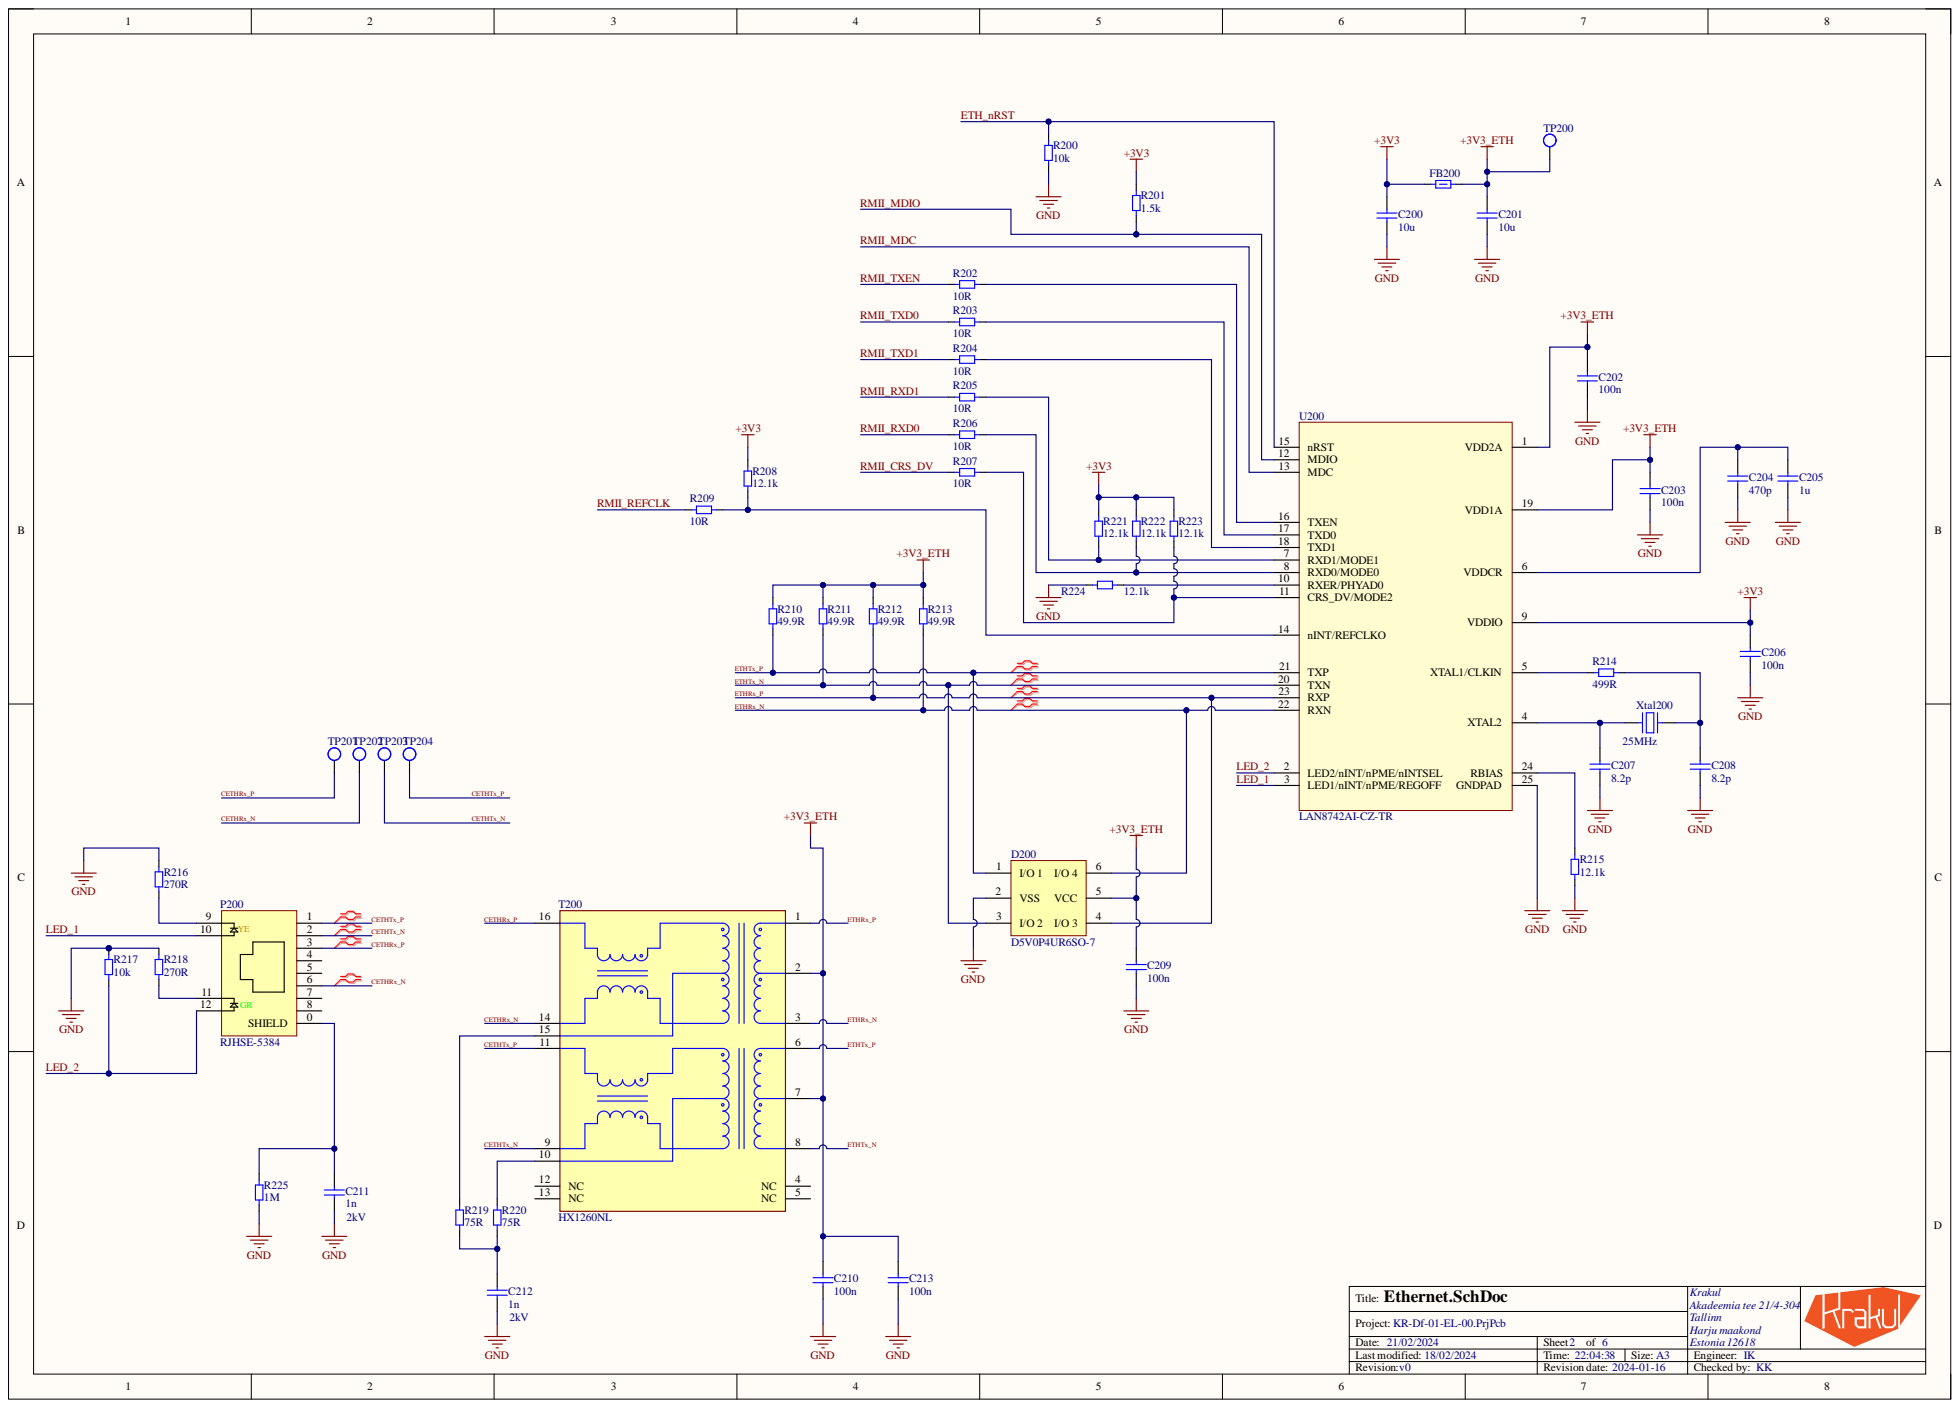
[picture p239: page 2]

TXEN 16
TXD0 17
TXD1 18

+3V3_ETH

RXD0/MODE0 8
RXER/PHYAD0 10 CRS_DV/MODE2 11

RXN 22 RXP 23

D200 | +3V3_ETH | | LED2/nINT/nPME/nINTSEL 2 LED1/nINT/nPME/REGOFF 3

CETHTx_N | 11 9 10

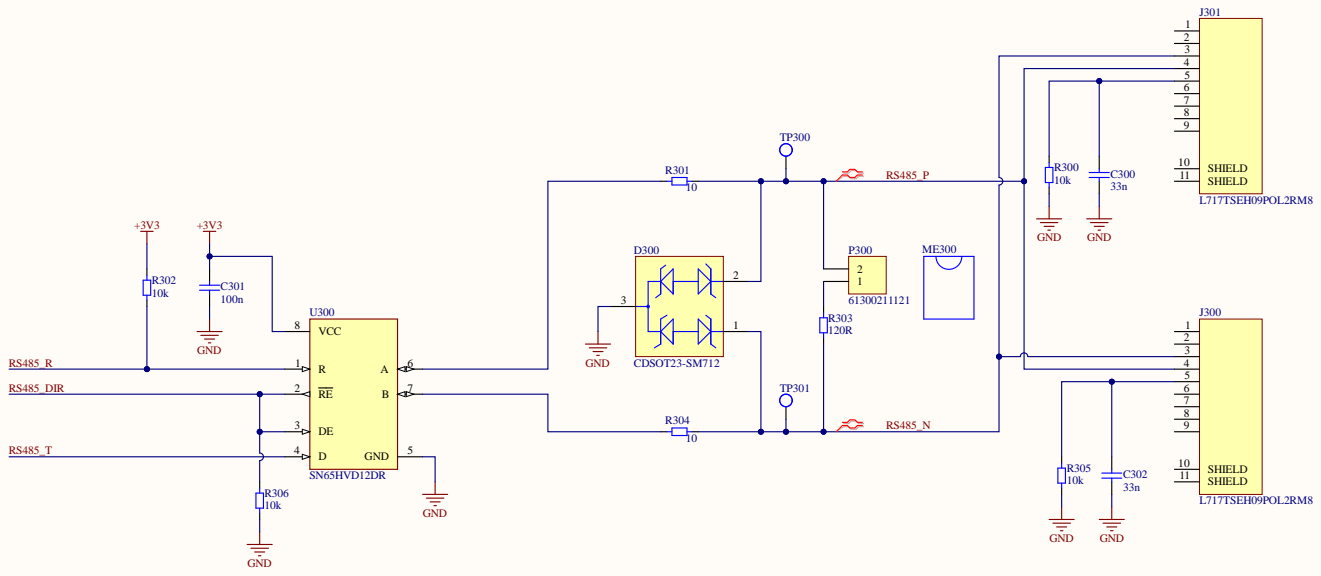
[picture p240: page 3]

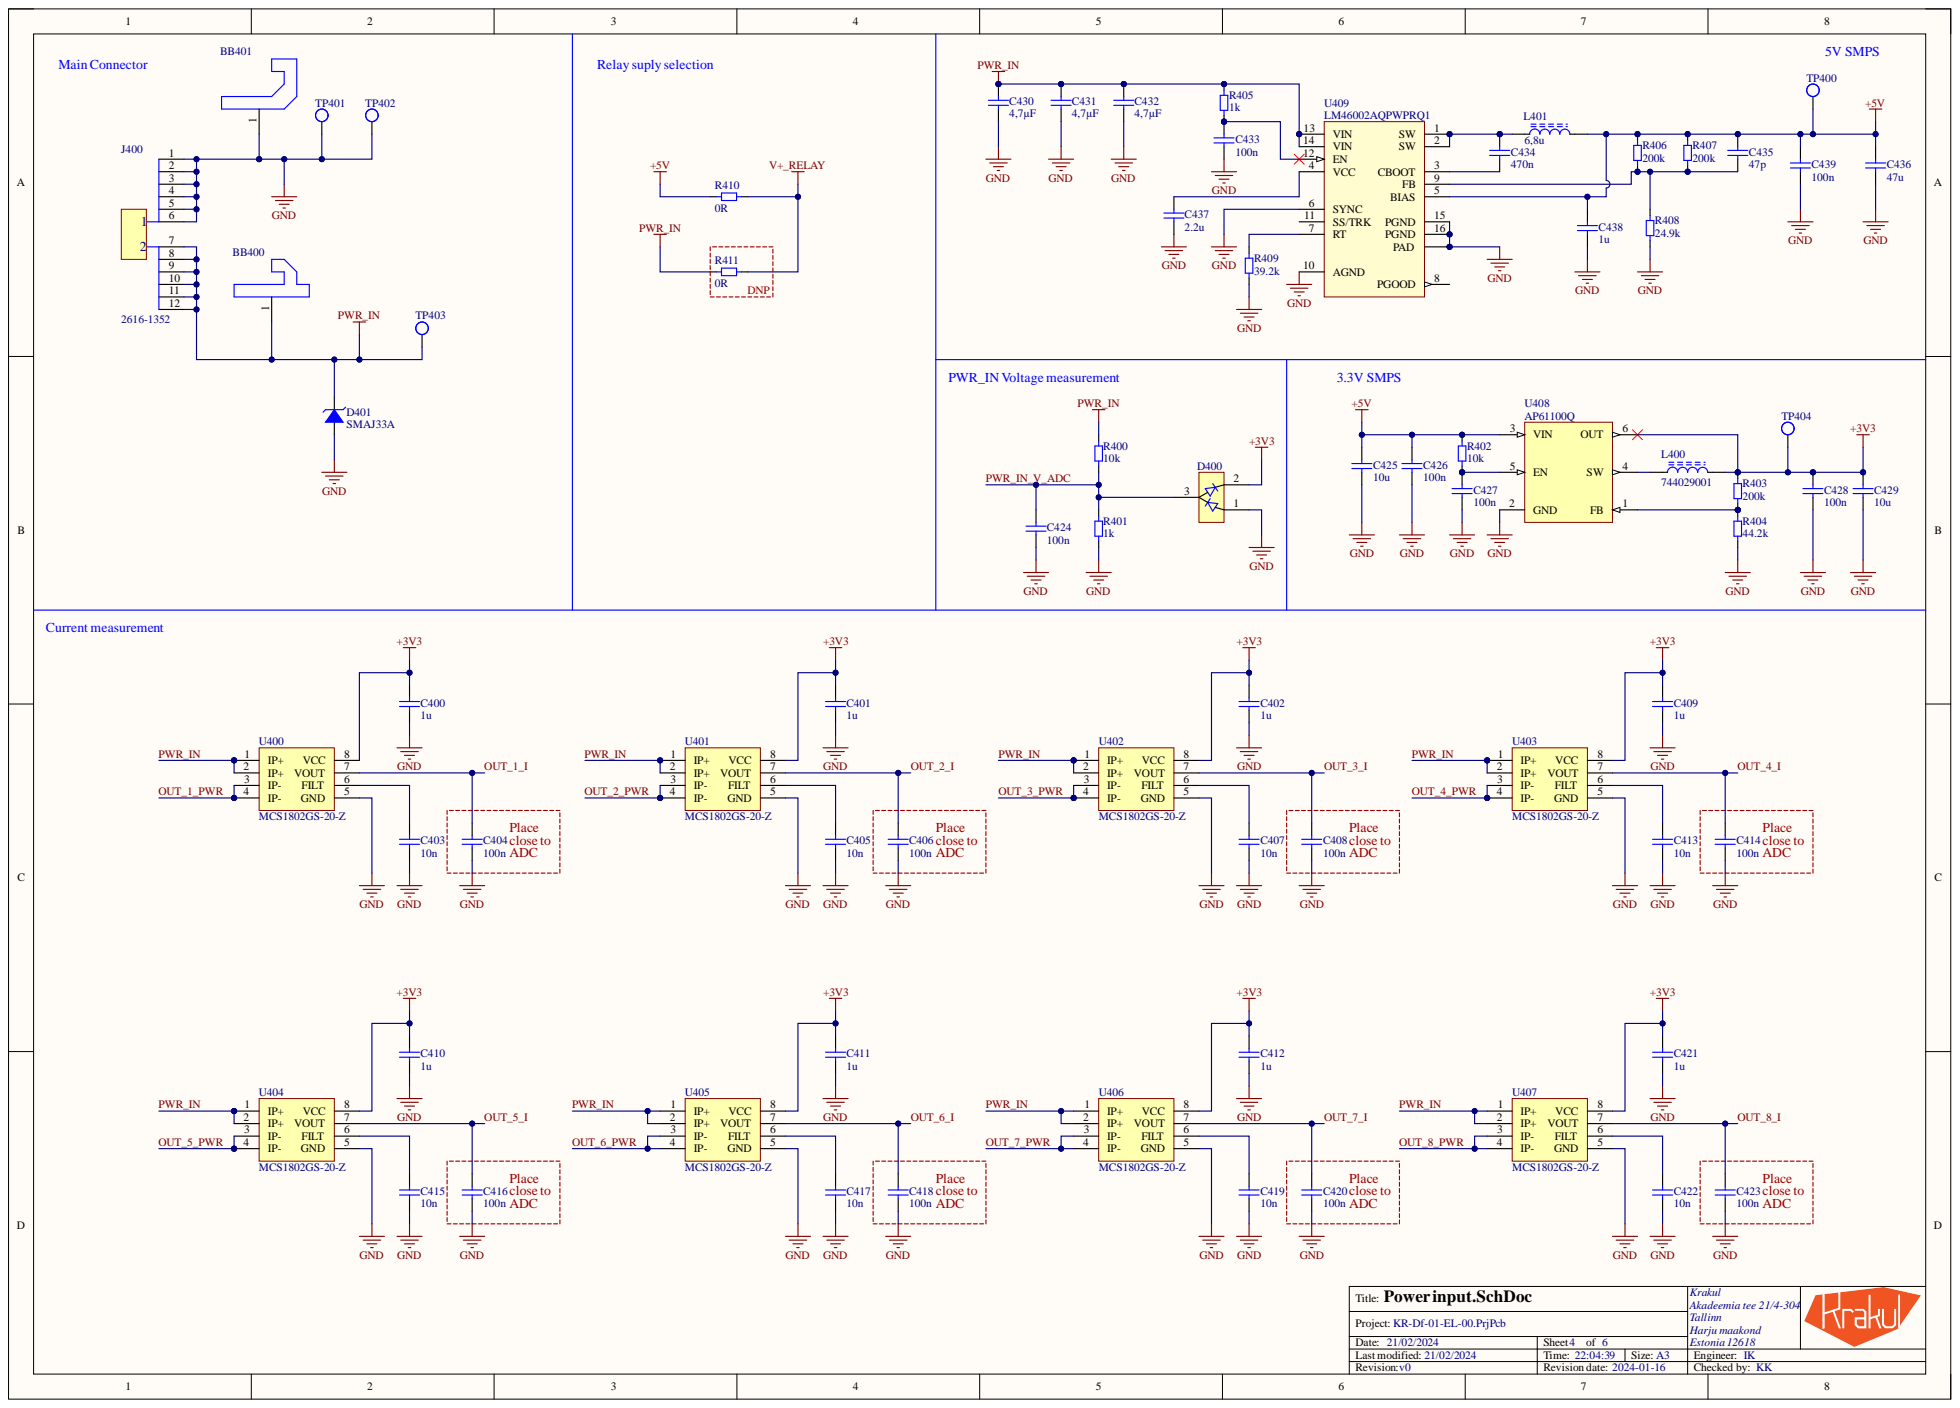
[picture p241: page 4]

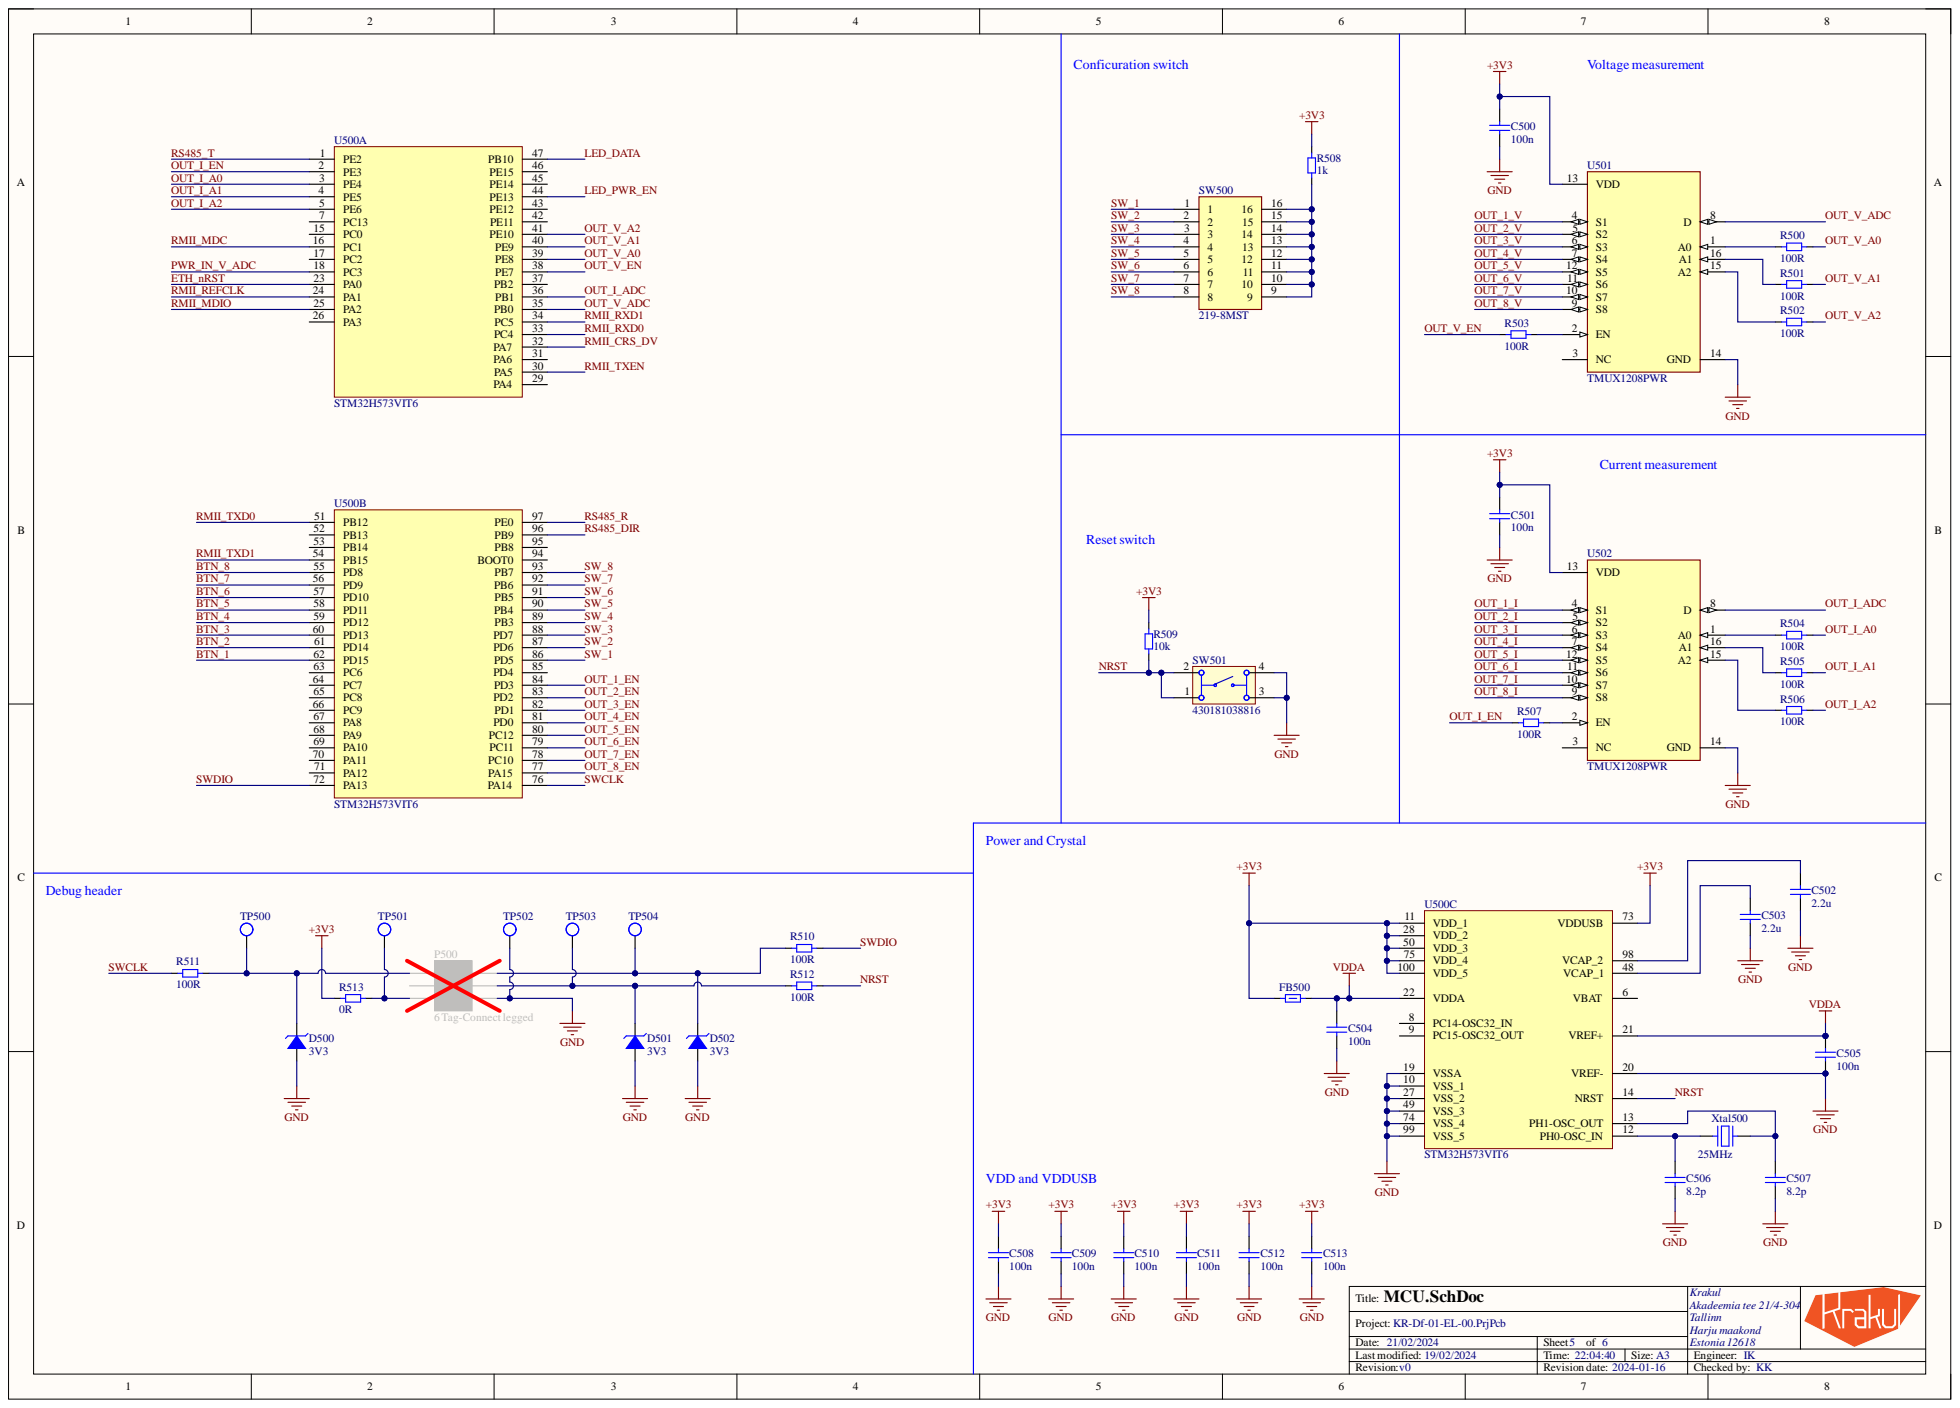
[picture p242: page 5]

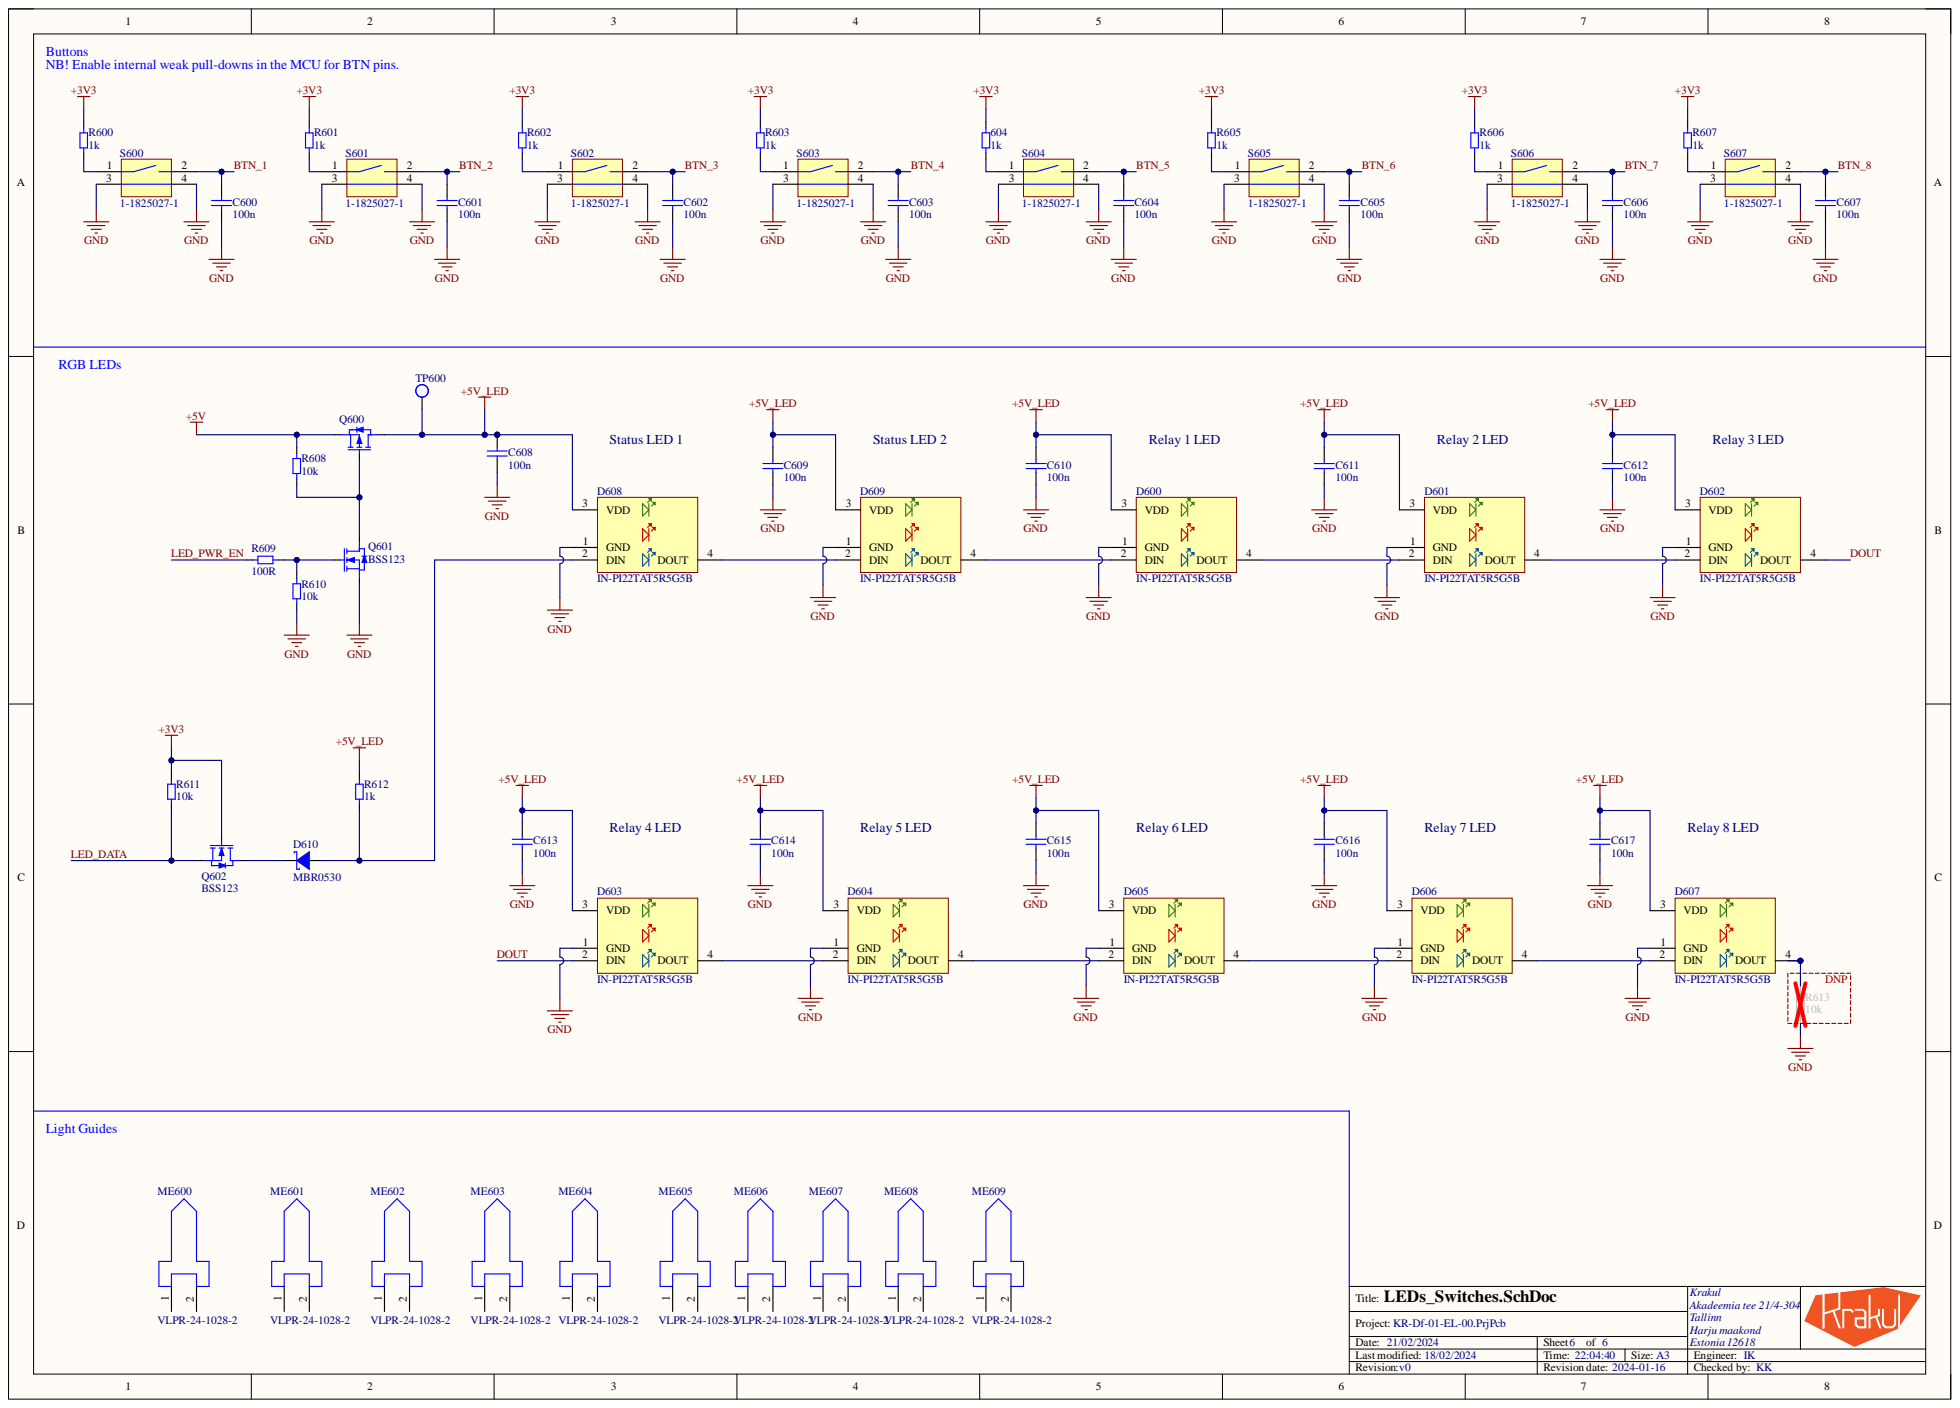
[picture p243: page 6]

Buttons
NB! Enable internal weak pull-downs in the MCU for BTN pins.
