oleksandrkorkh/Fuse_board/Electronics/Schematic/KR-Df-01-EL-00 v1 2024_12_18.pdf

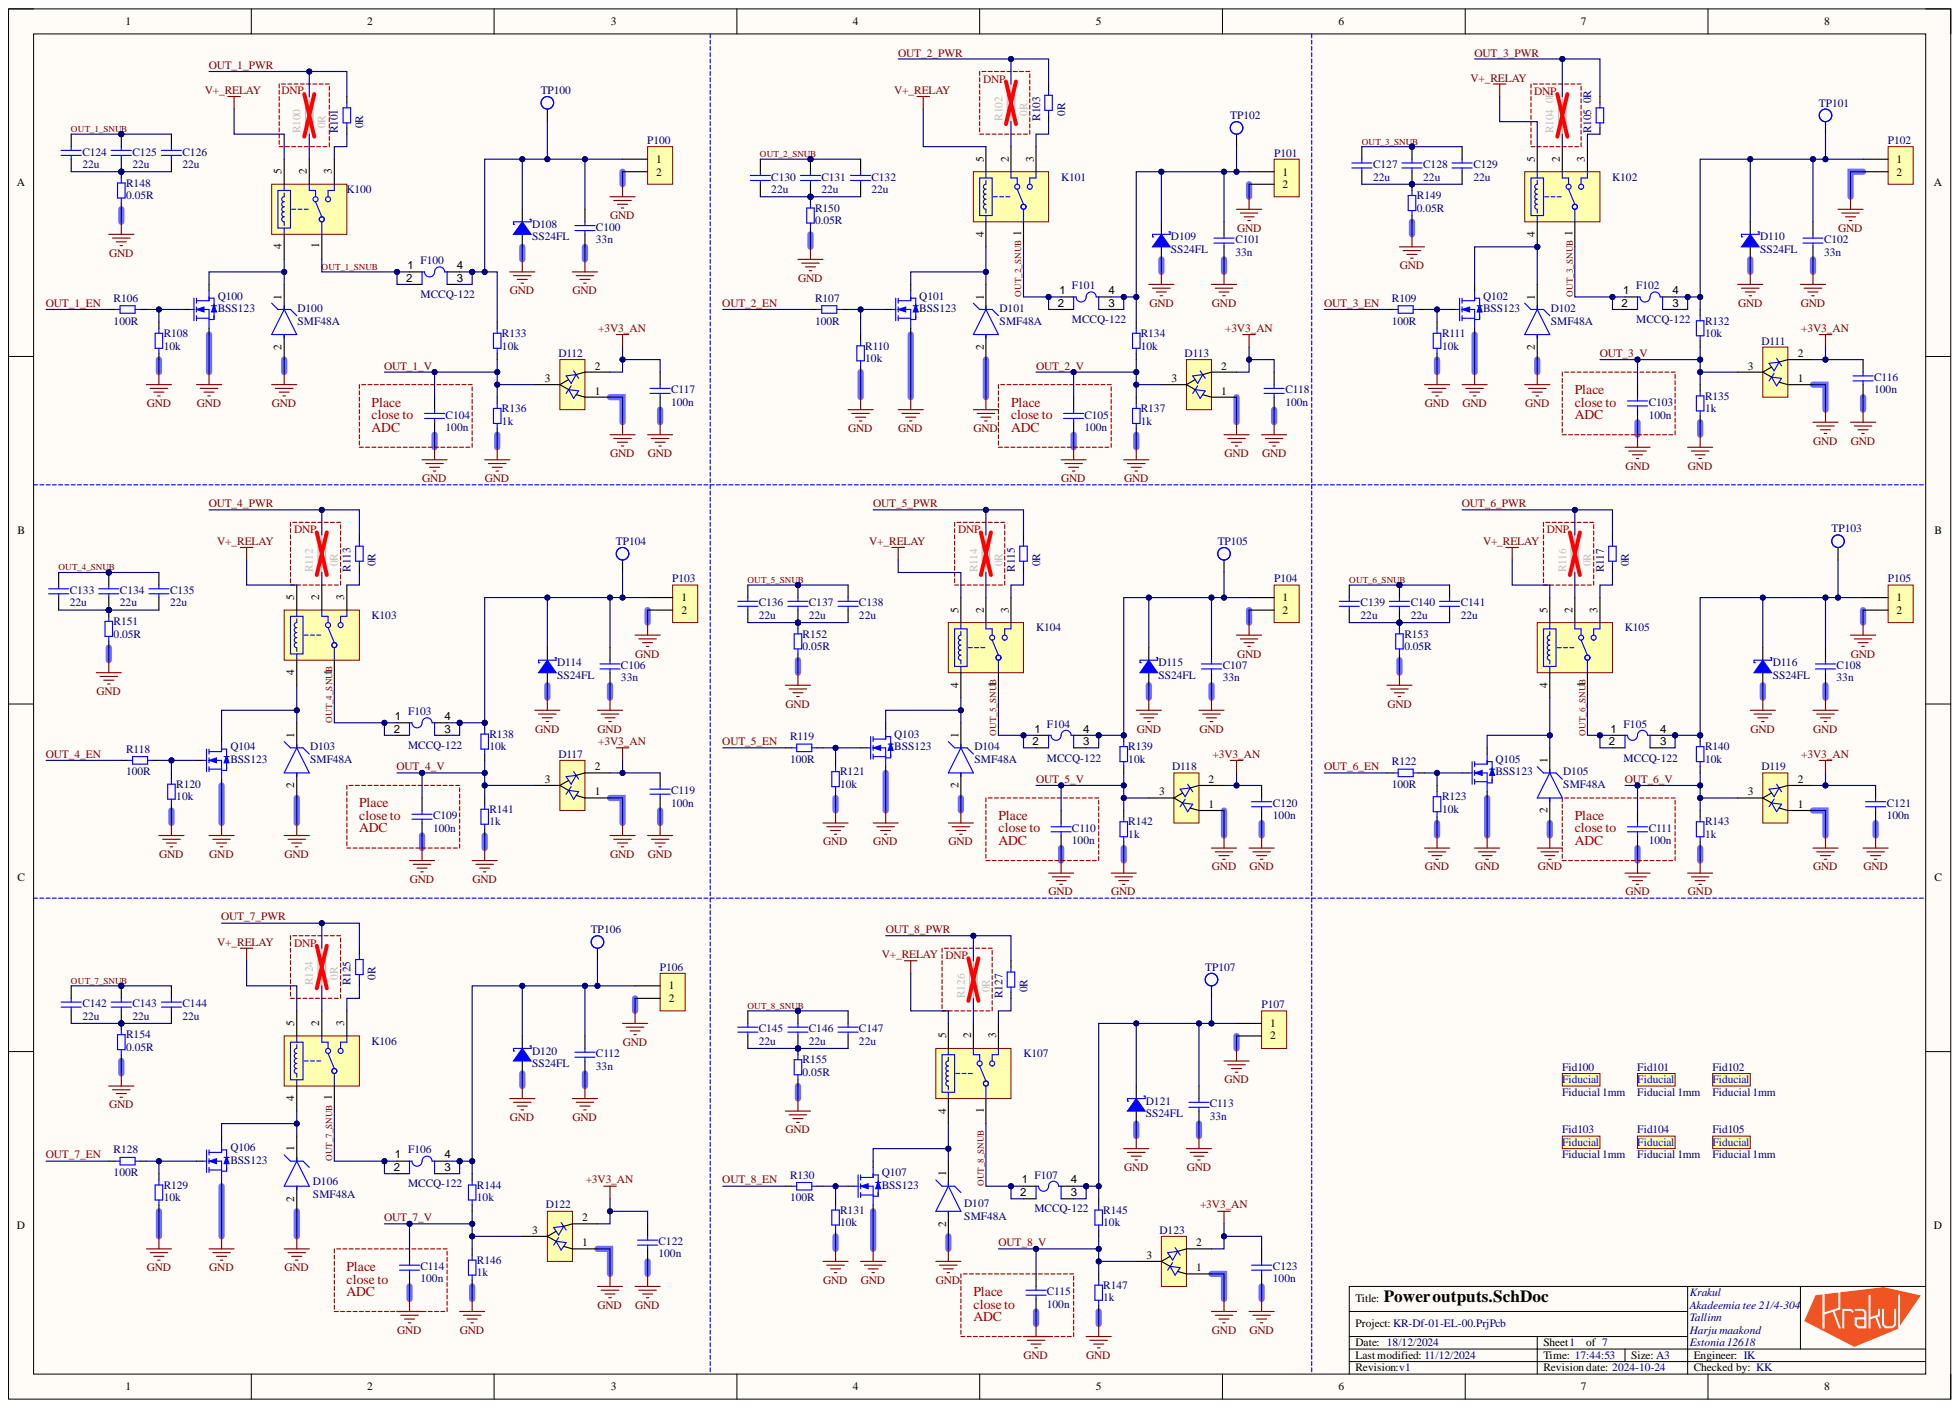
[picture p244: page 1]

Place close to ADC

Project: KR-Df-01-EL-00.PrjPcb
Date:
Revision:

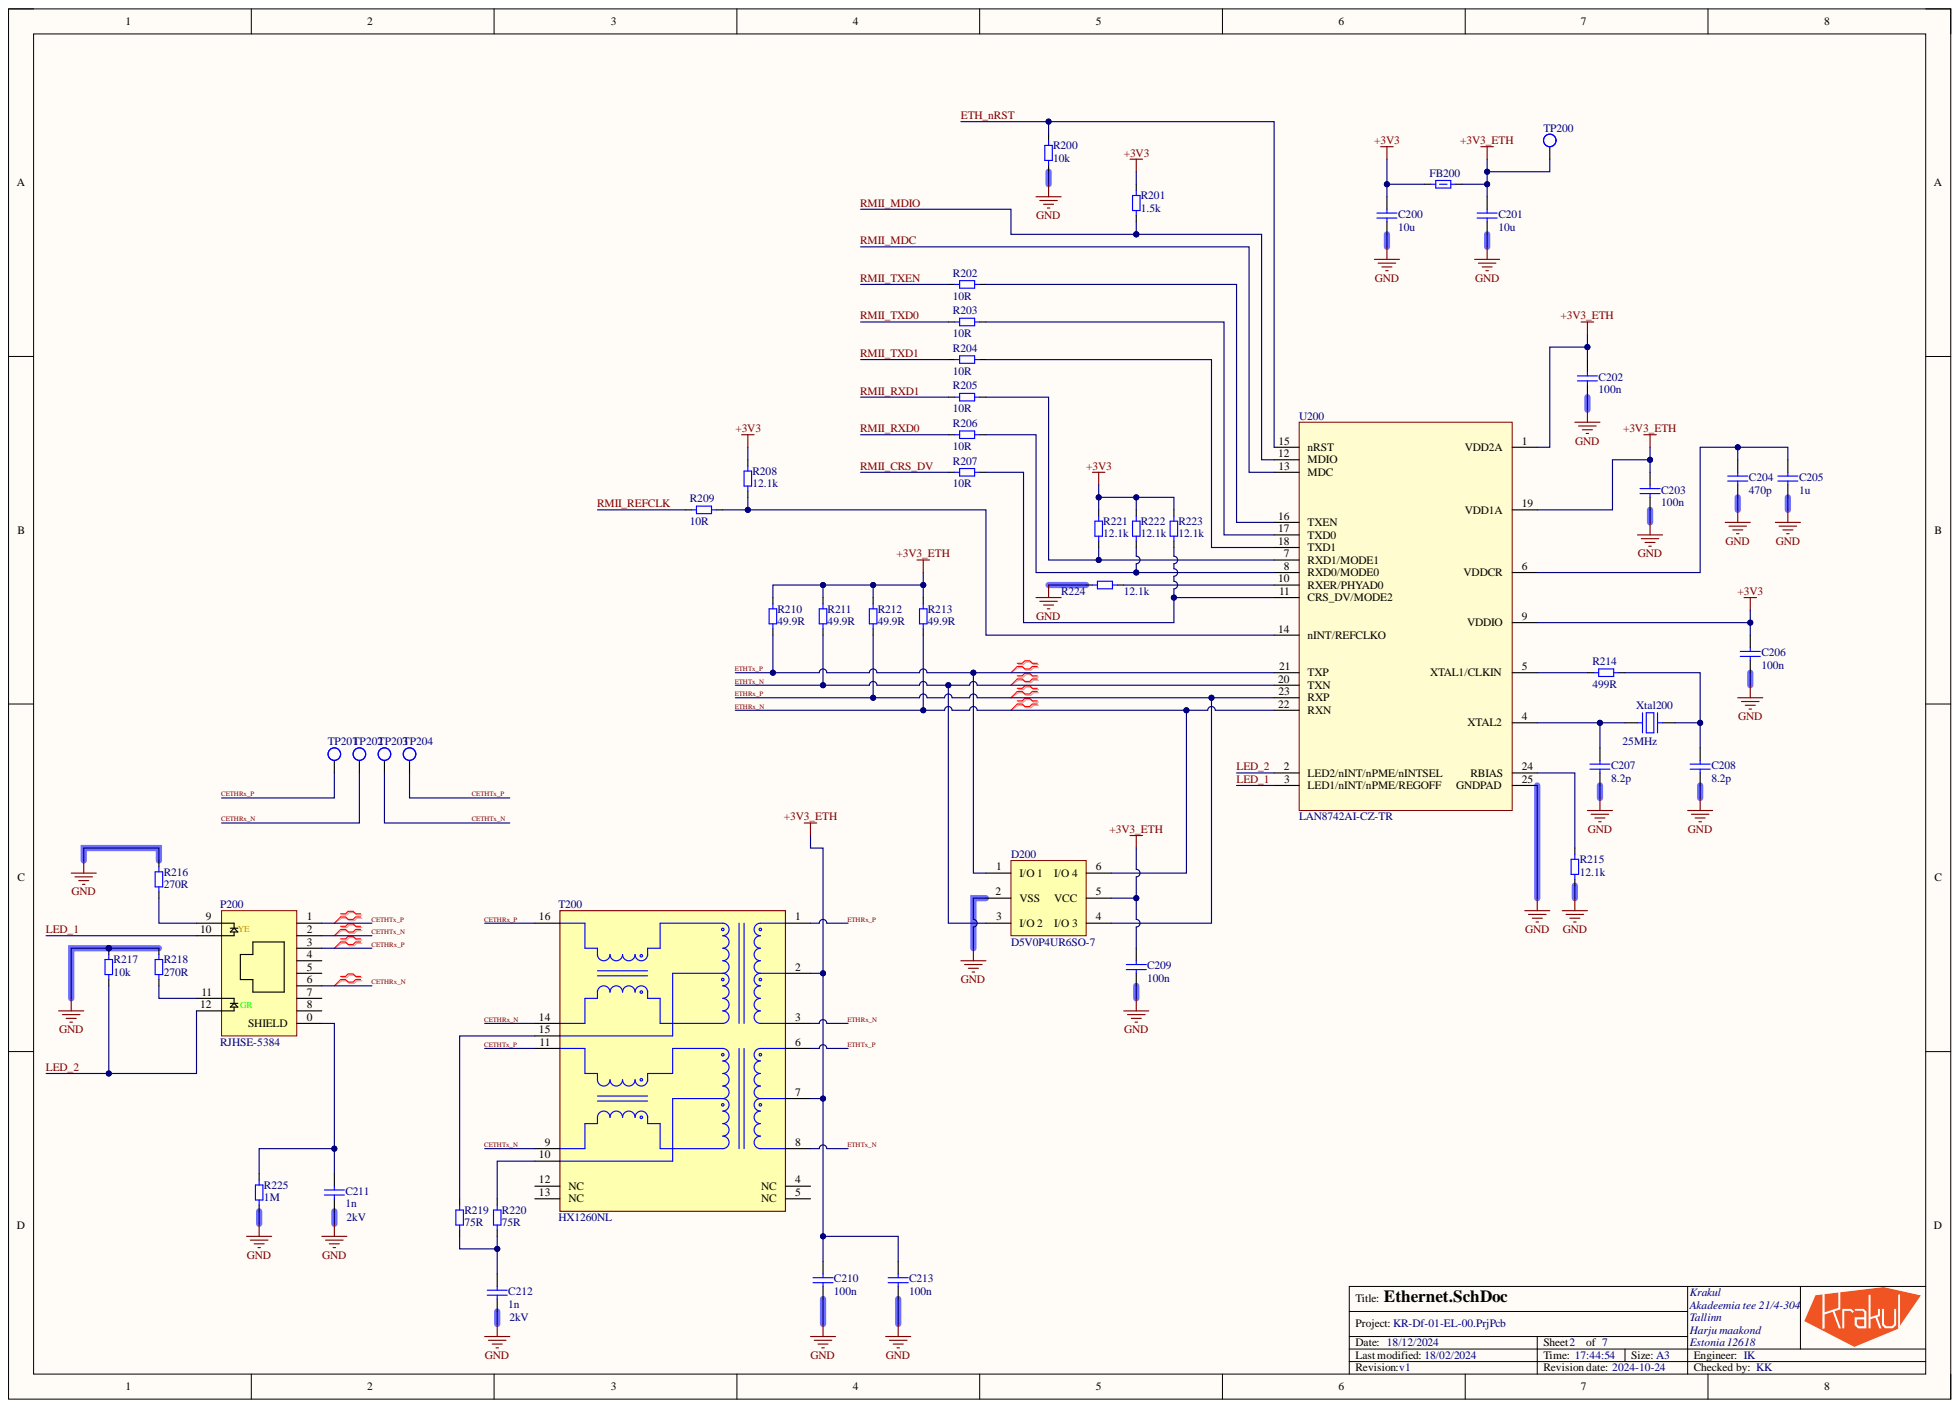
[picture p245: page 2]

TXEN 16
TXD0 17
TXD1 18

+3V3_ETH

RXD0/MODE0 8
RXER/PHYAD0 10 CRS_DV/MODE2 11

RXN 22 RXP 23

D200 | +3V3_ETH | | LED2/nINT/nPME/nINTSEL 2 LED1/nINT/nPME/REGOFF 3

CETHTx_N | 11 9 10

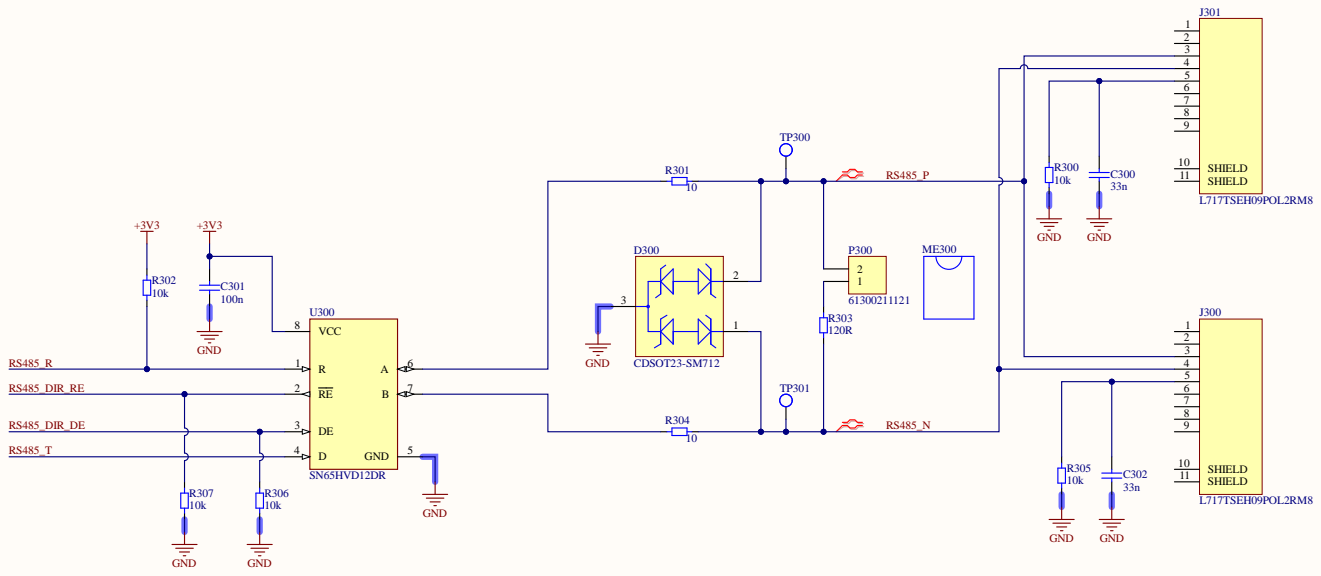
[picture p246: page 3]

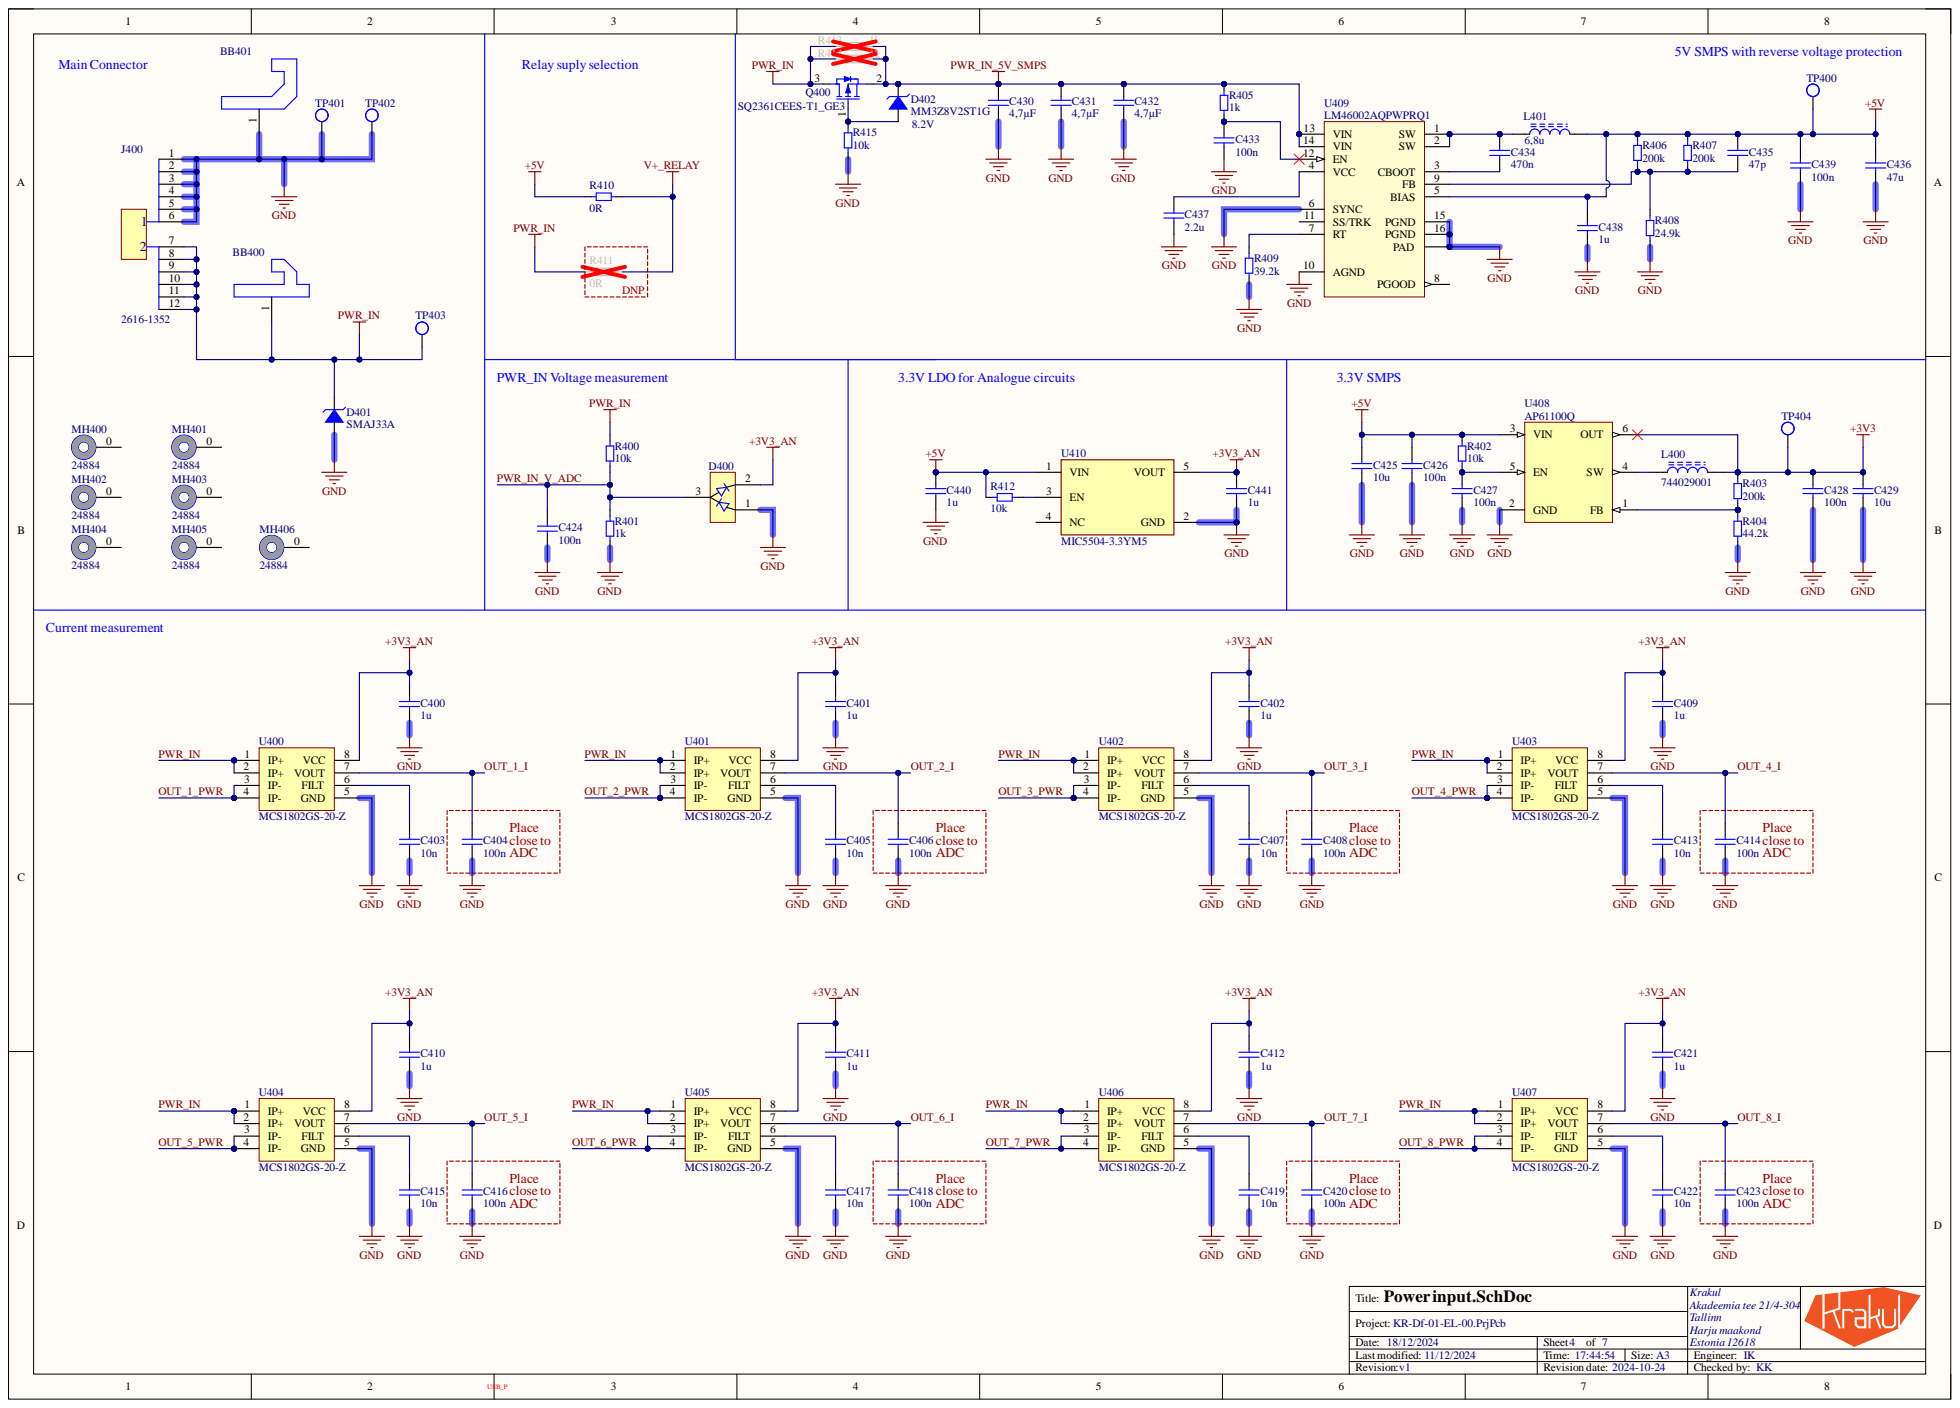
[picture p247: page 4]

5V SMPS with reverse voltage protection

3.3V LDO for Analogue circuits

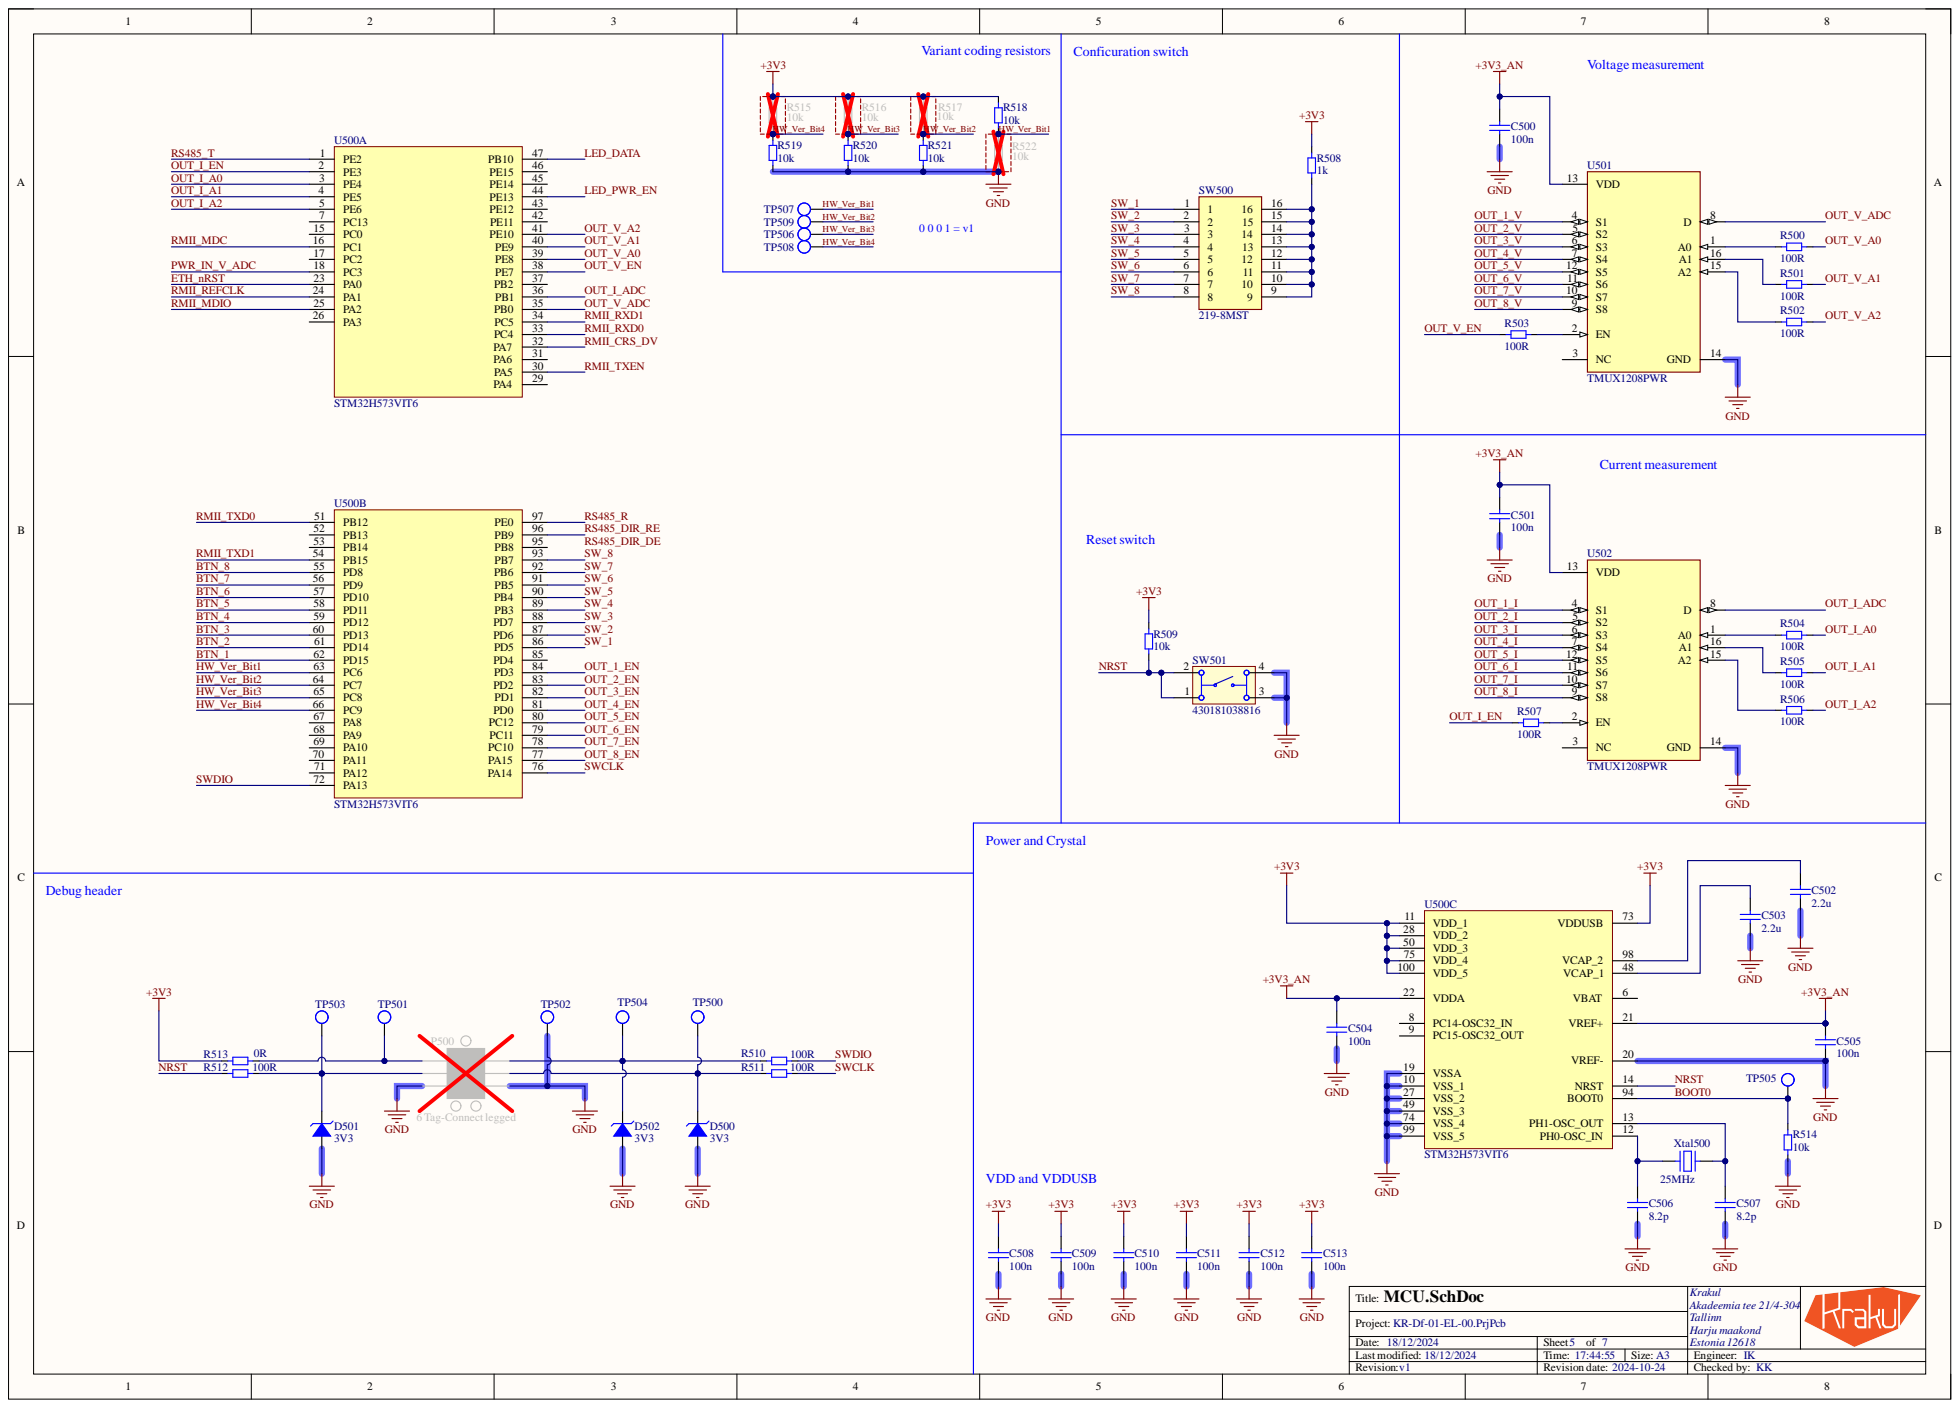
[picture p248: page 5]

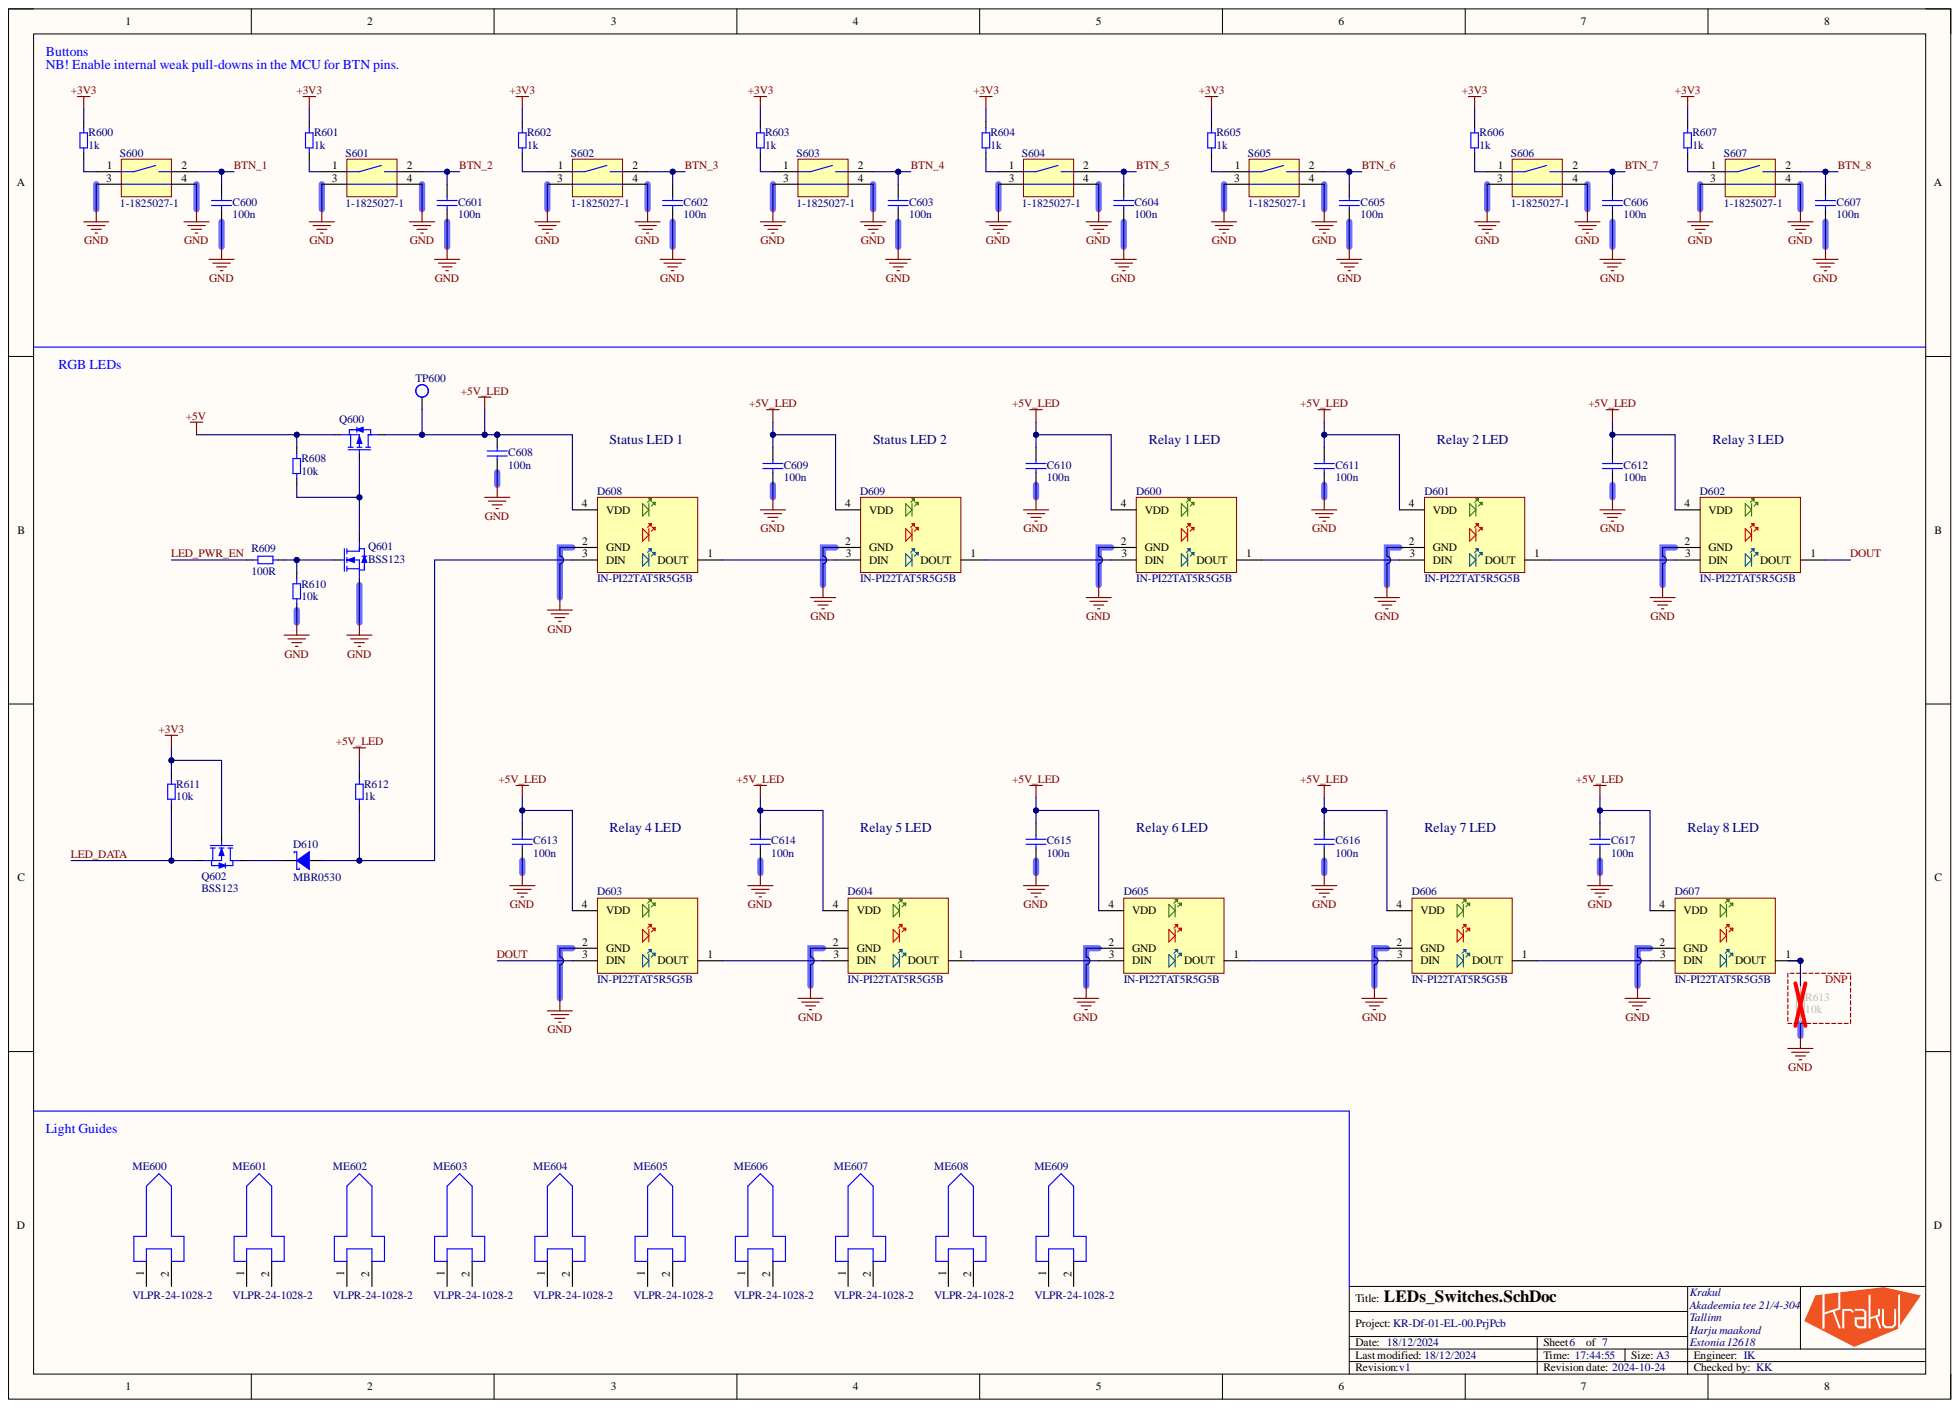
[picture p249: page 6]

Buttons
NB! Enable internal weak pull-downs in the MCU for BTN pins.

D | D
C | C
B | B
A | A

## Revision history.SchDoc

V0

First design. See design descriptions

V0.1

RDB LEDs D600-D608 part number field updated to the correct value

Repopulate R101, R103, R105, R113, R115, R117 R125, R127 Unpopulate R100, R102, R104, R112, R114, R116 R124, R126

V1

K100-K107 schematic symbol NC/NO orientation fixed and DNPmarking moed over the correct resistor. R514 added as pull-down to U500 pin 94 along with TP505 J300 and J301 pin order changed as RS485 dsub specification suggests. Connections adjusted accordingly. Added C124-C147 and R148-R155 as part of snubber circuit for the relays K100-K107 part number replaced with J107F1CS205VDC.45 D600-D609 schematic symbol pin order rearranged according to the manufacture's documentation. Added 3V3 LDO for analogue circuits(U401, C440,C441,R412). Ferrite bead FB500 removed from MCU AVDD path. Added R413, R414, Q400, R415, D402 Added mechanicalstandoffs MH400-MH406 Rearranged P500 pinout to match standard implementation Split RS485 direction control into two signalsfrom MCU
