oleksandrkorkh/Fuse_board/Mechanics/Mechanics/2025.03.05 Case and base plate design/Busbar 2025-01-29/GND and PWR busbar v4.1.pdf

1 | 2 | 3 | 4 | 5 | 6 | 7 | 8

77.45

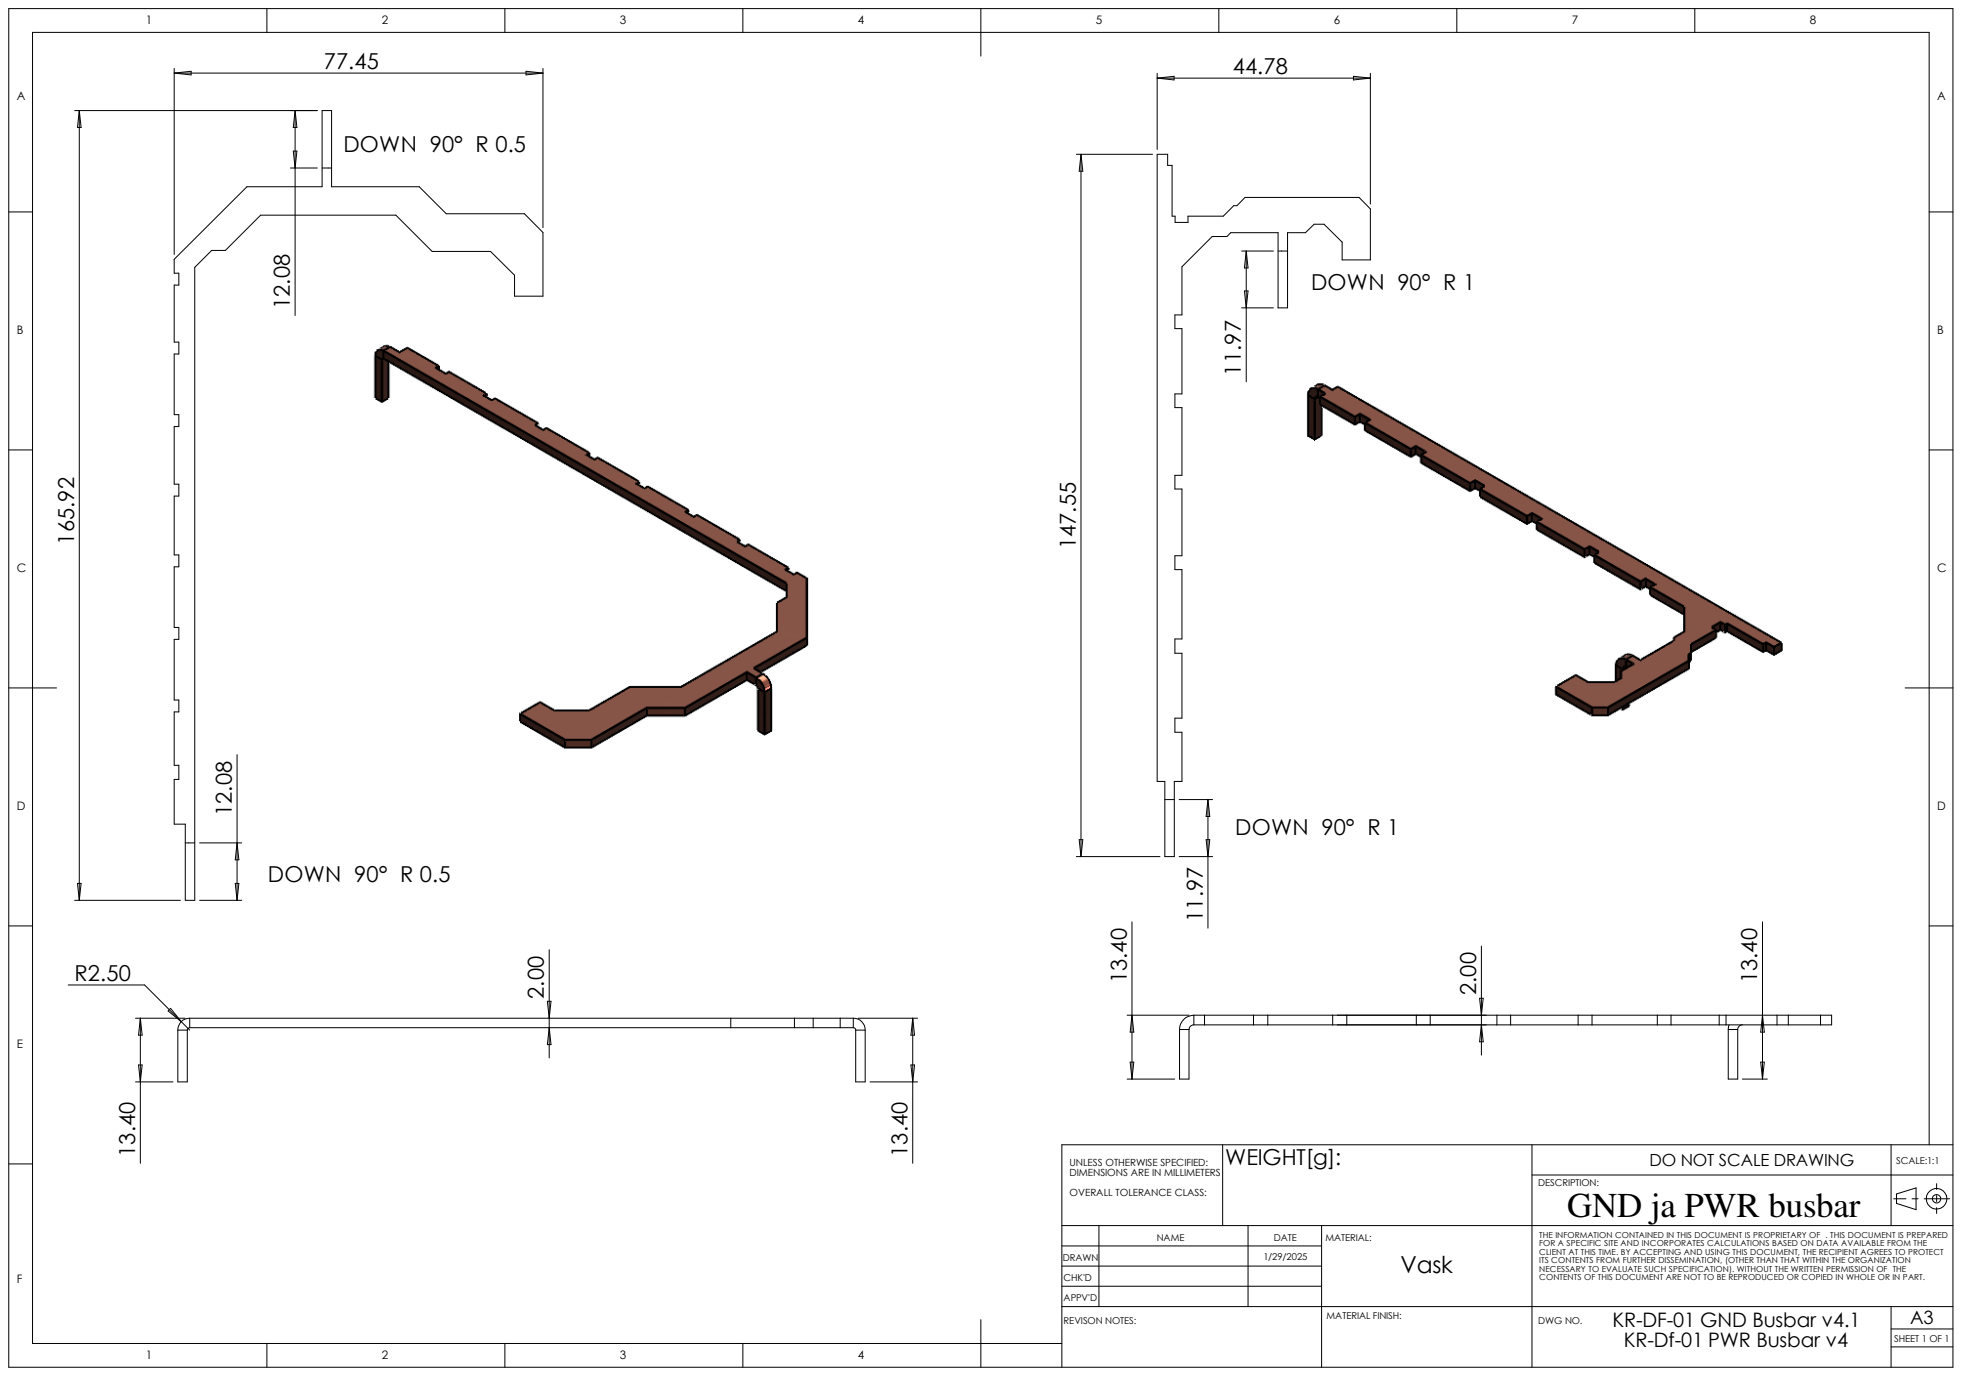
[picture p257: page 1]
SHEET 1 OF 1; DOWN 90° R 0.5; DOWN 90° R 1

UNLESS OTHERWISE SPECIFIED: DIMENSIONS ARE IN MILLIMETERS OVERALL TOLERANCE CLASS: | WEIGHT[g]: | DO NOT SCALE DRAWING | SCALE:1:1

DESCRIPTION: GND ja PWR busbar

NAME | DATE | MATERIAL: Vask | THE INFORMATION CONTAINED IN THIS DOCUMENT IS PROPRIETARY OF . THIS DOCUMENT IS PREPARED FOR A SPECIFIC SITE AND INCORPORATES CALCULATIONS BASED ON DATA AVAILABLE FROM THE CLIENT AT THIS TIME. BY ACCEPTING AND USING THIS DOCUMENT, THE RECIPIENT AGREES TO PROTECT ITS CONTENTS FROM FURTHER DISSEMINATION, (OTHER THAN THAT WITHIN THE ORGANIZATION NECESSARY TO EVALUATE SUCH SPECIFICATION). WITHOUT THE WRITTEN PERMISSION OF THE CONTENTS OF THIS DOCUMENT ARE NOT TO BE REPRODUCED OR COPIED IN WHOLE OR IN PART.

DRAWN | | 1/29/2025

CHK'D

APPV'D
REVISON NOTES: | MATERIAL FINISH: | KR-DF-01 GND Busbar v4.1 DWG NO. KR-Df-01 PWR Busbar v4 | A3
