oleksandrkorkh/Fuse_board/Mechanics/Busbars/GND Busbar v4.1.pdf

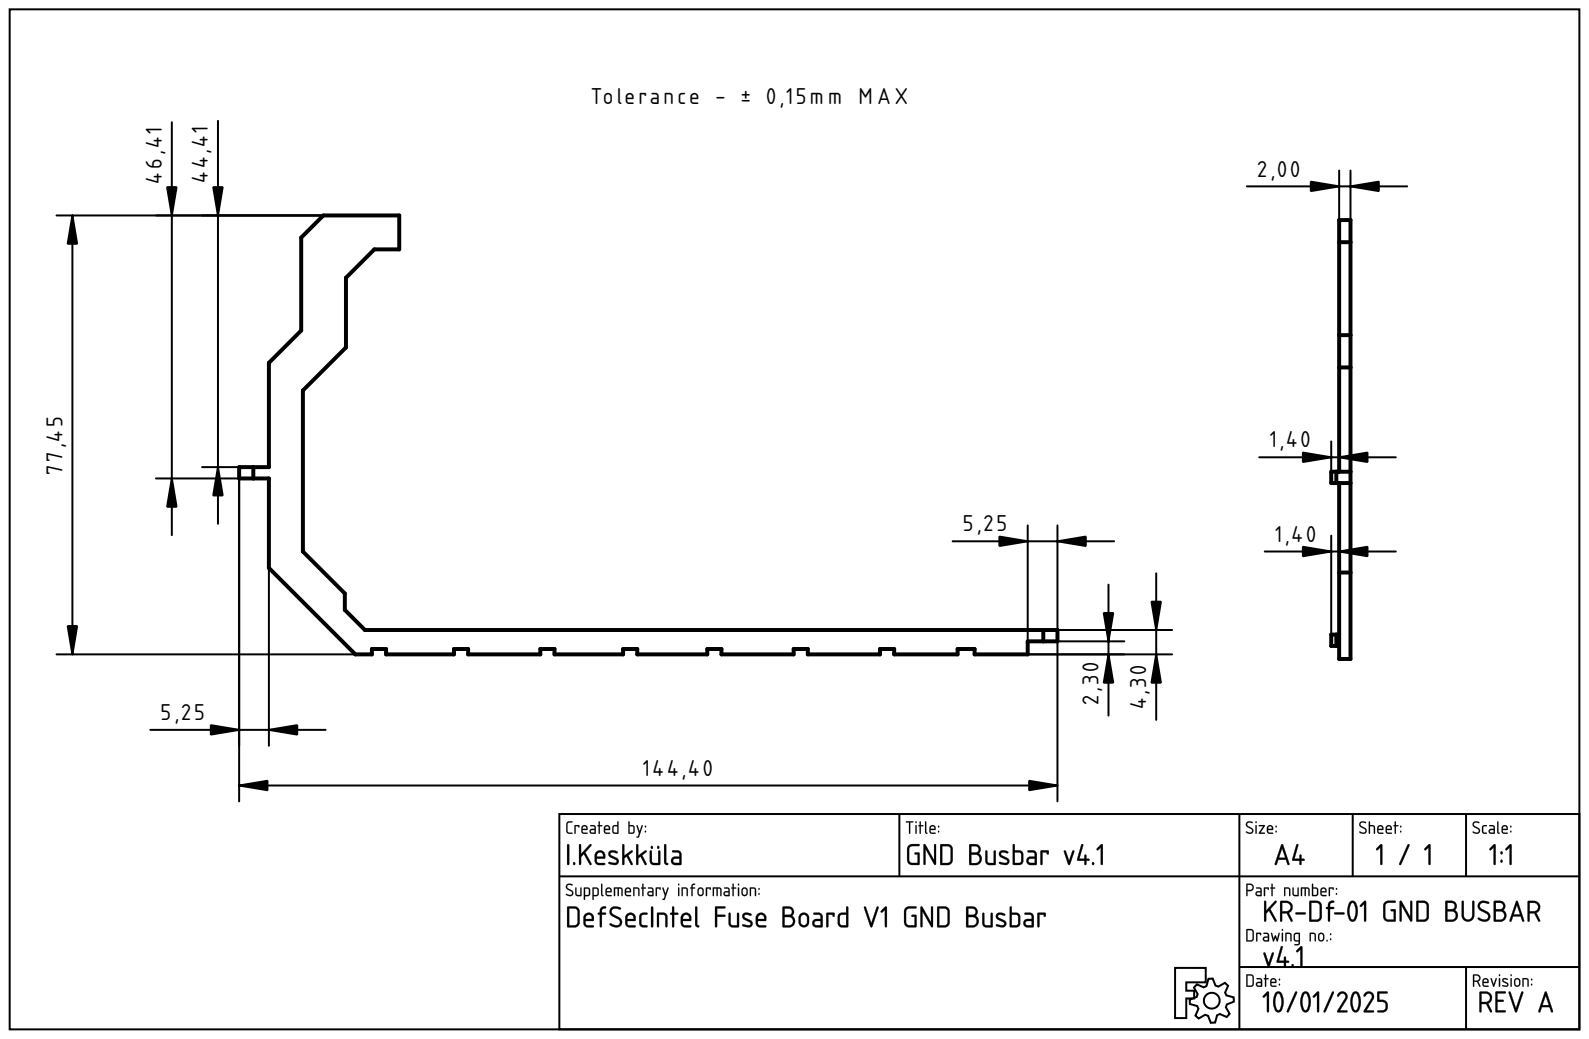
[picture p258: page 1]
Tolerance - ± 0,15m m M A X
