oleksandrkorkh/Fuse_board/Mechanics/Busbars/PWR Busbar v4.pdf

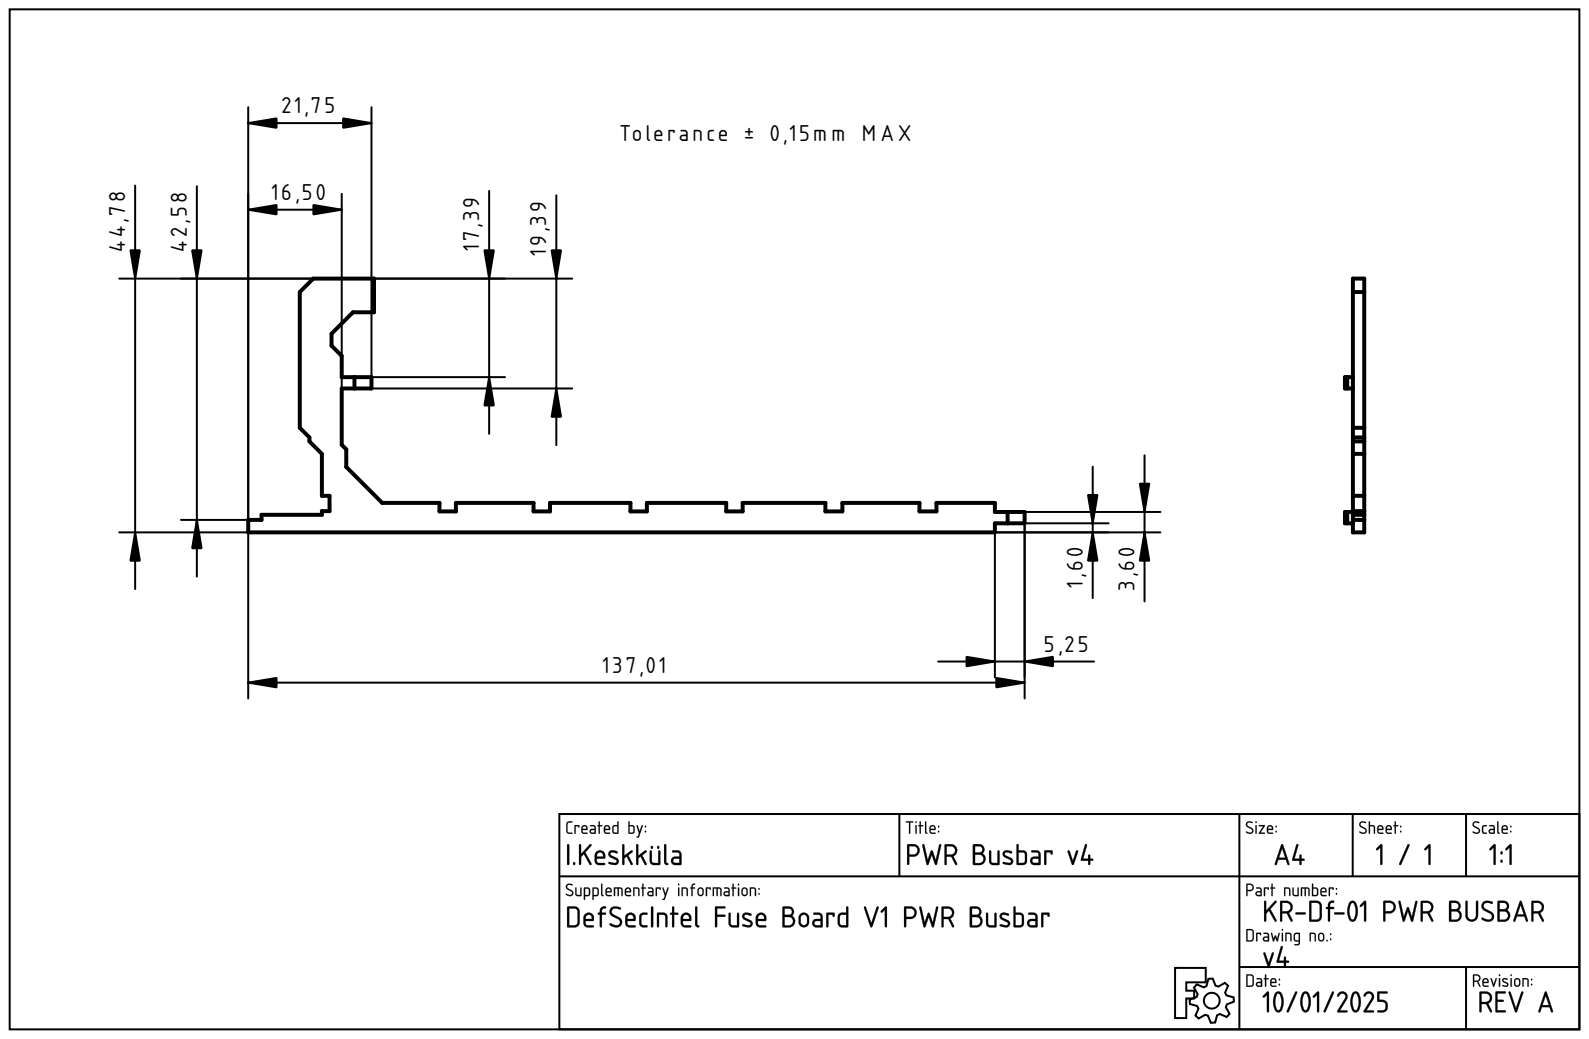
[picture p259: page 1]
Tolerance ± 0,15m m M A X
