oleksandrkorkh/Fuse_board/Electronics/Buttons and LED-s/Level translator.asc

D1: diode; DIODE_1SS389
M1: nmos; RHU003N03
R1: res; 10k
R2: res; 1k
R3: res; 100k
V1: voltage; 3.3V
V2: voltage; 5v
V3: voltage; PULSE(0 3.3 400n 25n 25n 800n 1.25u 10)
Named nets: 0
.tran 10u
*********************************************************************
*  TOSHIBA CORPORATION SEMICONDUCTOR & STORAGE PRODUCTS COMPANY
*  Date                 : 05/01/2015
*  File name            : 1SS389.lib
*  Part Number          : 1SS389
*  Parameter ver.       : Ver.1
*  Simulator            : PSPICE
*  Model call name      : DIODE_1SS389
*  TNOM                 : 25 degree
*********************************************************************
 
.SUBCKT DIODE_1SS389 1 2
D1 1 2 diode
C0 1 2 3.7e-12
.MODEL diode D
+ IS = 9.21e-07
+ N = 0.99
+ ISR = 3.0531e-07
+ NR = 1.2338
+ BV = 10
+ IBV = 2e-05
+ RS = 0.4615
+ CJO = 1.525e-11
+ VJ = 0.9
+ M = 0.89925
+ FC = 0.5
+ TT = 0
+ EG = 0.57
+ XTI = 1.9668
+ AF = 1
+ KF = 0
+ NBV = 1
+ IBVL = 0
+ NBVL = 1
+ TNOM = 25
.ends
