oleksandrkorkh/Fuse_board/Electronics/Voltage measurement/ISO61000-4-2.asc

C1: cap; 150p
C2: cap; 8p
C3: cap; 100n
C4: cap; 0.033µ; V=50 Irms=0 Rser=0 Lser=0 mfg="Murata" pn="GCM155R71H333KE02" type="X7R"
D1: schottky; MBR735
L1: ind; 2.4µ
L2: ind; 140n
R1: res; 330
R2: res; 200
R3: res; 10k
R4: res; 1k
S1: sw
S2: sw
V1: voltage; PULSE(0 1 {td} 1f 1 1 2)
Named nets: 0, C1, C2
.model SW SW(Ron=1 Roff=1G Vt=0.5)
.ic V(C1)=nom_voltage V(C2)=nom_voltage
.param nom_voltage=IEC61000_4_2_test_level*2000
IEC61000-4-2 Test levels:
######################
Contact discharge
######################
Level # Test voltage
######################
#  1  #  2kV
#  2  #  4kV
#  3  #  6kV
#  4  #  8kV
#  X  #  Special
######################
 
Change IEC_61000-4-2_test_level to chose relative Test voltage
e.g. To chose 8kV test voltage edit the .param string as:
.param IEC61000_4_2_test_level=4
.tran 1m
.param IEC61000_4_2_test_level=4
.param td=1p
