oleksandrkorkh/Fuse_board/(list of files, drawings)

Other design files:
Altium project/SRC-KR-Df-01-EL-00-A.3/Ethernet.SchDoc
Altium project/SRC-KR-Df-01-EL-00-A.3/KR-Df-01-EL-00.PrjPcb
Altium project/SRC-KR-Df-01-EL-00-A.3/LEDs_Switches.SchDoc
Altium project/SRC-KR-Df-01-EL-00-A.3/MCU.SchDoc
Altium project/SRC-KR-Df-01-EL-00-A.3/Power input.SchDoc
Altium project/SRC-KR-Df-01-EL-00-A.3/Power outputs.SchDoc
Altium project/SRC-KR-Df-01-EL-00-A.3/Revision history.SchDoc
Altium project/SRC-KR-Df-01-EL-00-A.3/RS485.SchDoc
Electronics/MCU/LIB_STM32H573VIT6/STM32H573VIT6/Altium/QFP50P1600X1600X160-100N.PcbLib
Electronics/MCU/LIB_STM32H573VIT6/STM32H573VIT6/Altium/STM32H573VIT6.SchLib
