oleksandrkorkh/Fuse_board/Firmware/kr-df-01-fuseboard_src_v1.0.0.0/Core/Src/main.c

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
/* Includes ------------------------------------------------------------------*/
#include "app_threadx.h"
#include "main.h"
#include "string.h"

/* USER CODE BEGIN Includes */
#include <stdbool.h>
#include <inttypes.h>
#include "dp_info.h"
#include "watchdog.h"
#include "crc.h"
#include "log.h"
/* USER CODE END Includes */


ETH_TxPacketConfigTypeDef TxConfig;
ETH_DMADescTypeDef  DMARxDscrTab[ETH_RX_DESC_CNT]; /* Ethernet Rx DMA Descriptors */
ETH_DMADescTypeDef  DMATxDscrTab[ETH_TX_DESC_CNT]; /* Ethernet Tx DMA Descriptors */

ADC_HandleTypeDef hadc1;
ADC_HandleTypeDef hadc2;
DMA_NodeTypeDef Node_GPDMA1_Channel1;
DMA_QListTypeDef List_GPDMA1_Channel1;
DMA_HandleTypeDef handle_GPDMA1_Channel1;
DMA_NodeTypeDef Node_GPDMA1_Channel2;
DMA_QListTypeDef List_GPDMA1_Channel2;
DMA_HandleTypeDef handle_GPDMA1_Channel2;

CRC_HandleTypeDef hcrc;

ETH_HandleTypeDef heth;

TIM_HandleTypeDef htim2;
TIM_HandleTypeDef htim3;
DMA_NodeTypeDef Node_GPDMA1_Channel0;
DMA_QListTypeDef List_GPDMA1_Channel0;
DMA_HandleTypeDef handle_GPDMA1_Channel0;

WWDG_HandleTypeDef hwwdg;

void SystemClock_Config(void);
static void MPU_Config(void);
static void MX_GPIO_Init(void);
static void MX_GPDMA1_Init(void);
static void MX_ETH_Init(void);
static void MX_TIM2_Init(void);
static void MX_ICACHE_Init(void);
static void MX_UART8_Init(void);
static void MX_ADC1_Init(void);
static void MX_ADC2_Init(void);
static void MX_TIM3_Init(void);
static void MX_CRC_Init(void);
static void MX_FLASH_Init(void);
static void MX_WWDG_Init(void);
/**
  * @brief  The application entry point.
  * @retval int
  */
int main(void)
{

  /* USER CODE BEGIN 1 */

  /* Try to read device info from OTP memory */
  dp_init_device_info();
  log_init();

  /* USER CODE END 1 */

  /* MCU Configuration--------------------------------------------------------*/

  /* MPU Configuration--------------------------------------------------------*/
  MPU_Config();

  /* Reset of all peripherals, Initializes the Flash interface and the Systick. */
  HAL_Init();

  /* Configure the system clock */
  SystemClock_Config();

  /* Initialize all configured peripherals */
  MX_GPIO_Init();
  MX_GPDMA1_Init();
  MX_ETH_Init();
  MX_TIM2_Init();
  MX_ICACHE_Init();
  MX_UART8_Init();
  MX_ADC1_Init();
  MX_ADC2_Init();
  MX_TIM3_Init();
  MX_CRC_Init();
  MX_FLASH_Init();
  MX_WWDG_Init();
  /* USER CODE BEGIN 2 */
  crc_gen_init();

  /* Print device info */
  ULOG_DEBUG("S/N: %" PRIu32 ", HW: %" PRIu32 ", MAC: %02X:%02X:%02X:%02X:%02X:%02X",
      dp_get_serial_number(), (uint32_t)dp_get_hw_revision(),
      heth.Init.MACAddr[0], heth.Init.MACAddr[1], heth.Init.MACAddr[2],
      heth.Init.MACAddr[3], heth.Init.MACAddr[4], heth.Init.MACAddr[5]);

  /* USER CODE END 2 */

  MX_ThreadX_Init();

  /* We should never get here as control is now taken by the scheduler */

  /* Infinite loop */
  /* USER CODE BEGIN WHILE */
  while (1)
  {
    /* USER CODE END WHILE */

    /* USER CODE BEGIN 3 */
  }
  /* USER CODE END 3 */
}

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
 /* MPU Configuration */

void MPU_Config(void)
{
  MPU_Region_InitTypeDef MPU_InitStruct = {0};
  MPU_Attributes_InitTypeDef MPU_AttributesInit = {0};

  /* Disables the MPU */
  HAL_MPU_Disable();

  /** Initializes and configures the Region and the memory to be protected
  */
  MPU_InitStruct.Enable = MPU_REGION_ENABLE;
  MPU_InitStruct.Number = MPU_REGION_NUMBER0;
  MPU_InitStruct.BaseAddress = 0x08fff800;
  MPU_InitStruct.LimitAddress = 0x08fff900;
  MPU_InitStruct.AttributesIndex = MPU_ATTRIBUTES_NUMBER0;
  MPU_InitStruct.AccessPermission = MPU_REGION_ALL_RO;
  MPU_InitStruct.DisableExec = MPU_INSTRUCTION_ACCESS_DISABLE;
  MPU_InitStruct.IsShareable = MPU_ACCESS_OUTER_SHAREABLE;

  HAL_MPU_ConfigRegion(&MPU_InitStruct);
  MPU_AttributesInit.Number = MPU_REGION_NUMBER0;
  MPU_AttributesInit.Attributes = MPU_DEVICE_nGnRnE | MPU_WRITE_THROUGH
                              | MPU_TRANSIENT | MPU_R_ALLOCATE;

  HAL_MPU_ConfigMemoryAttributes(&MPU_AttributesInit);

  /** Initializes and configures the Region and the memory to be protected
  */
  MPU_InitStruct.Number = MPU_REGION_NUMBER1;
  MPU_InitStruct.BaseAddress = 0x9000000;
  MPU_InitStruct.LimitAddress = 0x9017FFF;
  MPU_InitStruct.AttributesIndex = MPU_ATTRIBUTES_NUMBER1;
  MPU_InitStruct.AccessPermission = MPU_REGION_ALL_RW;
  MPU_InitStruct.IsShareable = MPU_ACCESS_NOT_SHAREABLE;

  HAL_MPU_ConfigRegion(&MPU_InitStruct);
  MPU_AttributesInit.Number = MPU_REGION_NUMBER1;
  MPU_AttributesInit.Attributes = MPU_DEVICE_nGnRnE | MPU_WRITE_THROUGH
                              | MPU_NON_TRANSIENT | MPU_NO_ALLOCATE;

  HAL_MPU_ConfigMemoryAttributes(&MPU_AttributesInit);
  /* Enables the MPU */
  HAL_MPU_Enable(MPU_PRIVILEGED_DEFAULT);

}

/**
  * @brief  Period elapsed callback in non blocking mode
  * @note   This function is called  when TIM6 interrupt took place, inside
  * HAL_TIM_IRQHandler(). It makes a direct call to HAL_IncTick() to increment
  * a global variable "uwTick" used as application time base.
  * @param  htim : TIM handle
  * @retval None
  */
void HAL_TIM_PeriodElapsedCallback(TIM_HandleTypeDef *htim)
{
  if (htim->Instance == TIM6) {
    HAL_IncTick();
  }
}

/**
  * @brief  This function is executed in case of error occurrence.
  * @retval None
  */
void Error_Handler(void)
{
  /* USER CODE BEGIN Error_Handler_Debug */
  /* User can add his own implementation to report the HAL error return state */
  __disable_irq();
  ULOG_CRITICAL("ErrorHandler entered.");
  while (1)
  {
  }
  /* USER CODE END Error_Handler_Debug */
}

#ifdef  USE_FULL_ASSERT
/**
  * @brief  Reports the name of the source file and the source line number
  *         where the assert_param error has occurred.
  * @param  file: pointer to the source file name
  * @param  line: assert_param error line source number
  * @retval None
  */
void assert_failed(uint8_t *file, uint32_t line)
{
  /* USER CODE BEGIN 6 */
  /* User can add his own implementation to report the file name and line number,
     ex: printf("Wrong parameters value: file %s on line %d\r\n", file, line) */
  UNUSED(file);
  UNUSED(line);
  /* USER CODE END 6 */
}
#endif /* USE_FULL_ASSERT */
