oleksandrkorkh/Fuse_board/Firmware/kr-df-01-fuseboard_src_v1.0.0.0/defsecintel-fuseboard.ioc

Mcu.UserName=STM32H573VITx
PA0.GPIO_Label=ETH_nRST
PA0.Signal=GPIO_Output
PA1.Signal=ETH_REF_CLK
PA13(JTMS/SWDIO).Signal=DEBUG_JTMS-SWDIO
PA14(JTCK/SWCLK).Signal=DEBUG_JTCK-SWCLK
PA15(JTDI).GPIO_Label=OUT_8_EN
PA15(JTDI).Signal=GPIO_Output
PA2.Signal=ETH_MDIO
PA5.Signal=ETH_TX_EN
PA7.Signal=ETH_CRS_DV
PB0.GPIO_Label=ADC2_VOLTAGE
PB0.Signal=SharedAnalog_PB0
PB1.GPIO_Label=ADC1_CURRENT
PB1.Signal=ADCx_INP5
PB10.GPIO_Label=LED_DATA
PB10.Signal=S_TIM2_CH3
PB12.Signal=ETH_TXD0
PB15.Signal=ETH_TXD1
PB3(JTDO/TRACESWO).GPIO_Label=SW_4
PB3(JTDO/TRACESWO).Signal=GPIO_Input
PB4(NJTRST).GPIO_Label=SW_5
PB4(NJTRST).Signal=GPIO_Input
PB5.GPIO_Label=SW_6
PB5.Signal=GPIO_Input
PB6.GPIO_Label=SW_7
PB6.Signal=GPIO_Input
PB7.GPIO_Label=SW_8
PB7.Signal=GPIO_Input
PB8.GPIO_Label=RS485_DE
PB8.Signal=GPIO_Output
PB9.GPIO_Label=RS485_RE
PB9.Signal=GPIO_Output
PC1.Signal=ETH_MDC
PC10.GPIO_Label=OUT_7_EN
PC10.Signal=GPIO_Output
PC11.GPIO_Label=OUT_6_EN
PC11.Signal=GPIO_Output
PC12.GPIO_Label=OUT_5_EN
PC12.Signal=GPIO_Output
PC3.Signal=SharedAnalog_PC3
PC4.Signal=ETH_RXD0
PC5.Signal=ETH_RXD1
PD0.GPIO_Label=OUT_4_EN
PD0.Signal=GPIO_Output
PD1.GPIO_Label=OUT_3_EN
PD1.Signal=GPIO_Output
PD10.GPIO_Label=BTN_6
PD10.Signal=GPIO_Input
PD11.GPIO_Label=BTN_5
PD11.Signal=GPIO_Input
PD12.GPIO_Label=BTN_4
PD12.Signal=GPIO_Input
PD13.GPIO_Label=BTN_3
PD13.Signal=GPIO_Input
PD14.GPIO_Label=BTN_2
PD14.Signal=GPIO_Input
PD15.GPIO_Label=BTN_1
PD15.Signal=GPIO_Input
PD2.GPIO_Label=OUT_2_EN
PD2.Signal=GPIO_Output
PD3.GPIO_Label=OUT_1_EN
PD3.Signal=GPIO_Output
PD5.GPIO_Label=SW_1
PD5.Signal=GPIO_Input
PD6.GPIO_Label=SW_2
PD6.Signal=GPIO_Input
PD7.GPIO_Label=SW_3
PD7.Signal=GPIO_Input
PD8.GPIO_Label=BTN_8
PD8.Signal=GPIO_Input
PD9.GPIO_Label=BTN_7
PD9.Signal=GPIO_Input
PE0.GPIO_Label=RS485_RX
PE0.Signal=UART8_RX
PE10.GPIO_Label=OUT_V_A2
PE10.Signal=GPIO_Output
PE13.GPIO_Label=LED_PWR_EN
PE13.Signal=GPIO_Output
PE2.GPIO_Label=RS485_TX
PE2.Signal=UART8_TX
PE3.GPIO_Label=OUT_I_EN
PE3.Signal=GPIO_Output
PE4.GPIO_Label=OUT_I_A0
PE4.Signal=GPIO_Output
PE5.GPIO_Label=OUT_I_A1
PE5.Signal=GPIO_Output
PE6.GPIO_Label=OUT_I_A2
PE6.Signal=GPIO_Output
PE7.GPIO_Label=OUT_V_EN
PE7.Signal=GPIO_Output
PE8.GPIO_Label=OUT_V_A0
PE8.Signal=GPIO_Output
PE9.GPIO_Label=OUT_V_A1
PE9.Signal=GPIO_Output
PH0-OSC_IN(PH0).Signal=RCC_OSC_IN
PH1-OSC_OUT(PH1).Signal=RCC_OSC_OUT
