oleksandrkorkh/Fuse_board/Firmware/kr-df-01-fuseboard_src_v1.0.0.0/Application/Board/board.h

#pragma once

namespace board
{

struct BoardStatus
{
  float temperature; // Board temperature (C)
  float v_in;        // Voltage in (V)
};

void handle_board_data();
BoardStatus get_board_status();

void initialize_board_data();

}
