oleksandrkorkh/Fuse_board/(commit log)

2025-12-12 Altium project
    [Ethernet.SchDoc, KR-Df-01-EL-00.PrjPcb, LEDs_Switches.SchDoc, MCU.SchDoc, Power input.SchDoc, Power outputs.SchDoc, RS485.SchDoc, Revision history.SchDoc]
2025-12-12 production files
    [BOM_KR-Df-01-EL-00_vv1_2024-12-20.xlsx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]
