oleksandrkorkh/Fuse_board/(notices)

Notices in the files:
Firmware/kr-df-01-fuseboard_src_v1.0.0.0/NetXDuo/App/app_netxduo.c:
Copyright (c) 2024 STMicroelectronics.
All rights reserved.
This software is licensed under terms that can be found in the LICENSE file
Electronics/Power Input/WAGO_26161352/2616-1352.stp:
author */ ('License CC BY-ND 4.0'),
